TiamDesigns/Dachshund70/PROGRESS.md

# PROGRESS

## Current phase

Phase 15 (desktop packaging and auto-update) is done, and with it every phase in SPEC.md. Phases 1 to 14 and the Pup test board are merged to main. Core, host-lib, Doghouse and the desktop app's Rust tests pass locally, and the keyboard, Pup and dongle firmware build with no new warnings. Hardware testing for phases 2 to 14 waits for fabricated boards (or the Nordic nRF52840 Dongles Tiam is ordering: one runs the Pup, the other the receiver). What's left is in `SCHEDULED_TASKS.md`: bring-up and measurements on hardware, encrypting the 2.4 GHz link, and code signing for the desktop app.

## Done

### Sharp memory LCD screen (2026-11-11)

- Tiam chose the Sharp LS027B7DH01 (2.7", 400 × 240, about 173 ppi, a full frame in about 50 ms) for the wider screen column beside the 2u encoder. It replaces the 2.13" e-paper.
- Screen board rev 2.0 (`hardware/Dachshund70-Screen/`, `gen_screen.py`), same 21.0 × 34.0 mm outline and J2 position:
  - U1 TPS61222 (fixed 5 V boost, SC-70-6) from 3V3, with L1 4.7 µH and 10 µF in and out. Its EN is on J4 pin 8 (P0.24), pulled up by R1, so it stays on unless the firmware drives the pin low.
  - J1: Hirose FH12-10S for the panel's tail, which folds back under the glass's left edge (in portrait). J1 pin n = panel pin 11 − n, assumed from the fold; to check against Sharp's drawing.
  - Sharp's capacitors on VDD, VDDA and DISP; EXTMODE high (VCOM follows EXTCOMIN).
  - Hand-routed. ERC 0; DRC with parity and every severity: 0 violations, 0 unconnected.
- No mainboard change: J4's pins carry SI, SCLK, SCS, EXTCOMIN, DISP and the boost enable (the screen board README has the table).
- Firmware: new overlay `sharp-ls027b7dh01-portrait` (Zephyr's `sharp,ls0xx`, 2 MHz SPI, CS active high, EXTCOMIN at 1 Hz; 240 × 400 in portrait, 24 × 25 text cells), with a CI build. `dachshund,display-rotate` and `kb_screen_rotate()` now also handle row-tiled 1-bit panels like the Sharp's, with host tests for both layouts.
- Core and host-lib tests pass locally. The Sharp firmware build is checked by CI only. Not tested on hardware, nothing ordered. The case model still has the e-paper (`SCHEDULED_TASKS.md`).

### Screen board and FFC display port (2026-11-11) (rev 1.0, e-paper; superseded by the Sharp panel above)

- Screen options compared (OLED, faster e-paper, Sharp/JDI memory LCD); Tiam kept the 2.13" SSD1680 e-paper and chose to build our own driver board. Every SSD1680/SSD1681 panel bottoms out at about 0.3 s per partial refresh. The GDEY0213B74H (296 × 144, same outline and pins) also fits, but GoodDisplay lists it as end of life.
- New `hardware/Dachshund70-Screen/`, made by `gen_screen.py`:
  - 21.0 × 34.0 × 0.8 mm, 2 layers, every part on the bottom side, drawn in mainboard coordinates.
  - The SSD1680 boost circuit (L1 10 µH, AO3400A, 0.47 Ω sense, 3 × B5819W, 25 V caps on the ±20 V rails) and BS1 low, for 4-wire SPI.
  - J1: Hirose FH12-24S for the panel's tail. J2: FH12-8S for the cable.
  - Hand-routed, with ground pours on both sides. ERC 0; DRC with parity and every severity: 0.
- Mainboard J4: the 2.54 mm header is now an FH12-8S FFC socket on the top side at (327.9, 94.9), under the plate's screen notch. The pin order is unchanged, so `board.json`, the devicetree and the overlays didn't change.
  - Schematic: `Conn_01x08_MountingPin`, MP on GND, MPN set.
  - Board: the eight display nets were rerouted (`hardware/Dachshund70-Screen/move_j4.py` records the edit), three GND stitching vias were removed and the pours refilled. DRC: 0 unconnected items, parity clean; ERC unchanged.
- An 8-way 0.5 mm FFC with contacts on the same side at both ends loops from J4 up through the notch into J2, straight above it. J4 pin n meets J2 pin 9 − n.
- Plate: the J4 slot is gone. `gen_plate.py` was rerun; the regenerated plate also has the sock outlines on Cmts.User again.
- `export_fab.py` and `export_step.py` now include the screen board. Its STEP shares the mainboard's origin.
- Docs updated: the screen board's README, "Display" in the case README, the wiring section of `firmware/displays/README.md`.
- Not tested on hardware, nothing ordered. Open checks are in the screen board README: the panel FPC's contact side and pin 1, the tail length, the FFC length, LCSC numbers, the boost current on 3V3, and the case model update.

### Case round 5: 24 mm-neck plate, longer retainers, encoder cable, daughterboard lower, slider button, floating-plate check (2026-11-10)

- Plate: the coordinator's 24 mm necks and 2.8 arms (1d0be44) are in the model. The encoder notch now runs forward from x 305.25 to the right-hand edge, down to KiCad y 104.5 (was to x 322.25 and y 67.25): the cover's front mount, the knob's underside (it was 0.8 over the plate) and the e-paper driver's parts (0.3 over it) have no plate under them when it floats. `gen_plate.py` rerun (DRC 0), DXF re-exported, README's prong and sock numbers updated.
- Gasket retainers 64.1 × 5.2 × 4.1 (were 44.1 × 4.55), ears unchanged (±18.0, |y| 68.4, R1.0 where they meet the wider bar). One opening per nub from the ring up to the sock tops (64.3 × 5.3, z to 8.1): neck, arms and socks (5.9 past the edge), 1.25 or more round the arms, 4.0 or more of aluminium to the bezel's outside. The longer bars reached the back M3 screws at x −50.5 (0.25) and +50.5 (through it), so those two screws moved to x −61.35 and +39.5 (holes square to the plate, copied from the one at −151.5); the ring's DXF follows.
- Encoder cable (KiCad): the module's J1 faced its plug into the mainboard's notch edge. J1 now faces +u (rot 270 on B.Cu, renumbered so a parallel-wire cable is reversed: pin n to J5 pin 6 − n; the module's schematic labels follow) and the mainboard's J5 moved 3.04 forward to (329.8, 49.54), on the same line: the cable runs straight under the module, mouths 17.6 apart, about 25 mm overall, 7.4 under the plate. Its board-name silk moved clear of J5. DRC 0 unconnected and parity clean on both boards (warnings as before), module ERC 0. No MCU pin changes. Trim the encoder's pins underneath: the cable touches the push switch's uncut pins in the model. A cable stand-in (5 wires) is in the model.
- Encoder cover: the front mount moved 0.625 to x 131.2 with an R2.7 ear (was R4.0), its underside raised to z 2.9 (the mainboard floats too); the old ear's stub under the plate web is gone. Ear, screw and boss are 1.5, 2.9 and 1.7 from the plate in plan anywhere in ±1.0, and 1.39 over the mainboard. Hood outside unchanged. The foot and its two module-screw bosses stay 0.15 beside the plate's web and reliefs (they can't move without moving the module's holes and the mainboard's lobe).
- Daughterboard 1.0 lower (nothing below stopped it): underside at z 6.0 above the desk, USB-C centre at z 9.23 (were 7.0 and 10.23). The opening, lead-in, ledge, leg relief and taps moved with it (1.2 of floor under the taps, 2.0 of aluminium under the ring).
- Power switch: the small cap is now a pill button 10.7 × 6.0 × 0.85 flush with the back face, in a channel with the USB-C lead-in's outline (12.6 × 6.4, R3.2) on the USB-C's centre height; a stem on its back (0.83 below the centre line) goes through a 4.4 × 2.2 slot onto the PCM12's lever. 0.2 clear top and bottom, 0.15 off the floor, 1.5 travel; the button hides the slot at both ends. Plain pockets, no undercuts. Still a 2-position battery switch (Bluetooth or tri-mode selection is in software).
- LED guide: its block's underside is at z 7.8 and its spigots end at z 2.8, so the floating plate and PCB clear it (it hit the plate at +1.0).
- Clash check (`check_a.py` now also floats the plate, mainboard and caps ±1.0, and has `plate_clearance`): against the case, the only hit is the known one (encoder shaft in the knob's D-bore), with the keycaps at rest, pressed 4.0, at rest + 1.0 and pressed 4.0 − 1.0. Open, board against board (BOM.md): at +1.0 the mainboard hits the encoder module's PCB, which overhangs it 3.5 mm only 0.29 above it. The module can't be trimmed (the PEC12R's front tab pad reaches y 57.4) or raised (knob and hood are 0.15 apart), so it needs a deeper mainboard notch (y ≥ 60.9; a bus of tracks moves). At −1.0 a SOT-23-5 (0.78 at rest) and the battery plug touch the cell. The J4 header model touches the e-paper driver at +1.0, but no header is fitted.
- Masses: top block 424 g (446), bottom 695 g (697), retainers 23.2 g the six (14.6), cover 5.5 g (5.7), LED guide and button 1.1 g (1.4); case 1242 g without the weight, 1985 g with brass; plate 59 g (61).
- Re-exported every case STEP (the switch cap's file is now `Dachshund70-Case-Slider-Button.step`), both keycap sets, the assembly, the ring and weight DXFs, `hardware/step/` and the `.f3d`; Fusion version 37. Not tested on hardware: nothing is made yet.

### Case round 4: M2 cover screws, socket-head module screws, M3 weight screws, paw print, LEDs centred (2026-11-10)

- Status LEDs: Tiam chose option B. D3–D7 (and C14–C18) are now at KiCad x 311.75, 317.25, 322.75, 328.25 and 333.75 (y 130.5, still a 5.5 pitch), so the row is centred under the screen at 322.75 (1611d2c; the plate's LED windows moved with them). The roof's five Ø3 light holes moved from a 6.375 pitch onto the LEDs (world x 133.5 to 155.5, local y −30.95, the LEDs' own y: the holes were already on it, the −31.74 was where the tilted top face cuts them). The light guide's channels are now straight Ø2.1 bores from each LED to its hole (0.8 walls at the spigots, was Ø2.3 with an S bend and 0.7). `hardware/step/` re-exported (mainboard, plate, assembly; every part has its 3D model), and the Fusion model's plate and mainboard PCB bodies swapped for them.
- Encoder cover: its two case screws are M2 × 8 countersunk (DIN 965), were M3 × 8: same places and hidden ears, the old holes filled, 90° countersinks Ø4.0 to Ø2.2, taps Ø1.6 drilled to z 12.2 (5.4 of thread, 1.7 of metal round the front one in its Ø5.0 boss). Hood outside unchanged.
- Encoder module: both screws are M2 × 5 socket head (DIN 912, Ø3.8 × 2.0), were pan heads. The front one has 0.15 clear in the mainboard's Ø4.2 lobe (was 0.05), the back one 0.73 in the notch; the taller heads end 0.2 below the board, 4.3 above the cell, 2.9 from J5.
- Weight: four M3 countersunk (DIN 965) at the corners of the flange's ends, were 4 × M2 × 4: M3 × 6 at the back corners (±102.5, 33.0), 4.5 of thread; M3 × 5 at (±102.5, 13.0), 3.5 of thread, because the front corners are under 4 mm thick (agreed with the coordinator in place of 1.5 × d there). Countersinks Ø5.7 leave a 0.35 land in the 1.5 flange; taps Ø2.5, flat bottoms 1.0 above the desk.
- Weight engraving: the dachshund is replaced by a paw print (four toe beans over a main pad, soft rounded shapes, 46.1 × 43.2, 0.3 deep with flat floors) in the same place, above the unchanged Fredoka "Dachshund70". New DXF layers `PAW` and `TEXT`.
- Masses: weight 743 g in brass (was 744), encoder cover 5.7 g (5.6), LED guide 1.3 g (1.2), screws 13.3 g (13.1); the case is 1258 g without the weight, 2001 g with it in brass.
- Clash check (`check_a.py`, keycaps at rest and pressed 4.0): two hits in total, both known (the encoder shaft in the knob's D-bore, the switch cap's press fit). Re-exported the top, bottom, weight, cover and light guide STEPs, the assembly, the weight's engraving DXF (the ring's is unchanged) and the `.f3d`; Fusion version 36. A stray sketch of reference curves (Sketch3942, not part of any feature) at the end of the timeline is hidden, not deleted. Not tested on hardware: nothing is made yet.

### Case: current mainboard in the model, v33 encoder hood back (2026-11-10)

- The Fusion model's mainboard was the pre-#67 one (J1 over the battery, J5 at KiCad (311.4, 50.0), no corner notch). Its PCB body is now the current export (a base feature in the old occurrence, which the spacebar sets share components with), and J1, J5 and one moved 0402 are at their current places. J1 is 17.6 from the cell; the module's M2 heads clear the board (0.05 in the Ø4.2 lobe, 0.63 in the notch); J5's cable runs 17.5 along the notch to the module's JST-SH with nothing in the way. The encoder, USB-C board, plate, battery and screen already matched `hardware/step/`.
- LED guide: already on D3–D7 (even 5.5 pitch, KiCad x 313 to 335): every channel's entry is on its LED's centre (0.00 offset), so it is unchanged.
- Encoder cover: Tiam preferred the v33 shape, so above the plate it is the v33 hood again, outside unchanged (Ø19.2 half-cylinder, x 130.245 to 143.505, R1.5 closed end, the frame-ear notches). Inside, an arc coaxial with the hood keeps 0.15 to the PEC12R's top corners (9.17 from the axis, so 0.27 of wall there; v33 itself touched them), and the cavity and notches run straight through from below. Below the plate it keeps v35's mounting: 2 × M2 into the module, one M3 each side up into the top block, all out of sight. The top block's opening follows the hood again. 2.07 cm³ (5.6 g); top block 446 g.
- Clash check (`check_a.py`): two hits in total, both known (the encoder shaft in the knob's D-bore, the switch cap's press fit). Fusion version 35; re-exported the top, cover and assembly STEPs and the `.f3d`; the other parts and the DXFs are unchanged.
- Not tested on hardware: nothing is made yet.

### Power path: ngspice simulation, R3 to 10k (2026-11-09)

- New `hardware/sim/power-path/`: an ngspice model of the daughterboard and mainboard power path (F1, USBLC6, SW1, the cable, D8, Q1, R3, the MCP73831, the module's and LEDs' loads) and `run.py`, which runs battery-only, USB-only, charging, plug-in and unplug cases. Results and limits are in its README; the nRF52840 and firmware are modelled as a fixed load.
- R3 (Q1 gate pull-down) is 10k (UNI-ROYAL 0603WAF1002T5E, C25804, basic part), was 100k. With 100k, D8's reverse leakage (tens of uA) lifts Q1's gate on battery enough to leave Q1 half on or off, so the keyboard runs through the body diode (0.6 V lost), and after unplugging USB VSYS sat on the body diode for 0.2-1.9 s, or stayed there with a high-threshold Q1 and a low cell. With 10k the switchover takes 11-47 ms and Q1 stays fully on. Same footprint and position; DRC and ERC unchanged.
- Found, not changed: charging plus every LED on full draws about 552 mA from USB (above the 500 mA in the descriptor, under F1's 750 mA hold). Not tested on hardware.

### PCBs: full DRC and ERC pass, JLCPCB check (2026-11-09)

- Ran kicad-cli 10.0.8 DRC (every severity, schematic parity, zones refilled) and ERC on all five boards, then again with a JLCPCB 2-layer rule set added on a copy (0.127 mm track and gap, 0.3 mm via drill, 0.45 mm via pad, 0.13 mm via ring, 0.3 mm copper to edge, hole spacing). No errors, 0 unconnected items, zone fills current, no copper, drill or edge rule broken on any board.
- Fixed: the mainboard's J5 (encoder JST SH) used a symbol without the mounting-pad pin, while its PCB tabs are on GND. It now uses `Conn_01x05_MountingPin` with MP on GND (`#PWR04`), the same as J1, which clears the two `net_conflict` parity warnings.
- Synced the symbol fields (MPN, LCSC, Description, Datasheet) onto the footprints of the mainboard, daughterboard, dongle and encoder module, as KiCad's Update PCB from Schematic would. The fields are hidden; gerbers, drills, BOM and CPL from `export_fab.py` are unchanged (checked by diffing the exports before and after).
- The deliberate spacebar overlaps (SW604/SW606/SW615, ST4/ST5/ST6) are now waived by a rule in `Dachshund70.kicad_dru` (the old project-file exclusions no longer matched after the board moved). The two co-located ST4/ST6 holes are exclusions in the `.kicad_pro`. New `.kicad_dru` files on the daughterboard and dongle waive the USB-C and slide switch silk that crosses the board edge (the fab clips it).
- Left as they are: 195 "footprint differs from library" warnings (the bottom-side parts are flipped, and the hot-swap holes differ by 1 nm; pads otherwise match), ERC's power-symbol and label name notes and library symbol mismatches, and the stock hot-swap footprint's 0.44 mm web between the 1.75 mm peg hole and the 3.05 mm socket hole (every Kailh MX hot-swap board has it; JLC drills it). Silk text is 0.8 to 0.9 mm tall with 0.12 mm strokes on all boards, below JLC's 1.0 mm / 0.15 mm guideline, so small labels may print faint.

### Case: weight text in Fredoka SemiBold, Fusion v33 (2026-11-04)

- The weight's "Dachshund70" is now Fredoka SemiBold (SIL OFL, the font of the project slideshow and the "Doghouse Boards" PCB logo), same size and centre (x -76.2 to -23.8 on the weight, was Arial Rounded MT Bold). Fusion v33. The text engraving is 0.3 deep; the strokes are about 0.9 mm, so a 0.6 mm cutter follows them.
- Re-exported from v33: `Dachshund70-Case-Weight.step`, `Dachshund70-Weight-Engraving.dxf` (15 text loops, as before), `Dachshund70-Case-Assembly.step`, `fusion/Dachshund70-Case-rev2.f3d` and the weight close-up render. `build_case2.py` now sets `Fredoka SemiBold`; to run it, install the static SemiBold (made from the variable TTF in google/fonts `ofl/fredoka`) before starting Fusion, since Fusion only reads its font list at launch.
- Lesson: rolling the Fusion timeline back and forward recomputes it and resets every imported occurrence to the origin. `post_build.py`'s `stage2()` puts them back (it adds no timeline items). Caveat: the `post_build.py` in the repo assumes the keycap STEP files are in the final desk frame (as exported now), but the model's keycaps were imported from the old 7 degree files and need the `keycap_matrix()` lift, so v33 was restored with the original script; a rebuild from the repo's scripts and the new keycap files should use the identity placement. Changing the font also left the text extrusion with a reference failure; re-pointing its profile at the sketch text fixed it.
- Not tested on a machine: nothing is engraved yet.

### Case: rev 2 designed in Fusion and exported into the repo; CadQuery case removed (2026-11-03)

- The case is now the Fusion model "Dachshund70 case rev2" (v31): 4° (was 7°), top and bottom aluminium blocks with an accent ring between them, a stepped floor, a 52 x 34.5 battery laid flat under the screen and knob, a brass weight (face 185.0 x 30.6 with R4 corners, flange 216.0 x 46.5 with R5, four M3 x 5 screws at x +/-103.5, y 2.5 and 22.5, 331 g), a knob and encoder cover, a power-switch slider cap and an LED light guide. `hardware/case/README.md` has the dimensions and `BOM.md` every part.
- New in `hardware/case/`: `fusion/Dachshund70-Case-rev2.f3d` (58 MB), `fusion/scripts/` (the Python that builds and exports the model; paths stripped, edit `REPO` first), `step/` (eight part STEP files at their assembly positions, the 64 MB assembly with boards, plate, battery, screen, keycaps and case, and both keycap sets), `dxf/` (the ring for the laser, and the weight engraving: dog and text) and five renders.
- Removed: `gen_case.py`, `render.py`, `assembly.py` and `keycaps.py` (Tiam chose to drop the CadQuery design; the keycap sets now come out of Fusion instead of `keycaps.py`), the 23 old renders, and the rev 1 outputs that no longer match a part: `Dachshund70-Case-Panel.step`, `Dachshund70-Gaskets.step` (eight socks), `Dachshund70-Weight.step` (dog bone), `Dachshund70-Plate-Foam.dxf`, `Dachshund70-LED-Seal.dxf`, `Dachshund70-LED-Plugs.step`, `Dachshund70-LED-Guide.step` and `Dachshund70-Switch-Cap.step` (replaced by `Dachshund70-Case-*` versions), and the old `Dachshund70-Keycaps*.step` (7 degree frame; replaced by ones from Fusion). Older entries below mention `gen_case.py`; they describe rev 1 and are kept as history.
- Not tested on real hardware or with real parts: nothing is machined, printed or fitted. The rebuild path (`build_case2.py` then `post_build.py`) was not re-run end to end after the scripts moved into the repo, so the `.f3d` is the dependable copy. The assembly's screen, battery and knob are stand-ins.
- Open: the J2 lead route and the PCM12SMTR availability are in `SCHEDULED_TASKS.md`.

### Plate: merged with main, 2.0 mm web beside the Delete cutout (2026-11-03)

- `claude/plate-branched-tabs` now merges `origin/main` (PR 67's corner notch and the rename of firmware, app and docs), keeping main's notch bottom (`ENCODER_BOX` 55.7), `POST_RELIEFS` (306.6, 41.7) and (306.6, 57.8), and this branch's gasket nubs.
- Tiam approved a wider web: `NOTCH_LEFT` goes from 304.0 to 305.25, so the plate web beside the Delete cutout (right edge at x 303.25) is 2.0 mm instead of 0.75 (the mainboard's own notch stays at 304.0). Checked against the encoder module: its board runs under the web at z 1.8 to 3.3 and the plate is at z 5.0 to 6.6; its connector, pins and frame ears all stand in the notch (x from 314.6, y 42.7 to 56.3); the module's M2 posts get `POST_RELIEF_D` 3.8 (the case's bosses are dia 3.4; was 5.2), which leaves 1.45 mm of web at the two reliefs.
- Plate regenerated with KiCad 10's Python on main's boards; kicad-cli DRC 0 violations, 0 unconnected; Plate and Assembly STEP and the polycarbonate DXF regenerated. Not fabricated.
- Merged `origin/main` again after PR 69 (the PCB projects renamed to `hardware/Dachshund70/`): `MAINBOARD` in `gen_plate.py` already points at `../Dachshund70/Dachshund70.kicad_pcb`. Regenerating against it gave the same plate (only fresh UUIDs) and DRC still shows 0 violations, so the plate, DXF and STEP files are unchanged; the plate files kept their Dachshund60F names until the rename thread renames them.

### Plate: gasket prongs parallel to the edge (2026-11-03)

- Tiam: the gaskets pointed out toward the case wall; they should lie parallel to the plate edge so they fit the bezel. Each arm's prong now continues the arm along the edge (2.8 mm wide, 6.5 mm long, centred on the arm) instead of pointing outward, and the sock lies along the edge from the arm's end (8 mm, open end at the arm's end). `SLOT` is 2.0 mm (was 1.2) so a 5 mm sock centred on the arm stays 0.25 mm off the plate edge; the nub now reaches 4.15 mm past the edge (sock 5.25 mm) instead of 9.2 (10.7).
- `gen_plate.py`: `PRONG_START` replaces `PRONG_OFFSET`; the socks list is (x start, x end, y centre). Plate regenerated with KiCad 10's Python, DRC (kicad-cli) 0 violations, 0 unconnected; Plate and Assembly STEP and the polycarbonate DXF regenerated. Not fabricated, not tested on hardware. Nub centres are unchanged.

### Plate: branched gasket nubs (2026-11-02)

- Tiam's correction: the forked tabs were read wrongly. Each of the six positions is now one nub that branches: a 4 mm neck leaves the plate edge, then splits into two 1.5 mm wide, 12 mm long arms running back along the edge in opposite directions (a T), with a 1.2 mm slot between each arm and the plate edge, so each arm is a cantilever held only through the neck. The free end of each arm carries one prong (2.8 x 6.5 mm, pointing outward, flush with the arm's end): still twelve gaskets, on six nubs. Estimated stiffness at the prong about 15 N/mm in 1.6 mm FR4 (3EI/L^3, E ~ 20 GPa).
- Nothing is cut into the plate's switch area; the nub lives entirely outside the outline. Sock outlines on Cmts.User now start at the arm's outer face (2.7 mm past the plate edge) and reach 8 mm past it. Nub centres unchanged (bottom -106.17, 0, +106.17; top -107.7, -15.0, +77.7); prongs sit +-12.6 mm from each. Parameters in gen_plate.py: NECK_WIDTH, SLOT, ARM_WIDTH, ARM_LENGTH, FRONT_NUBS, BACK_NUBS.
- The first version of this change lost the arms: the outline's 1.0 mm outside-corner rounding is an opening, which erases anything under 2.0 mm wide, so the 1.5 mm arms vanished and only the necks and prongs were left. OUTLINE_OUTSIDE_RADIUS is now 0.7. Checked on the outline points (arms at x 164.25..192.25 beside the centre-front nub) and in a section of the case model.
- kicad-cli DRC 0 violations; Plate and Assembly STEP and the polycarbonate DXF regenerated (the Assembly also carries the USB daughterboard and mainboard from the power-switch branch). Not fabricated.
- Case (Fusion): the 12 sock pockets move to the arm ends and each nub gets a 0.5 mm clearance pocket in the top shell.

### Mainboard: corner notch, J5 to the right of it, D3 moved (2026-11-03)

- For the case thread's Fusion v27 (module mount and battery bay), with their choices: the top-right corner is cut away by a notch open to the top edge, x 304.0 to 326.4 and y 39.0 to 57.0, with a 4.2 mm lobe at (306.6, 57.8) for the module's lower M2 screw head (the post is at y 57.82). The case's first notch (down to y 60.8) cut a bundle of MCU lines that has no room to go round, so the case thread chose this shallower one; the lobe is the one thing still in that bundle's way.
- Gone from the mainboard: J5's old spot, the two clearance holes (MH1, MH2) and the cable slot. J5 (5-pin JST SH, back) is now to the right of the notch: pad row at x 331.8, y 44.5 (pin 5) to 48.5 (pin 1), body toward -x, cable into the notch; courtyard about x 326.9 to 333.1, y 41.9 to 51.1. The case thread checked it is 2.4 mm above the battery. C10, C11 and D114 stay.
- Rerouted with the grid router (see "J1 moved" below): COL7, COL10 and ROW0 on the front now pass under the lobe (y about 61.3 to 62.5); COL14 (the push switch's matrix line) reaches J5 pin 1 on a long lane through the top-right corner, because the bundle around the MCU's decoupling caps leaves no other way; ENC_A, ENC_B and ENC_SW run from J5 to C10, C11 and D114; the notch also needed the dangling spurs cut back. The router and its helper scripts are not committed.
- LEDs: D3 moves from x 310.5 to 313.0 (its capacitor C14 with it); D4 to D7 stay at 318.5, 324.0, 329.5 and 335.0, so the pitch is an even 5.5 mm (Tiam's spacing; the case's light guide fans the light out). C14's reference text is unchanged; one stitching via that D3's move put on the DIN_BUF pad was removed.
- `gen_plate.py`: the plate's notch is now x ≥ 304.0, y ≤ 57.0 (`NOTCH_LEFT`, `ENCODER_BOX`), with `POST_RELIEFS` at (306.6, 41.7) and (306.6, 57.8); the web beside the Delete cutout is 0.8 mm. DRC with every severity: 217 items (was 219), 0 unconnected, no new ones; ERC unchanged. STEP files refreshed.
- Back-silkscreen texts that sat on the notch and J5 moved below J5. Not ordered, made or fitted.

### Mainboard: J1 moved to the front sidebar (2026-11-03)

- For the case thread's rotated battery bay (Fusion v27): J1, the 6-pin JST SH port for the daughterboard cable, leaves (331.0, 87.0), which sits under the cell, and goes to the front sidebar: pad row at x 335.5, y 116.0 (pin 6) to 121.0 (pin 1), body toward -x, courtyard x 330.2 to 336.8, y 113.6 to 123.4. All six nets are rerouted: VBAT and VBAT_SW to their old stubs by Q1 and TP3, VBUS to the Q1/D8 copper, and USB D- and D+ on 30 mm lanes down the right edge, GND to the pour. Done with a small grid router written for this (not committed). DRC with every severity: 219 items (same as before), 0 unconnected; ERC unchanged. STEP files refreshed.
- The corner notch (x 304.0 to 326.4, y 39.0 to 60.8), J5's move and the LED respacing are not done; see the thread. The notch cuts the bundle of DISP_*, SWDIO, SWDCLK and ROW0 lines that wraps over the MCU's decoupling caps, and the router found no way round it.
- Not ordered, made or fitted.

### Encoder module and cable slot moved 0.595 mm west (2026-11-03)

- For the case thread's 4° case (Tiam approved): the module's left edge u0 goes from KiCad x 304.5 to 303.905, so the two 4.2 mm screw-head holes move from x 307.2 to 306.605 (y 41.7 and 58.3 unchanged) and the 6.0 × 2.5 mm cable slot moves to x 303.005 to 309.005 (y 48.75 to 51.25). COL14 on the back now runs down x 303.8 instead of 304.4, to stay clear of the moved lower hole. DRC with every severity: 219 items (was 218): the one new message is SW113's front silkscreen outline (x 303.32) being clipped by the slot's new edge. 0 unconnected.
- Daughterboard height: the USB daughterboard now sits 4.5 mm lower in the case. Nothing on the boards changes: J1 and J2 and the 6-pin SH cable are flexible, so it only needs a cable long enough for the new path (suggest 100 mm).
- J5 and the battery cell: the cell (KiCad x 281.0 to 337.5, y 41.0 to 76.0 under the back) covers the whole right strip where J5 could sit, and J5 is 2.96 mm tall, so it sits 0.65 mm into the cell's top. No move on the board clears it; see the thread for the options. Not changed yet.
- Not ordered, made or fitted.
### Mainboard logo in Fredoka (2026-11-04)

- Tiam asked for the PCB and weight logos in the font of the YouTube slideshow, whose Doghouse Boards wordmark and headings are Fredoka (SIL OFL). The mainboard's back logo line "Dachshund70  Rev 1.1" is now Fredoka SemiBold polygons (was URW Gothic Book), at the same cap height (4.68 mm) and on the same baseline as "Doghouse Boards" (already Fredoka Bold). The logo was re-centred and stays inside its old footprint (x 113.7–247.3, y 56.0–64.0).
- The small KiCad-font labels on the USB-C board, dongle, encoder and plate stay in KiCad's font: at 0.8–1.2 mm, Fredoka's strokes would be thinner than JLC's 0.15 mm silkscreen minimum.
- The weight engraving moves to Fredoka in the Fusion case model (case thread).
- Not run here: KiCad DRC (no kicad-cli in the cloud container). Only silkscreen polygons inside the old logo area changed.

### Renamed to Dachshund70: repo links (2026-11-04)

- Tiam renamed the GitHub repo to TiamDesigns/Dachshund70. Doghouse's update check (`APP_REPO`), the desktop app's releases link and the UF2 drive's index link now use the new name. GitHub redirects the old URLs, so Doghouse 0.1.3's auto-update keeps working.

### Renamed to Dachshund70, part 3: plate, STEP files and case outputs (2026-11-03)

- `hardware/Dachshund70-Plate/` (project, PCB, outline DXF, `gen_plate.py` title block and silkscreen "Dachshund70 plate rev A"), every STEP file in `hardware/step/` and `hardware/case/step/` (file names and the product names inside them), the foam and LED seal DXFs, and the names in `export_step.py` (its temporary old-name mapping is gone), `export_fab.py`, `gen_case.py`, `keycaps.py`, `assembly.py` and the case README and BOM.
- `gen_case.py`'s `ENGRAVE_TEXT` is now "Dachshund70", but the committed case STEP files were not regenerated here (no CadQuery run in this container), so the engraving geometry in `Dachshund70-Weight.step` still spells the old name. (Superseded: the case files were regenerated from Fusion, with a new weight.) The case is moving to Fusion, whose export replaces these files; otherwise rerun `gen_case.py`. Likewise the plate PCB's silkscreen text was renamed in the file, and rerunning `gen_plate.py` gives the same result.
- Fix: part 1 had pointed Doghouse's update check (`APP_REPO`), the desktop app's releases link and the UF2 drive's index link at `TiamDesigns/Dachshund70`, which doesn't exist until the repo is renamed. They point at `TiamDesigns/Dachshund60F` again; GitHub will redirect them after the rename.
- Nothing in the repo says Dachshund60F any more except those three links, the README's note, the dated 2026-10-26 project review and git history. The repo name itself is Tiam's step (`SCHEDULED_TASKS.md`).

### Renamed to Dachshund70, part 2: the PCB projects (2026-11-03)

- The mainboard, USB-C daughterboard, dongle and encoder module projects are now `hardware/Dachshund70/`, `Dachshund70-USB/`, `Dachshund70-Dongle/` and `Dachshund70-Encoder/`, with their `.kicad_pro`, `.kicad_sch`, `.kicad_pcb` and `.kicad_dru` files, the schematic sheet instances, title blocks and notes renamed to match. The project footprint library is now `lib/Dachshund70.pretty`, nicknamed `Dachshund70` in `fp-lib-table` and in the D2–D7 footprint references.
- Silkscreen: the USB-C daughterboard and dongle labels say "Dachshund70". The mainboard's back logo (filled polygons) now reads "Doghouse Boards  Dachshund70  Rev 1.1": the "6" became a URW Gothic Book "7" at the same size and baseline, the "F" is gone, "Rev 1.1" moved up to close the gap, and the whole logo was shifted 1.54 mm to stay centred where it was.
- `export_fab.py` writes `Dachshund70*` order files for the four renamed boards. `export_step.py` and `gen_plate.py` read the renamed mainboard; the STEP files keep their old names until part 3.
- Not run here: KiCad DRC and ERC (no kicad-cli in the cloud container). Only names, the logo polygons and text changed, so the results should be the same; worth a DRC pass when the projects are next opened.
- Part 3 waits for the case thread's plate branch: the plate project, the STEP files, and the case and keycap outputs.

### Renamed to Dachshund70, part 1: firmware, app and docs (2026-11-03)

- Tiam renamed the project from Dachshund60F to Dachshund70. This change covers everything outside `hardware/`: the Zephyr board is now `dachshund70/nrf52840` in `boards/Dachshund70/`, the USB product strings are "Dachshund70" and "Dachshund70 Receiver", the Bluetooth name and DIS model are "Dachshund70", and the UF2 board ID is `nRF52840-Dachshund70-v1` (no board had been flashed, so nothing old needs to keep working). The host library and Doghouse packages are `@dachshund70/…`, and Doghouse is bumped to 0.1.4 because 0.1.3 doesn't know a board called Dachshund70.
- The "Dachshund" manufacturer name, the DACHSHUND UF2 drive label and the dog in Doghouse stay as they are. The 2026-10-26 project review keeps the old name, and the README notes it.
- Still to do: the KiCad projects, silkscreens, STEP files, fab exports, and the plate and case scripts (`SCHEDULED_TASKS.md`), then the GitHub repo name (Tiam).

### Power switch moved to the USB daughterboard (2026-11-03)

- Tiam's call: the battery slide switch (C&K PCM12SMTR, SPDT, used as an on/off in the VBAT to VBAT_SW line) leaves the mainboard and goes on the USB daughterboard, so it is reached from the back of the case.
- Cable: the mainboard J1 and the daughterboard J2 are now JST SH 6-pin (SM06B-SRSS-TB(LF)(SN), LCSC C160405) instead of 4-pin. Pins 1 to 4 stay where they were (VBUS, D-, D+, GND); pin 5 is VBAT and pin 6 is VBAT_SW. A pin-for-pin 6-way cable is needed.
- Daughterboard (`hardware/Dachshund70-USB/`, rev 1.1): 54 × 9 mm (was 42 × 9; the extra 12 mm is on the right, so the USB-C stays at x 121 and H1 at x 104.5). H2 moved from x 137.5 to 140.0 to make room for the wider J2. SW1 sits on the top side at x 148.4 (pad row y 104.0, footprint origin y 102.4), actuator out of the back (top) edge by 0.75 mm and sliding along it; the 3D model is 7.7 mm wide, 1.5 mm tall. VBAT_SW runs from J2 pin 6 over the top of H2 on the front; VBAT drops from pin 5 through a via and runs along the bottom edge on the back to a via by the switch. Which way the knob must slide to switch on is not checked: pad 2 is the common, the knob at the left (-x) end is the throw on pad 3 (unused), and on the right end it joins pad 1 (VBAT). Check it with a meter on the first board. DRC: the only messages are SW1's silkscreen crossing the back edge, like the USB-C's already did; 0 unconnected. ERC and parity clean.
- Mainboard (rev 1.1): SW1 is removed; J1 is the 6-pin port at (331.0, 87.0) mm on the back with pins 5 and 6 routed down the right edge to where the switch's pads were (VBAT at x 335.4, VBAT_SW at x 336.4). The GND via at J1's pin 4 moved 1 mm east. DRC with every severity: 218 items (was 222), 0 unconnected; ERC unchanged.
- STEP exports for the mainboard, assembly and daughterboard refreshed. Docs updated: bring-up plan, boards README, design decisions. The case README and generator still describe SW1 on the mainboard; the case thread owns those.
- Not ordered, made or fitted.

### Encoder module: 20 mm shaft, PEC12R-2220F-S0024 (2026-11-02)

- Tiam asked for a shorter shaft, so SW1 on the encoder module is now the Bourns PEC12R-2220F-S0024 (20 mm shaft, same body, footprint and pins as the 30 mm -2230F-S0024 it replaces). Schematic value, MPN and LCSC (C49673168, which showed no stock on 2026-10-28, so JLC may have to source it globally or you solder it by hand), the PCB's value field and the docs are updated.
- 3D model: `gen_models.py` now builds `Bourns_PEC12R-2x20F-S_standin.step` (flat length F = 7.0 mm from the datasheet table; the shaft tip is at footprint x = -16.5, 10 mm shorter than before). The 30 mm model is gone. On the module the shaft tip is at u = 31.5 (hub end and board outline unchanged at u = 22.5, axis 10 mm above the PCB top). The module STEP is refreshed; the mainboard has no encoder, so its STEP files are unchanged.
- Module DRC and ERC: nothing new (0 errors, 0 unconnected; the same library-mismatch and MPN-field notes). The BOM and CPL list SW1 with C49673168.
- Not ordered, made or fitted. The case thread's roller and cover follow the shorter shaft.

### Plate: forked gasket tabs and encoder-post reliefs (2026-11-02)

- Tiam's call: six forked tabs instead of eight single ones, so twelve gaskets, all seated in the case's top shell. Three forks on the top (back) edge and three on the bottom (front) edge, two prongs each, 7 mm apart centre to centre; a prong is the old tab (2.8 wide, 6.5 long, 1.6 mm FR4). The 2 mm slot Tiam asked for becomes 4.2 mm between 2.8 mm prongs at 7 mm pitch (the 5 mm socks need that pitch).
- Fork centres from the plate middle (x = 0 at the USB-C): bottom -106.17, 0, +106.17; top -107.7, -15.0, +77.7. The top can't be symmetric: the encoder notch takes the top edge's right-hand end and the USB-C is at x = 0. Mainboard x of the prongs: top 67.05, 74.05, 159.75, 166.75, 252.45, 259.45; bottom 68.58, 75.58, 174.75, 181.75, 280.92, 287.92. Nothing on the mainboard's front side is near either edge.
- Two Ø5.2 reliefs in the plate for the encoder module's M2 posts, at mainboard (307.2, 41.7) and (307.2, 58.3). The one by the top edge is a slot open to that edge (a circle would leave a 0.1 mm sliver). Web to the Delete cutout 1.4 mm.
- `gen_plate.py`: parameters `FRONT_FORKS`, `BACK_FORKS`, `PRONG_PITCH`, `POST_RELIEFS`; the corner-radius check now only counts the outline's four corner arcs (the mainboard's new cable slot also has R1.0 arcs, which made the script stop). Plate regenerated with KiCad 10's Python, as the README says (the KiCad MCP wasn't reachable from this session, and the .kicad_pcb was not edited by hand). DRC (kicad-cli): 0 violations, 0 unconnected.
- STEP files refreshed (all components with their 3D models, `--subst-models`; no part was missing a model): mainboard, plate (forked tabs and reliefs), assembly, USB daughterboard, dongle and encoder module. New `Dachshund70-Battery.step` (803450 LiPo, 50 x 34 x 8 mm, with protection board, two leads and the JST-PH plug) and `Dachshund70-Screen.step` (GDEY0213B74 2.13 inch e-paper panel, flex, and the Adafruit eInk Breakout Friend), both modelled to the datasheet sizes (no vendor models were downloaded) in Fusion and exported from there, not by `export_step.py`. Origin of the screen model: the middle of the glass, glass top at z = 0.
- `Dachshund70-Plate-outline.dxf`: the plate's Edge.Cuts for a polycarbonate plate cut from the same outline.
- Not done: `hardware/case/gen_case.py` still builds eight tabs and sockets. (That script has since been removed; the Fusion case has twelve sockets.)

### Mainboard Rev 1.1: encoder off the mainboard, new encoder module (2026-11-02)

- Tiam's calls: nothing is ordered yet, so the mainboard is updated in place as Rev 1.1 (silk "mainboard v1.1" and the logo's "Rev 1.1"); keep the Bourns PEC12R-2230F-S0024 and ignore the click along the shaft; JST SH connectors; no extra expansion-port breakouts, only the rotary change.
- Mainboard: SW3 is gone. J5 (JST SH 5-pin, side entry, SM05B-SRSS-TB) replaces it on the back at x 313.4, y 48.0 to 52.0 mm (pin 1 at y 52.0), cable leaving toward -x: pin 1 COL14, 2 ENC_A, 3 GND, 4 ENC_B, 5 ENC_SW. The old routes were reconnected to J5's pads; C10, C11 and D114 stay on the mainboard, so P0.11/P0.12 and the matrix push switch are unchanged and the firmware, `board.json` and Doghouse don't change. Zones refilled. DRC with every severity: 221 items (was 222), 0 unconnected, no new ones; schematic parity shows only the missing-MPN-field notes that every part already had. ERC unchanged.
- New project `hardware/Dachshund70-Encoder/`: 22.5 × 22.0 mm, the same PEC12R footprint and model (SW1, shaft along +u, hub end at the board edge, axis 10 mm above the top), J1 (JST SH 5-pin) on the bottom side leaving at the -u edge, two M2 holes at (2.7, 2.7) and (2.7, 19.3), GND pours. DRC and ERC clean apart from the same library-mismatch and MPN-field notes. Layout and pinout in its README. Built with a script in the session, not committed; edit it in KiCad from here.
- `gen_plate.py` read the encoder's courtyard from the mainboard; it now uses a fixed `ENCODER_BOX` with the old values, so the plate is unchanged. `export_fab.py` and `export_step.py` include the module. STEP exports refreshed for the mainboard, assembly and the new module (the USB, dongle and plate files are untouched).
- `.mcp.json` pointed the Konnect server at `OneDrive\Documents\KiCad`, which doesn't exist now that the files moved to `Documents`; it points at `Documents\KiCad`. Restart the session for the KiCad tools to connect.
- Docs updated: boards README, bring-up plan, design decisions, plate README, root README. The case README and generator still describe the encoder on the mainboard; the case thread owns those.
- Cable slot (the case thread's request): a 6.0 × 2.5 mm slot with 1 mm corner radius, centred at KiCad x 306.6, y 50.0 (x 303.6 to 309.6, y 48.75 to 51.25), just left of J5's body, so the cable passes from the back to the module above. It was moved 1.6 mm right of the requested x 305 to clear SW113's mounting hole and silkscreen; J5's back silkscreen outline is removed because the slot would clip it (DRC now reports J5's footprint as differing from the library, nothing else new). Zones refilled; DRC 222 items, same count as before, 0 unconnected.
- Two 4.2 mm clearance holes for the module's M2 screw heads (the module sits only 0.2 mm above the mainboard, left edge at x 304.5), at (307.2, 41.7) and (307.2, 58.3), as the case thread asked. The upper one fits as is. The lower one sat on /ROW0, /COL7 (front) and /COL14 (back), and a 1 mm move in x couldn't clear them, so those were rerouted: ROW0 and COL7 on the front go over the top of the hole (ROW0 at y 54.96, COL7 at y 55.5, 45° bends), COL14 on the back runs down x 304.4 on the hole's west side, and the GND via at (304.8, 57.15) is gone. DRC with every severity: 222 items, the same count as before, 0 unconnected. `gen_plate.py` only counts the outline's corner arcs now, since the slot has arcs of its own; the plate output is unchanged.
- Not ordered, made or fitted.

### Case: Fusion review changes (2026-10-29)

- Thumb scoop: it now keeps falling right to the front edge (about 29° to the bezel where it meets the roll) instead of levelling out there. The fall is the quintic Bezier 0, 0, 0, 1/3, 2/3, 1 times the 3.5 mm drop, and the top surface carries straight on past the edge, so the surface stays one C2 patch.
- Screen and LEDs: the e-paper glass is centred on the sidebar as seen from above (`SIDEBAR_MID`, x 146.86), 2.06 mm further right. It reaches 1.75 mm into the end wall, in a slot up from the seam so a cutter reaches it. The driver board moves 1.2 mm right (1 mm clear of the antenna). The LED holes follow the mainboard's new LED positions (#61), and a 0.6 mm V score across the roof sits in the 8 mm gap after D3.
- Light guide: the machined LED block is gone. In its place is a 3D-printed guide (`Dachshund70-LED-Guide.step`) with a 3.2 mm channel over each LED, and five clear plugs (`Dachshund70-LED-Plugs.step`: 2.9 mm through the 3 mm roof holes, flush, on 4 × 1 mm heads in counterbores in the guide). The plugs locate the guide. The LED seal follows the guide's outline. The screen frame got a notch over J4's header, which it had been touching.
- Underside: 8 screws (was 12) at x = ±50.5 and ±151.5 front and back, 4 SKUF feet (was 8) at x = ±101, and the dowels moved over the feet. Screws and feet keep one 50.5 mm rhythm with the weight in the middle.
- Weight: an 80 × 64 mm brass block flush in the bottom, stepped 3–10 mm thick to leave 2 mm of floor under the floor's steps, about 285 g. Four M3 × 5 button heads from inside hold it. Its face is engraved 0.3 mm deep with a single-line dachshund and "Dachshund70" (Inter Display Medium), reading upright when the board is turned over front to back. The step corners where it meets its pocket are rounded to match the pocket's.
- Power switch: every pocket (flange, stem window, grip recess) is now the part's length plus the 1.5 mm travel plus 0.25 mm at each end, centred on the switch's middle. So at on and at off the switch's detent holds the cap with the grip just short of the recess wall (it allowed 1.5 mm of travel each way before). No off-the-shelf extension fits a PCM12, so the cap stays a made part.
- New renders: 22-bottom-plan and 23-weight. BOM and README updated.
- Not made or fitted.

### Mainboard: status LEDs moved right, wider gap after D3 (2026-10-29)

- The five status LEDs on the back moved right, with more room between the layer LED and the battery gauge (Tiam's call; the case gets a notch in the gap): D3 310.0 → 310.5, D4 316.5 → 318.5, D5 322.0 → 324.0, D6 327.5 → 329.5, D7 333.0 → 335.0 (y 130.5). The gap after D3 is 8.0 mm (was 6.5); the battery LEDs keep their 5.5 mm pitch. Each LED's light cutout and its 100 nF cap (C14–C18) moved with it.
- Rerouted: the battery group's data links, GND stubs and VDD bus moved with it; new D3 → D4 link, VDD feed under C15, D3's supply, and its buffered data input, which now comes up left of C14 and runs down right of D3's cutout. D7's DOUT run is longer by 2 mm. A GND stitching via at (323.85, 133.35) that D5's pads now straddle is gone, and D7's silkscreen reference moved under it, off the board edge. Zones refilled.
- D7's cutout is now 0.8 mm from the board edge (its pads 1.1 mm).
- DRC (kicad-cli, with schematic parity): 0 errors, 0 unconnected items, 0 parity issues; with every severity, the same 222 items as before. Plate regenerated (its LED windows follow the LEDs); STEP exports refreshed for the mainboard, plate and assembly. `keyboard.json`'s indicator positions follow the new x (15.25, 15.67, 15.96, 16.24, 16.53 u).
- The case follows in "Case: Fusion review changes" above (case-local x = KiCad x − 178.25: 132.25, 140.25, 145.75, 151.25, 156.75).
- host-lib tests: 139 pass, 1 fails ("WebHID: a dongle waits for its keyboard…"), which fails the same way without this change.

### Case: deeper F-row bezel (2026-10-29)

- The bar between the F row and the number row and the posts after Esc, F4, F8 and F12 were only the roof's 1.5 mm deep. They now run down as ribs, on the same plan footprint (1 mm from the keycaps), to 1 mm above the plate (`F_ROW_RIB_CLEAR`). Checked against the board's models: 1.1 mm to the plate, 2.2 mm to the switch housings, nothing else nearby (stabilizers, LEDs and the foam are elsewhere or under the plate).
- Not made or fitted.

### Case: screws front and back, narrower ends, gasket seats, dowel pins, case BOM (2026-10-29)

- Screws: twelve M3 × 10, six along the front and six along the back at x = ±26.5, ±79.6 and ±132.7 mm (an even 53.1 mm pitch, 13.3 mm from the nearest sock), none in the ends.
- End bezels 9 → 6.5 mm, so the case is 331.5 mm long. The wheel is 21 mm wide (was 23.5) and still ends 0.25 mm inside the end face; its slot is 0.3 mm round it (was 0.5).
- The polycarbonate panel has no screws: its floor laps 4 mm over a ledge in the aluminium, and the tongue now runs over it (it stops only at the power switch and the roller's notch).
- The seam moved up 1 mm, so each sock sits 1 mm deep in a seat in the bottom case and stays put while the top goes on.
- Two 3 mm × 8 mm dowel pins at the front-left and back-right corners locate the top case: pressed into the bottom, sliding in the top, one hole slotted.
- F-row posts fixed: they ran about 5 mm past the bar, under the number row's caps (1, 5, 9 and Backspace touched at 0 mm and couldn't travel). They now stop at the bar.
- New `hardware/case/BOM.md`: the case's made and bought parts, screws, pins, feet, socks, foams, battery, screen, cable, switches, stabilizers, keycaps, and the PCBs as line items.
- Not made or fitted.

### Case: continuous-curvature top edge, deeper scoop, CNC rules, tongue and groove, tighter radii, F-row bezel, feet (2026-10-28)

- Top edge: the 4 mm round fillet is now a 1.5 mm roll with the corners' superellipse profile (`TOP_ROLL`), so the wall, the roll and the top meet with no change in curvature. `outer_shell` builds it as a loft through sections of that curve round the outline, onto a top surface that is one exact B-spline patch.
- Thumb scoop: a 2.5 mm flat land in front of the key opening, then a quintic fall to 3.5 mm lower at the front edge (was 2.5 mm, starting at the opening). Front height 14.2 mm.
- CNC rules for the aluminium halves (3-axis, 6061): `cnc_round` finds every sharp inside corner along a cutter's axis and rounds it (a third of the depth, at least 1 mm); the screen's pockets have 2 mm dog-bones; the LED block matches the frame's width; the switch pockets in the polycarbonate panel are rounded along X (and the cap to match); the panel's split has 1.5 mm corners. Walls of at least 1 mm: hump 10.3 mm radius, screen frame 1.3 mm, and the 0.1 mm sliver between the USB-C board's pocket and its opening is gone. Heat-set inserts are now tapped M3 (2.5 mm drill, 5 mm of thread; 4.8 mm for the USB-C board). The opening's chamfer is cut by a 45° flare instead of a chamfer operation.
- Tongue and groove at the seam: 1.2 × 1.5 mm tongue on the top case in a 1.5 × 1.7 mm groove in the bottom (0.15 mm a side, 0.2 mm under), 1.75 mm in from the outside, except across the right end's middle and round the left end's screw. The seam's reveal chamfer is 0.6 mm (was 0.8), so the groove's outer lip stays 1 mm.
- Tighter radii (2026-10-29): plan corners 11 → 8 mm superellipse (about a 5 mm radius), key opening's corners 1.5 → 1 mm and its chamfer 0.5 → 0.3 mm, hump ends 2 → 1 mm, seam reveal 0.6 → 0.4 mm, foot chamfer 1 → 0.6 mm, wheel chamfers 0.8 → 0.5 mm. Inside corners stay at the CNC minimums. The tongue and groove follow the outline's corners shrunk round their centres (a true 3 mm offset of the tighter corners loops). The roll's sections are now evenly spaced along its curve: with evenly spaced angles the loft bulged up to 0.65 mm out of the wall at the ends.
- The bezel fills the F row's 0.25 u gaps (2026-10-29): a bar right across between the F row and the number row, and posts after Esc, F4, F8 and F12, 1 mm from the keycaps like the tongue beside the arrows.
- Later on 2026-10-29: plan corners tighter again (6 mm superellipse, about a 4 mm radius); the USB-C daughterboard raised 4.5 mm, so the port's centre is 13.7 mm off the desk (2.3 mm under the back row's hot-swap sockets, as high as it goes); the 3 mm rubber strips replaced by eight SKUF silicone feet (41.8 × 5.8 × 2 mm) in 1 mm pockets, standing 1 mm proud.
- Not made or fitted.

### Case: bezel beside the arrows, thumb scoop along the front (2026-10-28)

- The 0.5 u gap in the bottom row between the right Ctrl and the left arrow (under the right Shift) showed the plate. The bezel now comes back into it as a tongue, 1 mm from the keycaps on all three sides.
- Thumb scoop: the front bezel's top falls away from the key opening to the outer edge, 2.5 mm lower there, across the whole front (the arrows share the space bar's row). The opening's front edge keeps keycap-bottom height. It's a smooth, mostly concave curve that leaves the flat bezel tangentially and flattens into the front roll, so there's no crease. Front height 15.2 mm, down from 17.7.
- New render `21-thumb-scoop`; `08-section-front` shows the profile. Not made or fitted.

### Case: curved wheel notch, polycarbonate side panel, continuous-curvature corners (2026-10-28)

- The case follows the 30 mm shaft (the wheel's blind bore is now 19 mm deep).
- The notch round the wheel follows its curve, 0.5 mm away, below its axis.
- The polycarbonate is now a panel in the middle of the right side only (side wall and the floor inside it, world y −32 to 36 mm, x > 150 mm), next to and under the antenna and round the power switch, held by two screws in the end wall (163.9, −26 and 15). The rest of the bottom is aluminium again.
- Plan-view corners: continuous curvature like Apple's (Tiam asked for it), a superellipse with exponent 5 running 11 mm along each edge, about the look of a 7 mm radius (was a 9 mm arc). The edge rolls are still circular fillets. Not made or fitted.

### SW3: the 30 mm shaft, PEC12R-2230F-S0024 (2026-10-28)

- Tiam chose the 30 mm shaft, so the wheel that reaches out through the end wall sits on about 19 mm of shaft instead of 9. SW3 is now PEC12R-2230F-S0024 (shaft parallel to the board, 24 detents, push switch, 24 pulses): schematic value and MPN, the PCB's value field, and the docs. Same footprint and pins.
- 3D model: `gen_models.py` takes the shaft length as a parameter (the flat length F follows the datasheet's table) and now builds `Bourns_PEC12R-2x30F-S_standin.step`, which SW3 uses; the 20 mm model is gone. The shaft runs from the hub at board x 321.8 to its tip at x 340.8 (case-local x 162.55), 3.3 mm past the board edge, with the 12 mm D-flat from x 328.8. STEP exports refreshed for the mainboard and assembly.
- Stock (2026-10-28): LCSC has no listing for it, so the LCSC field is empty and JLC would have to source it globally (or leave it off and solder it by hand). Digi-Key lists it (product 4699264) with a 16-week factory lead time and no confirmed stock; I couldn't reach Mouser. Order the encoders early.

### Case: the wheel's click, through the end wall (2026-10-28)

- SW3's push switch is pressed along the shaft (0.5 mm), not down, and the wheel's end was hidden inside the end wall. Tiam chose to expose it: the roller now runs out through a notch in the right end wall (top case and polycarbonate end) to 0.25 mm inside the end face, 23.5 mm wide, so a finger can push its end in. New render `19-roller-end`. Not made or fitted.
- Its look follows the Lemokey L1's corner wheel (Tiam's reference): a straight knurl (44 ribs) round the rim, chamfered ends, and an amber, slightly domed push cap set into its right end (new part `Wheel cap`).

### Case: one bezel height, encoder hump, aluminium with a polycarbonate end (2026-10-28)

- Tiam asked for a less blocky case that suits CNC-machined aluminium. The bezel is now one height all round, level with a keycap's bottom edge (6.6 mm above the plate, up from 3.5), with the key opening 1 mm outside the keycaps. Over the sidebar it's a flat 1.5 mm roof at the same height, so the hood and its steps are gone, and the screen frame sits flush without lowering the screen.
- Encoder: with the real axis height (10 mm above the PCB top), the roller grows to 19 mm across and 15.1 mm wide. The encoder's body stands 5.1 mm above the bezel, so it sits under a round hump on the roller's axis (radius 10.1 mm, 8.5 mm above the bezel, level with the keycap tops) and the wheel continues its curve.
- Bottom case: aluminium, with its right end (x > 128 mm) a separate polycarbonate part under the antenna, held by three screws. The power switch gets a cap: a slider in the end wall takes SW1's actuator, and a 14 × 5.5 mm ridged grip sits flush in a recess in the end face. The battery stays where it is, away from the antenna.
- The front is 17.7 mm high now (14.6 before). New renders `17-power-switch` and `18-section-switch`; the hood renders are renamed `sidebar`. Not made or fitted.

### SW3 part number: PEC12R-2220F-S0024 (2026-10-28)

- The BOM had PEC12R-4220F-S0024, which is Bourns' "Horizontal Mount – Axial PC Pin" part: its shaft points straight up from the board, like a knob. The roller needs "Vertical Mount – Radial PC Pin" (first digit 2), whose shaft is parallel to the board, and that's what the footprint (KiCad's PEC12R-2x17F-Sxxxx) is drawn for. The 2026-10-23 check below had the two backwards.
- Tiam chose 24 detents, so SW3 is now PEC12R-2220F-S0024: shaft parallel to the board, 24 detents, 20 mm insulated D-shaft, push switch, 24 pulses per turn (one quadrature cycle per detent, which matches `CONFIG_KB_ENCODER_STEPS_PER_DETENT=4`). Changed in the schematic (Value, MPN, LCSC C49673168), the PCB's value field, `README.md`, `boards/Dachshund70/README.md` and `docs/design-decisions.md`. The footprint and pins don't change.
- LCSC lists C49673168 with no stock as of 2026-10-28, so JLC can't fit it from their stock; Digi-Key and Mouser had it. Either buy it and solder it by hand (it's through-hole), or check LCSC again before ordering assembly.

### SW3 3D model from Bourns' drawing (2026-10-28)

- The roller encoder's stand-in (three hand-placed STEPs: body, bushing, shaft) is replaced by one model generated in `hardware/3dmodels/gen_models.py` from the PEC12R-2xxxF-S drawing in Bourns' datasheet: shaft axis 10.0 mm above the PCB top (the old stand-in assumed 6.7), body 12.5 × 13.4 mm centred on it and 6.0 mm deep, standing 3.3 mm off the board on its frame's feet, hub Ø7 × 5, Ø6 shaft with the D-flat, 20 mm from the rear face to the tip. Details and what's approximate are in `hardware/3dmodels/README.md`.
- On the board (SW3 at 314.3, 52.025, 180°): body x 310.8–316.8, y 43.275–55.775, 3.3–16.7 mm above the PCB top; hub x 316.8–321.8; shaft to its tip at x 330.8 (0.5 mm shorter than the old stand-in's); axis y 49.525, 10.0 mm above the PCB top. The footprint now uses the new model with no offset; STEP exports refreshed for the mainboard and assembly.
- Not checked against a real part yet.

### Case: wider roller for the flipped encoder (2026-10-28)

- The case follows SW3's new direction: the encoder's raised cover is now at the left end of the sidebar, next to the keys, with the bushing arch in its right wall. Right of it the hood steps down to bezel height, and the roller sits in a 16.5 × 13 mm slot.
- Roller: 12 mm across (the PCB still limits it) and 15.55 mm wide, up from 12.25, ending in line with the screen's right edge. Its top is about 4.2 mm above the case around it and 1.1 mm above the screen's hood.
- New render `16-section-encoder` (a cut along the shaft). Not printed or fitted.

### Mainboard: roller encoder flipped (2026-10-28)

- SW3 (PEC12R, horizontal) moved from (330.3, 47.025) at 0° to (314.3, 52.025) at 180°. The body now sits just right of the last key column (left face at x ≈ 308.15 mm; SW113's keycap ends near 305.25) and the shaft points right, toward the board edge: shaft face at x ≈ 317.85, tip at x ≈ 331.3, on the same centre line (y 49.525). The wheel can be about 17 mm wide now.
- Rerouted: ENC_A goes down to its bus on B.Cu and over to C10's side on F.Cu under the encoder body, with one new via at (331.55, 52.025). ENC_B runs east and down to C11 and its bus. COL14 goes left of the lower mounting tab to its old diagonal. ENC_SW runs along the top edge and down the right side to D114. ROW0 (F.Cu) dips under the new lower mounting tab. Two GND stitching vias that the new pins landed on are gone (314.325, 47.625 and 314.325, 57.15). The back-side board name, version and JLC order-number text moved 9 mm right, off the new pins. All zones refilled. Track widths unchanged (0.25 mm).
- DRC (kicad-cli, `--schematic-parity --severity-error`): 0 violations, 0 unconnected items, 0 parity issues, the same as before. With every severity, the 222 items are the same as before the change (the known spacebar-stabilizer overlaps, library mismatches and silkscreen warnings).
- Plate regenerated: the notch is unchanged (x ≥ 306.0, y ≤ 59.0), since the courtyard's y range didn't change. STEP exports refreshed for the mainboard, plate, assembly and dongle (the dongle's was stale after its module change).
- The case in `hardware/case/` still has the roller for the old direction; that's a new task in `SCHEDULED_TASKS.md`.
- Not on hardware; no board has been made.

### Case and firmware: 2.13" e-paper strip in the hood (2026-10-28)

- Screen: a bare 2.13" e-paper panel (GDEY0213B74, 250 × 122) now stands on end along the sidebar, with a 23.7 × 48.6 mm picture where the 1.12" OLED was 20 × 20. Its driver board (Adafruit eInk Breakout Friend) is taped to its back, kept off the antenna, and wired to J4's eight pins. `gen_case.py`'s screen profiles now say whether the frame locates the glass (e-paper) or the module's board (OLEDs); the SH1107 and SH1106 profiles are still there (`DISPLAY`).
- Firmware: a new overlay `eink-2in13-v4-portrait` (120 × 248, 12 × 15 text cells) with a CI build. It chooses a small display driver, `dachshund,display-rotate` (`firmware/src/display_rotate.c`), that reports the panel turned by 90° and rotates each frame back before writing it, because the SSD16xx driver's own `rotation` property keeps reporting the landscape size and the character framebuffer then draws off the panel. The rotation is `kb_screen_rotate()` in the core, with host tests.
- Not printed or fitted, and not run on a panel. The Friend's parts clear the plate by about 0.3 mm in the model; check with the real board.

### Case: lower hood, taller screen, sealed LED channels, centred USB-C (2026-10-28)

- Hood: its top is now at the height of a keycap's bottom edge (6.6 mm above the plate, 3.1 mm above the bezel), with a 1.5 mm roof. The encoder body is taller than that, so it has its own cover right of the wheel, 3.8 mm higher. Flipping the encoder wouldn't lower it, and the plate needs no cutout.
- Screen: Pimoroni's 1.12" 128×128 SH1107 breakout (20 × 20 mm, 8 text rows), which fits inside the sidebar. A new firmware overlay `oled-sh1107-128x128`, with a CI build. The Zephyr in NCS v3.4.1 has no SH1107 driver, so the overlay runs the panel in the SSD1306 driver's SH1106 mode (same commands, 16 pages); check it on a real panel. The module sits in a locating frame, taped by its glass border. J4 stays without a header (JLC doesn't fit it): the wires are soldered into its holes, so the module can sit over it. The 1.3" SH1106 option is still in `gen_case.py` (`DISPLAY`).
- LEDs: each has its own 4 mm channel through a solid block, sealed to the plate by a strip of 1.5 mm black foam (`Dachshund70-LED-Seal.dxf`), with a 4 mm opal acrylic diffuser disc under each 3 mm hole.
- Roller: 12.25 mm wide (was 8), on the same 20 mm shaft, in a wider slot.
- USB-C daughterboard: centred in the back wall. The back screws moved to either side of it (nine screws now). The JST-SH cable to J1 is about 200 mm.
- The engraving on the back (the bone and DACHSHUND70) is gone.
- Keycap to bezel, for Tiam: about 2.3 mm on the left, front and back with 18 mm Cherry-spec caps; 1.0 mm to the hood's side.
- Not printed or fitted. The SH1107 overlay builds in CI but hasn't run on a panel.

### Case: hood for the OLED, LEDs and roller, stepped floor, strip feet (2026-10-28)

- Display chosen: a generic 1.3" SH1106 128×64 I2C OLED module (firmware overlay `oled-sh1106-128x64`, already there). The top case now rises over the sidebar into a hood with a 2 mm roof, which covers the encoder. The module hangs under the roof on four bosses (M2 × 4 screws) behind a bevelled 31 × 17 mm window, in front of the radio's antenna. It is wired to J4 pins 1–4 with four soldered wires. The hood reaches out over the right bezel, because the 35.4 mm module is wider than the sidebar.
- LEDs D3–D7: a 3 mm hole in the roof over each, with a tube down to the plate so each LED lights only its own hole.
- Roller: the hood steps down to bezel height around it, and only the wheel shows, through a slot.
- Bottom case: the weight is gone (Tiam will add one later). The inside floor steps up once per switch row, to 3.5 mm under the PCB at each row's front edge, except under the sidebar, the battery tray and the USB-C corner.
- Gaskets: the socks now have the round closed end from the sock drawing (8 × 5 × 5 mm, 6.5 × 2.8 × 1.2 mm pocket). Feet: two channels for 10 × 3 mm self-adhesive rubber strip replace the four round bumpons.
- The assembly has stand-ins for the OLED module and the strips. Renders, including the hood from above and sections through it, are in `hardware/case/renders/`.
- Not printed or fitted yet, and the OLED sizes are from Pololu's module, not a measured one.

### Case: gasket-mount case, weight, gaskets and plate foam (2026-10-27)

- `hardware/case/gen_case.py` (CadQuery) generates the case from parameters and from the plate's own outline, and `hardware/case/README.md` has the numbers. Outputs in `hardware/case/step/`: top and bottom case, the brass dog-bone weight, the eight gasket socks, the plate–PCB foam as a DXF outline (Tiam's call: a sketch to extrude, not a STEP), and an assembly with the mainboard, plate, USB-C daughterboard, a battery and a roller stand-in. Renders are in `hardware/case/renders/`. The PCB and plate files were not touched.
- Shape: 336.5 × 144 mm, 7° built in, 14.6 mm at the front and 32.3 mm at the back. A walnut-coloured top frame over a sand-coloured tub, with a groove at the seam, rounded top edges and the board name engraved on the back. About 510 g of brass shows through the bottom as a bone.
- Mount: the seam sits at the socks' lower face, so the bottom case is the seat and the top case presses each sock 0.4 mm into a 4.6 mm pocket. The board touches nothing else. Eight M3 × 10 screws from below go into heat-set inserts in the top case.
- Openings: USB-C in the back wall (the daughterboard sits on two M3 inserts in a wall pocket, with the receptacle 1 mm in), a slot and finger scoop for the power switch, and a pin hole for reset. There's a battery tray for an 803450 cell, and the top case is open over the sidebar for the roller and a future display.
- Found while modelling: with the shaft about 6.7 mm above the PCB and no PCB slot under it, the roller can be at most about 12 mm across, not the 20 mm in the PCB notes. The stand-in is 12 mm.
- Not printed or fitted yet.

### Project review: docs and follow-ups (2026-10-26)

- Tiam's project review is in `docs/project-review-2026-10-26.md`, with a note at the top on what was done about each finding. It was run on a phase-3 checkout, so its "planned features" section is out of date.
- Bring-up plan (M7): USB is never plugged in while an ordinary bench supply is on J2, because the charger would push current into a supply that can't sink it. USB and battery together are tested with a protected cell (or a supply rated to sink current). The bootloader step now switches to USB power first.
- New tasks in `SCHEDULED_TASKS.md`: a look at the USB connector edges in the fab preview (the ST4/ST6 hole overlap was fixed separately, by aligning the holes), USB edge cases on hardware, session tests for Doghouse, KiCad checks in CI, and the display's current against REGOUT0.

### Project review fixes: Doghouse (2026-10-26)

From the project review of 2026-10-26 (H3, M1, M2), all still true on main:

- Every read and change of a board now goes through one queue per session (`SerialQueue` in `serial.ts`): key and encoder edits, undo and redo, save, revert, factory reset, settings, advanced keys, macros, restores and loads. Before, two quick edits to the same key both recorded the original key as "before", so one undo went back too far. Now each edit reads its old value inside the queue. `busy` stays on until every queued change is done.
- Revert and factory reset read the board back before they say they're done, so an edit made straight after one isn't skipped as "already set". The board's `reverted` event still reloads (for a revert from elsewhere) unless a read has happened since. Reads never throw; a failure shows as the session's problem.
- Undo and redo move the history only once the board has taken the change, so a failed write leaves Undo where it was.
- Tests: `serial.test.ts` (order, a failure not blocking the next job, each job seeing the last one's write) and a history peek test. Not tried against a real board.

### Project review fixes: firmware (2026-10-26)

From the project review of 2026-10-26 (`docs/project-review-2026-10-26.md`; it reviewed a phase-3 checkout, so each finding was re-checked against main first).

- USB (H2): a report that fails to submit was only logged, so a lost final release could leave a key held on the host. Now a failed keyboard or extra-interface submit schedules a resync 8 ms later (a delayed work item, so a failing endpoint isn't retried in a tight loop), and the full current state goes out again, as Bluetooth already did. Queue overflow and interface resets already resynced (finding M3 was fixed in phase 4).
- `TO(n)` (M4) now also turns off held layers (MO, LT, OSL while held) and a pending one-shot layer. The keys holding them are forgotten, so their releases don't end a later hold of the same layer.
- One-shot modifiers (M5) survive a bare modifier: tap OSM(Shift), tap or hold Ctrl, press A, and A gets Shift (QMK's behaviour). Before, the bare Ctrl used up the one-shot Shift.
- Tests: `test_engine` covers TO with a held MO and a second MO key, TO over a one-shot layer, and OSM across a tapped and a held Ctrl. The firmware change needs a board, or a fault-injected endpoint, to exercise.

### Doghouse 0.1.3: update checks, app settings and a UI pass (2026-10-26)

- Why 0.1.1 never offered 0.1.2: every Doghouse release so far (0.1.0 to 0.1.2) was built without the updater's public key, because the repo has no `TAURI_UPDATER_PUBKEY` variable yet. Those builds have no updater in them and no release has a `latest.json`, so they can't find or install updates. Installing 0.1.3 by hand is the way off them.
- Update checks (`app-version.ts`, `desktop.ts`): when the updater can't help (no key in the build, or its check fails), Doghouse asks GitHub's releases API for the newest `doghouse-v*` release and offers "Download from GitHub", which opens the release page (Rust command `open_releases_page`, fixed URL). The CSP allows `https://api.github.com`. The app checks at start-up and every six hours; errors are worded for people (offline, rate-limited, GitHub's status).
- App settings (sidebar → App settings, `AppSettings.svelte`): theme, the Doghouse, host-lib and protocol versions, and **Check for updates** with what it found or why it couldn't check, and when. The sidebar shows the version under the buttons; the About tab's footer had 0.1.0 hard-coded and now shows the real one (from `package.json` via Vite's `define`).
- The battery bone is a proper bone: two round knobs at each end and a thick shaft, with a clear outline in both themes.
- Accessibility and layout: light-theme text colours darkened to reach WCAG AA (muted, faint, accent, sage, key sub-legends) and the dark theme's faint text lightened; no text under 11 px; ghost buttons (Identify, Reset, Forget, Undo…) get an outline so they read as buttons; tabs move with the arrow keys, Home and End; the board list marks the selected board with `aria-current`; the header no longer breaks the serial number across lines; on the Advanced tab the ⓘ buttons sit beside their labels and the number boxes line up.
- Tests: `app-version.test.ts` (version order, picking the newest release, error wording). Check, test and build pass; looked at in Chromium in demo mode, light and dark. The desktop update paths weren't run (no Tauri build here); clippy runs in CI.

### Doghouse presets, feature info and a new dog (2026-10-26)

- Presets (Settings tab, `presets.ts`, `PresetPicker.svelte`): Everyday (the factory settings), Gaming (eager debounce, NKRO, a 30-minute nap, and tap-hold, tap dance, combos and Auto Shift off), Careful typing (wait-to-settle debounce, 230 ms tapping term) and Battery saver (10% lights, 5-minute nap). Save current settings as a preset adds your own; Doghouse keeps them in `localStorage`, so they work for every board. A preset sets every setting that changes how the board feels (not the name or colours), so switching always lands in the same place. The Presets section says which preset the board is on, or that it has its own mix. Switching is live like any other change; Save to board keeps it.
- Firmware: the options entry of the advanced-key tables gets an `off` byte (protocol.yaml; capability `feature_switches`, bit 13). With tap-hold off, LT and MT keys type their tap key the moment they go down; with tap dance off, TD keys send their one-tap action at once; with combos off, no key is held back waiting for a combo partner. The tables themselves are kept, and the field is saved with the other options. Not a breaking change: no protocol version bump, older firmware keeps its 14-byte entry, and host-lib reads it and writes only 14 bytes to it (refusing to switch features off there).
- Settings has a new "Speed or tricks" section with the three switches, and the Advanced tab says when a table is switched off.
- Info buttons: an ⓘ beside each setting, advanced option and table, the macros and where keys go, with what it does and its pros and cons (`feature-info.ts`, `InfoTip.svelte`).
- The dachshund has a proper eye (white, pupil and a glint; a closed eye while it naps), its far legs are always a shade darker than its coat, and it keeps the same coat in light and dark mode (the empty kennel shows the same dog, faded).
- Tests: core tests for each switch, the options entry and saving it; host-lib tests against the host-built firmware and a fake board with the old 14-byte entry; Doghouse tests for presets. Looked at in Chromium in demo mode, light and dark. Not tried on hardware.

### Doghouse polish after the first Windows build (2026-10-26)

- Demo mode can be left: when it was opened with `?demo` (rather than forced by a browser without WebHID), the demo panel in the sidebar has **Leave demo mode**, which reloads without `?demo`.
- Key legends are one size. Long legends were shrunk by length alone (so Space, Shift and Enter were smaller than Bksp); now a legend only shrinks when it wouldn't fit its key (`legendSize` in `geometry.ts`). Shifted symbols are the same size as the base legend, with a gap between the two.
- Battery colour (`battery.ts`): white when full, shading to yellow as it drains, and red below 15%. The battery LEDs on the board picture (the four dots right of the layer LED, above the arrows) and the bone gauges in the sidebar and header use it; charging still shows the bolt.
- Tests: `battery.test.ts` and a `legendSize` test; check, test and build pass, and the changes were looked at in Chromium in demo mode (light and dark).

### Phase 15: Doghouse desktop app, packaging and auto-update (2026-10-24)

- Decided with Tiam: Tauri 2 with auto-update. The app is `app/src-tauri/` (Rust): the same web UI in a native window for Windows, macOS and Linux, version taken from `app/package.json`, bundle identifier `com.tiamdesigns.doghouse`, icons made from the doghouse logo.
- HID (`src/hid.rs`): macOS and Linux WebViews have no WebHID, so the app uses hidapi on every OS. It lists devices, opens one per handle, writes reports and streams input reports to the UI over a Tauri channel (non-blocking reads, so a write waits at most 1 ms). On macOS devices are opened shared (hidapi's `macos-shared-device`), or the board would stop typing while Doghouse has it open. host-lib's new `TauriHidBoardManager` (`tauri-hid.ts`) puts the node-hid manager on that bridge, so finding boards, Bluetooth report IDs, the dongle and hotplug (a 1 s scan) all work the same as with node-hid. host-lib takes no Tauri dependency: the app passes in `invoke` and channels.
- Firmware updates in the app (`src/uf2.rs`): after the board reboots into UF2, Doghouse finds its drive by itself (mounted FAT drives with an `INFO_UF2.TXT` whose Board-ID matches, waiting up to 20 s for it to mount) and writes the file. There's no drive picker and nothing to click. The app only writes a well-formed UF2 image onto a drive that it lists as one.
- Auto-update: Tauri's updater plugin checks `releases/latest/download/latest.json` at start-up. A newer version shows "Doghouse x.y is out" in the sidebar with Install and restart (download progress, then a relaunch). The updater is only built in when the repo has the public key (variable `TAURI_UPDATER_PUBKEY`); update files are signed with the private key (secret `TAURI_SIGNING_PRIVATE_KEY`), which Tiam makes once (`app/src-tauri/README.md`).
- Releases: `.github/workflows/doghouse-release.yml` (manual, or a `doghouse-v*` tag) builds Windows (NSIS and MSI), macOS (universal .dmg and .app) and Linux (.deb, .rpm and AppImage) with tauri-action, and puts them and `latest.json` on a draft release. The .deb and .rpm install a udev rule (`linux/70-dachshund.rules`) so the logged-in user can open the boards' hidraw devices, over USB and Bluetooth.
- In the app, Doghouse hides "Connect a board…" (boards come in on their own) and the "this browser can't reach USB devices" note; demo mode still works with `?demo`.
- CI: a new job, "Doghouse desktop app (Rust)", runs `cargo fmt --check`, clippy with warnings as errors and `cargo test` on Linux.
- Tests: Rust unit tests for finding a UF2 drive and refusing anything that isn't a UF2 image or isn't on a listed drive. A host-lib test runs `TauriHidBoardManager` against a stand-in for the app's commands: it opens boards, writes with report ID 0 and drops a board when its reader closes. host-lib 152, Doghouse 14 and Rust 2 pass.
- Tried locally on Linux under Xvfb: the app starts and loads the UI under its content security policy, and finds no boards (there's no HID in the container). A release build signed with a throwaway key made the .deb (2.8 MB, with the udev rule), the AppImage and their `.sig` files. Pointed at a local `latest.json` for 0.2.0, the app offered the update. Installing it wasn't tried.
- Not tested yet: the app against a real board on each OS, Windows and macOS builds (CI builds them on release), installing an update, and the drive write on a real UF2 bootloader. Code signing (Authenticode, Apple notarisation) isn't set up; the installers are unsigned. These are in `SCHEDULED_TASKS.md`.
- How to test: `cd app && npm install && npm run tauri dev` (setup per OS in `app/src-tauri/README.md`). Plug in a board or the Pup and it shows up with no Connect step. For a release, set up the keys, then run the "Doghouse release" workflow.

### The Pup: keyboard firmware on an nRF52840 Dongle (2026-10-24)

- Tiam asked for it so Bluetooth and the 2.4 GHz dongle can be tried on the nRF52840 Dongles being ordered, before the PCBs exist. `boards/Pup/` holds its `board.json`, `keyboard.json` (one key, one indicator) and `firmware/`: the devicetree overlay (SW1 on P1.06, LD2's red, green and blue on P0.08, P1.09 and P0.12, all from Nordic's PCA10059 documentation; flash layout with the code at 0x1000 after Nordic's MBR, `bt_settings` at 0xd6000 and `storage` at 0xd8000, below Nordic's bootloader at 0xe0000) and its default keymap (`a`).
- It builds on Zephyr's own `nrf52840dongle/nrf52840` board, so it needs no Zephyr board files: `firmware/boards/nrf52840dongle_nrf52840.overlay` (which Zephyr picks by board name) includes `app.overlay` and the Pup's overlay, and `firmware/boards/nrf52840dongle_nrf52840.conf` sets the names (USB product and Bluetooth name "Dachshund Pup", `KB_MODEL` "Pup"), Nordic's bootloader and a 10 s recovery hold. Build: `west build -p -b nrf52840dongle/nrf52840 -d build/pup firmware`.
- Firmware changes, none for the Dachshund70: a board without `matrix-col-gpios` is wired directly (each row pin one key, read as column 0, with its devicetree flags for the pressed level), the indicators can drive one RGB LED on GPIOs (`indicator-rgb-gpios`, Caps Lock) instead of an SK6812 chain, the GPREGRET value for the bootloader is a Kconfig option (`KB_BOOTLOADER_GPREGRET`: 0x57 for the Adafruit UF2 bootloader, 0xB1 for Nordic's), and a board folder named by `KB_MODEL` with `firmware/default_keymap.c` brings its own default keymap.
- host-lib and Doghouse: the Pup's default keymap is in `default-keymaps.ts` (so the mock can simulate one), and Doghouse knows its definition ("Pup · Puppy · 1 switch"). The board tests accept direct wiring and LEDs on their own pins, and new tests check the Pup's overlay pins, names and USB IDs, LED table and default keymap against `board.json`, `keyboard.json` and host-lib.
- CI builds the Pup (debug and release) as `Firmware (pup)`.
- Size, debug: 267.8 KB flash, 77.1 KB RAM; release 229.3 KB. The Dachshund70's build is unchanged.
- Not tested on hardware yet: everything (`SCHEDULED_TASKS.md`, "Pup on real hardware"), including whether Nordic's bootloader takes GPREGRET 0xB1.
- How to test: host-lib and Doghouse tests as in CLAUDE.md. With a PCA10059: build, flash and try it as in `boards/Pup/README.md`.

### Phase 14: 2.4 GHz dongle (2026-10-24)

- Link (`kb/link.h`, host-tested): Enhanced ShockBurst at 2 Mbps on 2475 MHz (above Wi-Fi channel 11, below Bluetooth's 2480 MHz advertising channel), packets up to 72 bytes. The keyboard transmits (PTX) and the dongle listens (PRX). Keyboard to dongle: POLL, REPORT (kind plus the USB report), CONFIG (a response frame), PAIR. Dongle to keyboard, in ESB acknowledgements: STATUS (lock LEDs; USB ready, boot protocol, resync), CONFIG (a request frame), PAIR_OFFER. Every packet is length- and type-checked before use.
- Pairing: the dongle's link address comes from its device ID (FNV hash, never the pairing address or a preamble lookalike), so it never changes. The dongle's button turns on pairing for 30 s: it also listens on a fixed pairing address and offers its address there. `RF_PAIR` (new keycode, Doghouse "2.4G Pair") or Doghouse makes the keyboard ask on the pairing address for 30 s; it takes the first offer, keeps it in Zephyr settings (`kb/rf/dongle`, versioned, next to the Bluetooth bonds) and moves to it. The link isn't encrypted yet.
- Keyboard (`src/kb_esb.c`, `CONFIG_KB_DONGLE`, on by default): ESB on the MPSL timeslot API, so it shares the radio with Bluetooth (Nordic marks this experimental). Reports go out the moment they're queued. The keyboard polls every 10 ms in use, 2 ms while config traffic flows, 100 ms while idle, and not at all once power management turns the radios off (the next key starts it again) or nothing is paired. Three failed packets in a row (each after 6 retransmits) mark the dongle gone; a single failure triggers a resync, so a lost release can't stick a key.
- Output selection: the dongle is a third output. Keys go to the preferred one (`OUT_USB`, `OUT_2G4`, `OUT_BLE`, or Doghouse) while it's ready, otherwise to the first ready of USB, the dongle and Bluetooth. The dongle counts as ready when it answers and its computer has configured it. Lock LEDs, boot protocol and resync follow it like the other outputs.
- Dongle firmware (`dongle/`): reuses the keyboard's USB device (`firmware/src/kb_usb.c` and `app.overlay`) with its own IDs (1209:0002, "Dachshund70 Receiver", `dongle/Kconfig`), relays reports to USB and config frames both ways, releases every key if the keyboard is quiet for 400 ms, and answers Doghouse with the new `unreachable` status while the keyboard is away. RGB LED: white at power-up, blue blinking while pairing, green on pairing and when the keyboard comes in range, red when it goes. Built for the nRF52840 Dongle (PCA10059), whose button and LED pins match the Dachshund dongle's; flash and pair steps are in `dongle/README.md`.
- Protocol (still version 1; added): `get_dongle` 0x54 (paired, link state, pairing), `pair_dongle` 0x55 (stop, start, forget), the `dongle` capability (bit 12), `set_output 3`, and the `unreachable` status (10), which only a dongle sends.
- host-lib: the dongle's PID is found by both managers (connection `"dongle"`); while its keyboard is away the dongle isn't listed, and it's tried again every 2 s (`dongleRetryMs`), so the board leaves and comes back by itself. `Board` gains `getDongle()` and `pairDongle()`, and `setOutput` takes `"dongle"`. The mock simulates the dongle; `RF_PAIR` is in the keycode catalogue. A board test checks that the dongle's Kconfig USB IDs match board.json and both ends use the same ESB payload size.
- Doghouse: the Connection tab offers 2.4 GHz as an output and has a dongle card (state, Pair a dongle, Stop, Forget).
- Tests: core `test_link` (every packet, malformed input, addresses), `test_output` (dongle preference and fallback order), `test_protocol` (`get_dongle`, `pair_dongle`, `set_output 3`, refusals) and the fuzz command list; host-lib dongle tests against the mock and the host-built firmware, and the WebHID dongle wait-and-return test. Core 20/20, host-lib 131, Doghouse 14 pass.
- Size, debug without a screen: 274.0 KB flash, 78.2 KB RAM; release 234.8 KB. Dongle debug 74.1 KB flash, 24.7 KB RAM; release 58.6 KB.
- Not tested on hardware yet: pairing, range, latency (key to USB), dropouts next to Wi-Fi, the keyboard's current while polling, and Bluetooth and ESB sharing the radio. These are in `SCHEDULED_TASKS.md`.
- How to test: core and host-lib tests as in CLAUDE.md; `cd app && npm run dev`, open http://localhost:5173/?demo, Connection tab. With hardware: flash an nRF52840 Dongle (`dongle/README.md`), pair, prefer 2.4 GHz, type, then unplug the dongle and check that keys move to USB or Bluetooth with nothing stuck.

### Phase 13: power management, battery gauge and lower input delay (2026-10-24)

- Decided with Tiam: stay on the nRF52840 with 1 kHz scanning and polling (full-speed USB tops out at 1 kHz; the nRF54H20 move is off), and work on input delay instead.
- Wake-on-press scanning (`CONFIG_KB_WAKE_ON_PRESS`, on): while no key is down, every column is driven high between scans and the rows wait on a level interrupt, so the first key of a burst is scanned the moment it closes instead of at the next 1 ms tick, and the scan timer restarts from there. That saves half a scan period on average for most presses. Debounce stays eager on press (no added delay).
- Power states (`kb/power.h`, host-tested): quiet means no key down and nothing in the engine waiting on time (`kb_engine_idle`: tap-hold, combos, Caps Word, Leader, macros, mouse keys) and debounce settled (`kb_debounce_idle`). After 500 ms quiet (`CONFIG_KB_IDLE_MS`) the scan timer stops and the scan thread sleeps until a matrix or encoder interrupt, with no delay on the next key. On battery only: after 60 s the indicators and an OLED go dark (`CONFIG_KB_LIGHTS_OFF_S`), after 5 min Bluetooth stops advertising if no host is connected (`CONFIG_KB_ADVERTISING_OFF_S`; the next key starts it again), and after the sleep timeout from Settings (15 min by default, 0 = never) the board goes into deep sleep. USB power never sleeps.
- Deep sleep (`src/power.c`): tells the Bluetooth host it's going, turns off the LEDs' load switch and an OLED, leaves the columns driven high with the rows' SENSE armed, and enters System OFF. A key press wakes the board through a reset; the LED walk is skipped then (reset cause `RESET_LOW_POWER_WAKE`). The waking key is typed only if it is still held once a host is back. A new keycode, `QK_SLEEP` (Doghouse: Sleep), sends the board to sleep once every key is up, on battery only. A cell under 3.3 V sends it to sleep at once.
- Battery gauge (`kb/battery.h`, host-tested): VDDH/5 on the SAADC (a new `&adc` channel in the board devicetree, no pin), read once a minute on battery and turned into a percentage with a LiPo curve, smoothed and only ever going down while on battery. On USB the power path feeds VDDH from VBUS, so the cell isn't read; CHG_STAT (P0.15) shows charging, and the gauge reads 100 once charging stops. The level goes to the Bluetooth Battery Service, the indicators' 4-step gauge and the status screen.
- Advertising: fast for 30 s, then slow (1 s), and paused as above.
- Protocol (still version 1; commands added): `get_power` (percent, cell mV, charging, USB power; with the `battery` capability, set when the gauge is up) and `get_timing` (scan period, matrix read time, key-change-to-report time, average and max, scans started by a key interrupt, total scans; optional reset; the `timing` capability). Polling commands (`get_power`, `get_connection`, `get_timing`) don't keep the board awake; any other request counts as use.
- host-lib: `getBattery()` now reads `get_power` (with `millivolts` and `usbPower`), and `Board` gains optional `getTiming(reset)` (`InputTiming`). The mock simulates both. `QK_SLEEP` is in the keycode catalogue.
- Doghouse: the battery is refreshed every 30 s for real boards. About shows the cell voltage and power source, and a new **Input timing** card reads and resets the board's timing counters.
- Tests: core `test_power` (every threshold, USB, critical battery, wrap), `test_battery` (curve, unknown, smoothing, only down, charge and unplug, critical), `test_engine` (`kb_engine_idle`), `test_debounce` (`kb_debounce_idle` for every algorithm), `test_protocol` (both commands, refusals) and the fuzz test. host-lib: battery and timing against the mock and the host-built firmware.
- Size, debug without a screen: 261.0 KB flash, 74.5 KB RAM; release with an SSD1306 128x32: 244.6 KB.
- Not tested on hardware yet: current in each state, wake from System OFF, whether the reset cause survives the UF2 bootloader (if not, the LED walk shows after each wake), the gauge against a real cell. These are in `SCHEDULED_TASKS.md` and Stage 4 of the bring-up plan.
- How to test: core and host-lib tests as in CLAUDE.md; `cd app && npm run dev`, open http://localhost:5173/?demo, About tab (Input timing). On a board on battery: leave it 60 s (lights out), 5 min (advertising stops), 15 min (deep sleep), then press a key; read About → Input timing after typing.

### Phase 12: Bluetooth LE (2026-10-24)

- Firmware (`src/kb_ble.c`): HID over GATT with Nordic's HIDS library, plus the Battery and Device Information services. The report map (`kb_hid_ble_desc()` in the core) carries every USB report: the boot keyboard report and lock LEDs take report ID 5, NKRO, consumer, system and mouse keep IDs 1-4, and the config protocol is a vendor collection with report ID 6 (`hid.ble_report_id` in `protocol.yaml`). Boot protocol works too. Reports go through a queue and their own thread; a lost report triggers a full resync, like USB.
- Host profiles: three (`CONFIG_BT_ID_MAX=3`, matching `BT_SEL(0)`-`BT_SEL(2)` in Doghouse). Each profile has its own identity (address) and one bond, so each computer sees its own Dachshund70. A profile with a bond only takes its own computer: anyone else who connects is dropped, and pairing from another computer is refused until `BT_CLR` (or Doghouse) forgets the host. Pairing is Just Works (no display). The selected profile, bonds and identities live in Zephyr settings (NVS, CRC-checked) on a new 8 KB `bt_settings` partition at 0xEA000, inside the area the UF2 bootloader never erases.
- Output selection (`src/output.c`, logic in `kb/output.h`): keys go to the preferred output (USB by default; `OUT_USB`, `OUT_BLE` or Doghouse change it, and it is kept across power cycles) while its host is ready, and to the other one otherwise. USB counts as ready once configured (also while suspended, so a key still wakes the computer); Bluetooth once the link is encrypted. On a switch, the old host gets all-released reports so nothing sticks down, and the new one gets the full state. Lock LEDs, the indicators and the status screen follow the active output. USB now starts and stops with VBUS, so unplugging moves keys to Bluetooth at once.
- Protocol (still version 1; commands added): `get_connection` (active and preferred output, USB and Bluetooth state, selected profile, profile count, paired mask), `set_output`, `select_profile`, `clear_profile`, and the `bluetooth` capability. The config protocol works over Bluetooth with the same frames; responses go back the way their request came. A 64-byte report needs an ATT MTU of 67, so the board asks for 247.
- host-lib: `Board` gains optional `getConnection`, `setOutput`, `selectProfile` and `clearProfile` (`ConnectionStatus`). WebHID reads the config collection's report ID and reports `connection: "ble"` when it isn't 0; node-hid does the same from hidapi's bus type. A board reachable over both USB and Bluetooth is listed once, over USB, and its Bluetooth link takes over when the cable comes out. The mock simulates hosts and profiles.
- Doghouse: a **Connection** tab: where keys go now, a USB/Bluetooth preference, and the three Bluetooth hosts with Switch to and Forget (with a warning when that would cut off Doghouse's own Bluetooth link). It refreshes every 2 s while open, so pairing shows up. Demo mode can "pair over Bluetooth".
- Not yet: passkey pairing, and the board's name from Settings as its Bluetooth name.
- Tests: core `test_output` (selection rules), `test_hid` (the Bluetooth report map's report IDs and sizes, released reports), `test_protocol` (every new command and refusal) and the fuzz test (new commands; output and profile stay in range). host-lib: the connection API against the mock and the host-built firmware, WebHID and node-hid over Bluetooth, the USB-over-Bluetooth listing, and `prj.conf`'s PnP IDs and profile count against `board.json` and host-lib. Doghouse's Connection tab was run in Chromium in demo mode.
- Size, debug without a screen: 250.7 KB flash, 74.0 KB RAM (the Bluetooth stack); release 213.5 KB.
- How to test: core and host-lib tests as in CLAUDE.md; `cd app && npm run dev`, open http://localhost:5173/?demo, Connection tab. On a board: pair it from a computer's Bluetooth settings, unplug the cable while typing, switch hosts with BT1-BT3, forget one with BT Clr, and open Doghouse over Bluetooth (Connect a board… lists it).

### Phase 11: in-app firmware updates (2026-10-24)

- Firmware: every image carries a 32-byte info block (`struct kb_fw_info` in `kb/version.h`: the magic `KBFWINFO`, layout, protocol version, firmware version and model), so Doghouse can tell what a `.uf2` file holds before flashing it. The handshake now takes its version and model from the same block, which also keeps it in the image.
- host-lib: `uf2.ts` checks a UF2 file block by block (magic numbers, numbering, nothing missing), refuses another chip family or any block outside the application flash (0x26000-0xEA000, so never the SoftDevice, the bootloader or the settings), and reads the info block; `compareVersions` and `uf2BoardId` (the Board-ID from the drive's INFO_UF2.TXT). `backup.ts`: `backupBoard` reads the keymap, encoders, settings, advanced keys, macros and colours into one JSON object, and `restoreBoard` writes back only what differs, then saves. The mock board can now reboot (unsaved edits are lost) and, in its simulated bootloader, take "firmware" through `MockBoardManager.flash()`.
- `keyboard.json` names the board's bootloader (`uf2BoardId`, `volume`), checked against the bootloader's `board.h`.
- Doghouse: About → **Update firmware…** picks a `.uf2`, checks it is firmware for this model, shows the version change and warns about downgrades and a different protocol version. Then a dialog runs the steps: back up the settings (also kept in the browser, and downloadable), restart into the bootloader, choose the DACHSHUND drive (File System Access API in Chrome and Edge; the drive's Board-ID is checked) and write the file, wait for the board to come back, check it runs the new version, and put back anything the update lost. Browsers without the drive picker get a download link and "I've copied it". About also gets **Restore a backup…**, and demo boards a **Try a pretend update** button that runs the whole flow.
- Tests: core `test_version` pins the info block's layout; host-lib `uf2.test.ts` (round trip, the info block across a block boundary, every refusal, versions, Board-ID) plus a check against the real `zephyr.uf2` done by hand (found 0.1.0, Dachshund70, protocol 1); back up, factory reset and restore against both the mock and the host-built firmware; the mock's reboot and flash. The demo update flow was run end to end in Chromium.
- Size, debug without a screen: 94.1 KB flash, 40.3 KB RAM.
- Not yet tested: writing to a real UF2 drive from the browser (needs a board or an nRF52840 dongle with the Adafruit bootloader).
- How to test: `cd app && npm run dev`, open http://localhost:5173/?demo, About → Try a pretend update. On a board: build a firmware with a higher `VERSION`, then About → Update firmware….

### Phase 10: indicator colours and global settings (2026-10-24)

- Protocol (still version 1; only commands were added): `get_settings` and `set_settings` carry the debounce algorithm and time, tapping term, NKRO, sleep timeout, indicator brightness and the board's name (16 bytes of UTF-8) as one struct, checked whole with `kb_settings_valid()`. `get_indicators` and `set_indicators` carry the Caps, Num and Scroll Lock colours, the battery gauge's normal and low colours and the low level; `get_layer_colour` and `set_layer_colour` the layer LED's colour per layer. Colours are 0x00RRGGBB, and anything with a top byte set is refused. The firmware now reports the `settings` and `indicators` capabilities.
- Firmware: `keyboard.c` owns the indicator colours with the settings. A change applies at once through a new `settings_changed` protocol op: debounce restarts only if it changed, the tapping term and NKRO switch over, and the LEDs redraw (`indicators_set_config()` replaces `indicators_set_brightness()`). Applying settings no longer resets the macro edit buffer. The sleep timeout is stored but used from phase 13.
- Saving: a new `KB_SECTION_INDICATORS` section (the low level, then RGB for each colour and layer; no schema bump). An older blob without it keeps the default colours, and a section with fewer or more layers loads what fits.
- host-lib: `BoardSettings` gains `debounceAlgorithm`, and `SETTINGS_LIMITS` now match the firmware (debounce 0-100 ms, tapping term 50-2000 ms, sleep up to 240 min, the name in bytes). `Board` gains optional `getIndicators` and `setIndicators` with an `IndicatorColours` type ("#rrggbb" strings). `HidBoard` implements settings and colours; `settings.ts` and `indicators.ts` hold the firmware's checks and defaults, shared by the mock.
- Doghouse: the Settings tab now works on real boards. New: a debounce style picker, a "Light colours" group (layer light per layer, the lock lights and battery gauge the board actually has, and the low-battery level), and the name check counts bytes. Sliders keep their useful ranges but stretch to show a value set elsewhere.
- Docs: Tiam chose not to register pid.codes PIDs while the board stays on their desk. The README warns anyone rebuilding the project to use their own VID/PID before giving boards away, and the design decisions page records the choice.
- Tests: core `test_protocol` (every new command, each out-of-range field, not-supported, revert and factory reset), `test_settings` (the indicator section's round trip, older and newer layouts, malformed sections, the sector budget), and the protocol fuzz test now sends every command and checks the settings stay valid (also clean under ASan and UBSan). host-lib: settings and colour tests run against both the mock and the host-built firmware, plus a save and reboot round trip.
- Size, debug without a screen: 94.0 KB flash, 40.3 KB RAM.
- How to test: core and host-lib tests as in CLAUDE.md; `cd app && npm run dev`, open http://localhost:5173/?demo, change the colours and settings on the Settings tab, Save, change them again, and Revert. On a board: change the layer colour and switch layers, toggle Caps Lock, and change debounce while typing.

### README and design decisions (2026-10-24)

- The repo is public. `README.md` covers why the project exists, its goals (hardware, firmware, wireless, driver and app, process), the board, phase status, how to try it, and the licences with a disclaimer (no warranty, LiPo safety, test USB PIDs, certification).
- `docs/design-decisions.md` lists the decisions Tiam made personally (scope, hardware, process) and the topics the project has covered.

### Phase 9c: Doghouse editors for advanced keys and macros (2026-10-23)

- Doghouse gets two tabs, shown only for boards whose firmware has the `advancedKeys` and `macros` capabilities. **Advanced** edits the options (Leader timeout, Caps Word on both Shifts, Auto Shift, mouse keys) and the five tables: combos, tap dances, key overrides, Leader sequences and per-key tap-hold rules. Each entry is edited in a small form, checked as the firmware checks it before Apply, and summarised in one line. **Macros** edits M0 to M31 as steps (type text, tap, hold, release, pause), shows how much of the 1 KB macro buffer they use, and sends them together.
- The keymap editor's palette has a "Macros & dances" group (`M(n)`, `TD(n)`), plus `AS_TOGG`, the dynamic-macro keys and mouse buttons 4 and 5 and horizontal scroll. Keycode fields take any catalogue key or a modded key such as `LSFT(KC_1)`.
- host-lib: `advanced.ts` has the slot counts, limits and default options, and checks entries, options and macros the way the firmware's `kb_features_valid` does. The mock board now has the advanced-key and macro methods, saved, reverted and factory-reset with the keymap. The advanced-key and macro tests in `hid-board.test.ts` run against both the mock and the host-built firmware, so the two can't drift apart.
- Not yet: undo and redo for these tabs (in SCHEDULED_TASKS.md).
- How to test: `cd host-lib && npm test` (with `KB_HOST_DEVICE` set, as CI does, for the firmware half); `cd app && npm run check && npm test && npm run build`; `npm run dev` and open http://localhost:5173/?demo, then add a combo, a tap dance and a macro, Save, change something, and Revert.

### Phase 9b: advanced keys in the firmware, protocol and host library (2026-10-23)

- Protocol (still version 1; only commands were added): `get_feature` and `set_feature` read and write one entry of an advanced-key table (options, combos, tap dances, key overrides, Leader sequences, tap-hold rules, encoder mapping); `get_macro_chunk`, `set_macro_chunk` and `apply_macros` edit the macro buffer. Table ids, entry sizes and byte layouts are in `protocol.yaml` (`feature_tables`), and the generator now emits them and supports `u8[]` fields. A `set_feature` is checked against every table together with `kb_features_valid()` and undone on an error; `apply_macros` checks every step, and a refused edit is dropped. Revert and factory reset refresh the macro edit buffer.
- Saving: two new settings sections (no schema bump), `KB_SECTION_FEATURES` (blocks of table, entry size, count, entries) and `KB_SECTION_MACROS` (the buffer without trailing zeros). Loading checks the whole set and keeps the defaults if it fails; entries from newer or older firmware (longer or shorter) load field by field. The worst case (4 layers of 6×15 and a full macro buffer) fits one 4 KB store sector.
- Engine: `kb_engine_set_features()` is safe to call while keys are down. Keys waiting to become a combo go on as plain presses, fired combos are released, and a playing macro stops and lets go of its keys.
- Firmware: `keyboard.c` owns the tables (defaults: volume on the roller, tracks on Fn, as in Doghouse), loads and saves them with the keymap, and hands them to the engine. Mouse keys send a new mouse report (report ID 4 on the extra interface: five buttons, X, Y, wheel and horizontal pan). The encoder is read on the scan thread through a new quadrature decoder in the core (`kb/encoder.h`: counts transitions with direction, ignores impossible jumps, bounce cancels out; `CONFIG_KB_ENCODER_STEPS_PER_DETENT`, default 4) and fed to `kb_engine_encoder()`. The handshake now reports the `advanced_keys`, `macros` and `encoders` capabilities, one encoder and the 1 KB macro buffer.
- host-lib: `Board` gains optional `getAdvancedKeys`, `setAdvancedEntry`, `setAdvancedOptions`, `getMacros` and `setMacros`, with types for each table and `MacroStep` (tap, down, up, delay, text). `HidBoard` implements them and the encoder mapping (`getKeymap().encoders`, `setEncoder`). `advanced-codec.ts` turns entries and macros into bytes and back. The keycode codec knows `M(n)`, `TD(n)`, `AS_TOGG` and the `DM_` keys.
- Tests: core `test_encoder` (detents, bounce, impossible jumps, resolution), new `test_protocol` cases (every feature command and error, the edit-and-apply flow, revert), `test_settings` (round trip, invalid sets, forward and backward compatibility, the sector budget), engine tests for tables changing under held keys, the mouse report descriptor and packer. The protocol fuzz test now also checks that the tables stay valid. host-lib: codec tests, and round trips against `kb_host_device` (encoders, every table, options, macros, save and reboot, factory reset), which now runs on a 4 KB-sector flash like the firmware's.
- Size, debug without a screen: 92.1 KB flash, 40.3 KB RAM (the tables, the macro edit buffer and a 4 KB save buffer).

### Phase 9a: advanced keys in the core engine (2026-10-23)

- New `kb/features.h`: fixed-size tables the engine runs from, which the firmware will own, save and edit over the protocol in 9b. 16 combos (2–4 keys, a timeout and a layer mask each), 16 tap dances (`TD(n)`: one tap, hold, two taps, three taps), 16 key overrides (exact modifiers + key → replacement, e.g. Shift+Backspace = Delete), 16 Leader sequences (up to 4 keys), 16 per-key tap-hold rules, encoder actions per layer (transparent falls through), Caps Word, Auto Shift and mouse-key settings, and a 1 KB macro buffer. `kb_features_valid()` checks every index and keycode, so tables from the host or flash can't do anything a keymap couldn't.
- Macros (`M(0)`–`M(31)`): steps that tap, press or release a keycode, wait, or type ASCII text (US layout). Keys a macro presses and doesn't release come up when it ends.
- New keycodes: `M(n)`, `TD(n)`, `AS_TOGG`, `MS_BTN4`/`MS_BTN5`, `MS_WHLL`/`MS_WHLR`, and dynamic macros `DM_REC1`, `DM_REC2`, `DM_RSTP`, `DM_PLY1`, `DM_PLY2`.
- Engine: key events pass a combo stage, then the tap-hold stage, then the keymap. Fired combos and encoder detents enter as events of a virtual key row, so they take part in tap-hold decisions like any key. Tap-hold options, globally or per key: permissive hold, hold on other key press, quick tap and retro tapping. Also Caps Word (letters shifted, `-` becomes `_`, digits and Backspace keep it going, ends on anything else or after 5 s idle; optionally both Shifts toggle it), Auto Shift (held past 175 ms = shifted), Repeat, Leader, two dynamic macro slots of 64 steps, and mouse keys with acceleration through a new mouse report callback. All of it is written for this repo, not taken from QMK.
- `kb_engine_encoder()` turns a detent into a tap of the encoder's keycode on the active layer.
- Tests: `test_features` covers each feature and its edge cases (combo timeouts, overlapping combos, early release, layer masks, dance interrupted, override modifier hiding, Caps Word timeout, rolling under Auto Shift, Leader prefixes, macro delays, encoder layers, table validation) plus a randomized test. It runs 200 rounds of random presses, detents and ticks with every feature set up, and checks that nothing stays held afterwards. A larger run (20,000 rounds under ASan and UBSan) is clean. That test found three bugs, which are fixed: a modifier counted twice when two features added it to one key, macro-held keys never released, and a clock that could lag behind the first event.
- The firmware builds unchanged against the new engine (no tables yet): 87.8 KB flash, 32.8 KB RAM, debug without a screen.

### Phase 8: Doghouse MVP on host-lib (2026-10-23)

- Doghouse now finds real boards through `WebHidBoardManager`: **Connect a board…** in the sidebar opens the browser's picker the first time, and after that boards open on their own when plugged in and leave when unplugged.
- Demo mode keeps the simulated boards: it's on with `?demo` in the URL, or in a browser without WebHID (which also says to use Chrome or Edge). The empty kennel links to it. host-lib's new `CombinedBoardManager` puts real and demo boards in one list.
- The app follows the firmware's capabilities: no settings section without the `settings` capability (the current firmware; phase 10 adds it), a note on the roller until encoders arrive (phase 9), and Identify, Save, Revert and factory reset only when supported. Loading no longer needs settings or a battery reading.
- A board on another protocol version shows in the pack with a message saying whether to update Doghouse or the firmware, and nothing is written to it. A board model Doghouse has no definition for gets a toast and stays out of the pack.
- About: the firmware's features, and **Restart into bootloader…** (protocol `reboot` into UF2) for firmware updates.
- host-lib: `Board.reboot` (optional), `CombinedBoardManager`, and boards without a serial number (WebHID) get a unique id from their manager.

### Phase 7: host library (2026-10-23)

- `keycode-codec.ts`: keycode ids (`KC_A`, `MO(1)`, `LT(1,KC_SPC)`, `LSFT_T(KC_A)`, `OSM(MOD_LSFT)` and so on) to the firmware's 16-bit numbers and back. The numbers come from `keycodes.gen.ts`, which `protocol/gen/gen.py` now generates from `kb/keycodes.h`. A number with no name comes back as `RAW(0x....)` and encodes to the same number, so any keymap round-trips.
- `transport.ts`: the Transport interface (write a report, listen for reports and for the device going away).
- `client.ts`, `ProtocolClient`: one request in flight at a time, each with its own sequence number; responses are matched by command and sequence, so a late answer is never taken for the next request. A timeout is retried twice with a new sequence number, except `reboot`. Error statuses become `BoardError`s; `BoardErrorCode` gains `storage-error`, `not-supported`, `timeout` and `protocol-error`.
- `hid-board.ts`, `HidBoard`: the typed `Board` over the protocol. Opening runs the handshake and `get_serial` (the board's id). Version negotiation: a board on another protocol version still opens and shows in the list, but every call fails with `version-mismatch` and nothing is sent after the handshake. The keymap is read in 28-key chunks. Unsaved changes are tracked per connection (the protocol can't ask). Commands the firmware lacks a capability for fail with `not-supported` without asking the board: today settings (phase 10) and encoders (phase 9). `BoardInfo.capabilities` lists the firmware's capabilities, and `reboot(bootloader)` restarts the board, into UF2 if asked.
- `webhid.ts`, `WebHidBoardManager`: `request()` (from a click) asks for 1209:0001 with usage page 0xFF00 and usage 0x44; `start()` opens boards the site already may use; connect and disconnect events follow hotplug. The WebHID types are declared structurally, so there's no new dependency.
- `node-hid.ts`, `NodeHidBoardManager`, from the separate `@dachshund70/host-lib/node` entry so browser builds never see node-hid: loads node-hid v3 at run time (it isn't a dependency of host-lib; the desktop shell will install it), polls the device list once a second for hotplug, matches the config interface by usage page or, on Linux hidraw, by interface number 2, and puts report ID 0 before each write.
- Round-trip tests: `kb_host_device` (in `firmware/core/tests/`) is the core protocol handler, store and settings code over a simulated flash with the firmware's default keymap, speaking hex frames on stdin and stdout. The same Board tests (default keymap, edit, save, revert, factory reset, bad input) run against the mock and against it, and a saved keymap survives its reboot. Other tests cover the client (sequence matching, serialising, retries, late answers, status mapping, disconnects), version mismatch, and both managers against stand-in WebHID and node-hid APIs. CI's host-lib job builds `kb_host_device` and runs them.

### Phase 6: persistence (2026-10-23)

- Core, `kb/store.h`: a log of whole snapshots in a flash area split into sectors. Each save appends one record (magic, sequence number, schema, length, CRC-32, data). When a sector is full the next one is erased, round robin, so wear is spread evenly and the newest record is never in the sector being erased. The magic word is written last and every write is read back, and mount checks that the space after the last record is still blank, so a save cut short by power loss is ignored and the previous snapshot stays. The flash is passed in as read, write and erase functions.
- Core, `kb/settings.h`: the blob saved in a record, schema 1. Tagged sections (keymap; settings: debounce algorithm and time, tapping term, NKRO, sleep timeout, indicator brightness, board name), each with a length, so unknown sections are skipped and missing ones keep their defaults. Adding a section or appending a field needs no schema bump; anything else bumps the schema and adds a migration in `kb_settings_decode()`. Every value is range-checked on load, and a keymap with other dimensions is ignored.
- Tests: `test_store` runs on a simulated 8 KB flash with 1 KB sectors that counts writes and catches writes to unerased cells. It covers wear levelling over many saves, power cut at every write of a save, a corrupted record, wipe, and sequence wrap. `test_settings` covers encode and decode round trips, bad values, unknown and short sections, and other keymap sizes.
- Firmware: `storage.c` puts the store on `storage_partition` (32 KB at 0xEC000, 4 KB sectors). At boot `keyboard.c` loads the saved keymap and settings, or the defaults if nothing valid is saved. The protocol's `save`, `revert` and `factory_reset` now work, and the handshake reports the `persistence` capability. Fn+N updates the NKRO setting, so a save keeps it; debounce and NKRO are applied from the loaded settings. New Kconfig defaults: `KB_SLEEP_TIMEOUT_MIN` (15) and `KB_INDICATOR_BRIGHTNESS` (13%).
- Size, debug without a screen: 85.4 KB flash, 30.5 KB RAM.

### Phase 5: config protocol v1 (2026-10-23)

- `protocol/protocol.yaml` defines version 1: the frame (4-byte header, up to 60 payload bytes in a 64-byte report), the vendor HID interface (usage page 0xFF00, usage 0x44), ten status codes, ten capability bits, and the commands: `handshake`, `reboot` (normal or into UF2), `identify` (blink the LEDs 1–30 s), `get_serial`, `get_key`, `set_key`, `get_keymap_chunk` and `set_keymap_chunk` (28 keycodes per frame; a chunk write is all or nothing), and `save`, `revert`, `factory_reset` (persistence arrives in phase 6). `protocol/README.md` documents the frame.
- `protocol/gen/gen.py` (Python 3 + PyYAML) writes `kb/protocol_gen.h`, `protocol_gen.c` and `host-lib/src/protocol.gen.ts`. CI runs it with `--check` so generated files can't drift.
- Core: `kb/protocol.h` handles one request and builds the response. Every length, index and keycode is checked before anything changes; any request but the handshake with the wrong version byte gets `version_mismatch`; error responses carry no payload. Tests: `test_protocol` (every command, every error path) and `test_protocol_fuzz` (random and mutated frames, with invariants: a response always comes back, nothing changes on an error, the keymap stays valid). A libFuzzer target (`firmware/core/fuzz/`) runs for two minutes in a new CI job with ASan and UBSan.
- `get_serial` exists because WebHID can't read the USB serial string; the firmware returns the same hex text as the USB descriptor, so the app can tell two boards apart.
- Firmware: a third HID interface (`hid_config`, 64 bytes in and out) in `kb_usb.c`; `config.c` queues requests from the USB thread and answers them on its own thread, locking the keymap against the scan thread. `reboot` waits 100 ms so the response leaves first. `identify` blinks the indicators.
- host-lib: `protocol.ts` builds request frames and parses responses (`encodeRequest`, `decodeResponse`), on top of the generated encoders and decoders. The transports and typed client come in phase 7.
- CI: the bootloader job now times out after 20 minutes (one run hung installing packages).
- Size, debug without a screen: 80.8 KB flash, 29.9 KB RAM.

### Phase 1: Scaffold (2026-10-21)

- Stack locked: C on Zephyr / NCS v3.4.1 for firmware and dongle; TypeScript host-lib.
- `west.yml` pins NCS v3.4.1 for CI and for optional self-contained workspaces.
- `firmware/`: Zephyr app that boots and logs its version (`VERSION`, `prj.conf`, and `release.conf`, which compiles logging out).
- `firmware/core/`: hardware-independent C library with a standalone CMake/CTest host build and a header-only test harness. It holds only a placeholder API-version function for now.
- `dongle/`: Zephyr app skeleton.
- `host-lib/`: TypeScript ESM package with `tsc` and `node:test`, and one smoke test. Dev dependencies: `typescript` 7, `@types/node` 24.
- `protocol/`, `boards/` and `app/` hold READMEs only.
- `.github/workflows/ci.yml`: core tests, host-lib tests, and debug and release firmware builds (DK and dongle board targets).

### Board definition: Dachshund70 (2026-10-21, before phase 2)

- `boards/Dachshund70/keyboard.json`: generated from `KLE Info/keyboard-layout(2).json`. It has 79 keys plus an alternate 6.25u spacebar (layout option), an encoder at x=15 right of Delete, and 2 indicators (Caps, layer).
- `boards/Dachshund70/board.json`: proposed pin map for the MDBT50Q-P1MV2, a 6×15 COL2ROW matrix, encoder P0.11/P0.12, SK6812 data on P0.06 with LED power enable on P0.08, charger status on P0.15, and battery measured through VDDH.
- USB IDs: pid.codes test PIDs, 1209:0001 for the keyboard and 1209:0002 for the dongle.
- `host-lib/test/boards.test.ts` validates every board folder: matrix range and uniqueness per layout option, no key overlaps, and pins that are valid, unique and not reserved.

### PCB tooling: KiCad MCP (2026-10-21)

- `.mcp.json` registers the Konnect v0.13.0 MCP server (mixelpixx/Konnect, AGPL-3.0, beta) for KiCad 10. It runs from the KiCad 3rd-party plugin folder.
- Konnect is installed through KiCad's Plugin and Content Manager, and KiCad's IPC API server is enabled. It connects from Claude Code with 228 tools, and KiCad 10.0.3 was detected.
- `hardware/Dachshund70/`: the KiCad 10 project (`.kicad_pro`, `.kicad_sch`, `.kicad_pcb`).
- `.gitignore` excludes KiCad lock files, `.history/` backups, `*.kicad_prl` view state and `fp-info-cache`.
- The kbplacer and kleplacement KiCad plugins are already installed and can place switches from the KLE layout.

### PCB: Dachshund70 schematic and placement (2026-10-21)

Decisions: MX hot-swap (Kailh sockets), 2 layers, MCP73831 charger at 500 mA (2 kΩ PROG; lowered to 300 mA on 2026-10-26, see below) for a 1000–2000 mAh cell, and USB-C on a separate daughterboard.

- Schematic: one A2 sheet with 195 parts. ERC is clean (0 errors, 0 warnings). A script checked all 29 module pin nets against `board.json` (0 mismatches).
- The board has no USB-C connector. J1 is a JST-SH 4-pin for the daughterboard, carrying VBUS, D−, D+ and GND in the Unified Daughterboard order (checked on 2026-10-22; see the daughterboard section).
- Power path: VBUS feeds the MCP73831, which charges VBAT (JST-PH battery). The slide switch connects VBAT to VSYS, which feeds VDDH (high-voltage mode). VDD (REGOUT0) is +3V3. (A USB power path was added on 2026-10-23; see "PCB: USB power path".)
- Charge status: a BAT54WS Schottky sits between the MCP73831 STAT pin and P0.15. STAT drives 5 V when charging completes, and the diode passes only the low (charging) level.
- LEDs: the load switch is a TPS22917 (KiCad has no TPS22918 symbol); its QOD pin is unconnected and EN has a 100 kΩ pull-down.
- DCCH is unconnected, so firmware must run REG0 in LDO mode.
- Matrix: 80 switch positions with one 1N4148W each. The 6.25u bar (SW606) and the 2.75u split space (SW615) share diode D606. The encoder push is at (0,14) through D114.
- Footprints: the hot-swap and stabilizer footprints are vendored into `hardware/Dachshund70/lib/keyswitch.pretty` (perigoso v2.4, CC-BY-SA-4.0) and converted to the KiCad 10 format; see `lib/README.md`.
- Spacebar: hot-swap sockets for the 6.25u bar and the split space physically overlap. SW604, SW606 and SW615 use solder-only 3-pin plate-mount footprints (stock `SW_Cherry_MX_*_Plate`); the rest of the board is hot-swap.
- Placement: switches, stabilizers and the encoder are on the front at KLE positions (19.05 mm pitch). All SMD parts are on the back. An 18 mm strip above the F-row holds the module (antenna at the top edge), power, connectors, reset and SWD. The outline is 306.8 × 138.1 mm.

### PCB: horizontal encoder, compact layout and routing (2026-10-21)

- Encoder: the EC11 is replaced by a Bourns PEC12R-4220F-S0024 (horizontal, 24 detents, push, 20 mm shaft), using the stock `RotaryEncoder_Bourns_Horizontal_PEC12R-2x17F-Sxxxx` footprint. A roller about 12 mm wide and 20 mm across sits on the shaft in the encoder's KLE column (x = 15u) and rolls front to back like a mouse wheel. The body sits just past 16u.
- Layout: the 18 mm top strip is gone. The module, charger, connectors, power switch, reset, SWD and LED load switch sit on the back in the empty column under the encoder. The module antenna faces the right edge (0.75 mm away), and the slide switch actuator is at the right edge.
- Outline: 318.5 × 121.1 mm (x 19–337.5, y 39–160.1), about 12.7 mm wider than 16u. Corner radius is 5 mm (changed from 1 mm on 2026-10-22). About 6 mm is the most the top-right corner allows before the encoder's mounting tab gets too close to the edge.
- Routing: Freerouting 2.5.0 (JAR on a portable Temurin 25 JRE) autorouted every signal and power net with 0 violations: 0.25 mm signal tracks, and a 0.3 mm power class for VBUS, VBAT, VSYS, LED_VDD, GND and +3V3. KiCad's Specctra export drops the module's antenna rule area, so a matching keep-out was added to the DSN before routing. The SES was imported with KiCad's own `pcbnew.ImportSpecctraSES`, and 118 unused fanout vias were removed.
- Ground: GND pours on F.Cu and B.Cu (0.3 mm clearance, thermal reliefs), about 690 GND stitching vias, and short via ties for boxed-in decoupling-cap pads.
- Design rules: the minimum track width is now 0.15 mm, because Freerouting necks tracks down to 0.187 mm at fine-pitch pads.

### Phase 2 firmware: board bring-up (2026-10-22, merged to main)

- Pin check: all 29 module pins in `board.json` match the routed PCB pad for pad, and USB, SWD and VDDH sit on the right pads. Diodes are COL2ROW in the PCB (cathode on the ROW net).
- Zephyr board `dachshund70/nrf52840` (HWMv2) in `boards/Dachshund70/`:
  - devicetree written from `board.json`
  - Adafruit UF2 flash layout: app at 0x26000, storage at 0xEC000, bootloader at 0xF4000
  - `zephyr.uf2` output, with uf2 as the default `west flash` runner, plus nrfutil, jlink and pyocd for SWD
  - P0.18 as nRESET, and REG0/REG1 left in LDO mode, since DCCH is unconnected
  - `board.c` sets UICR REGOUT0 to 3.3 V on first boot in high-voltage mode, then resets
- Raw pin groups (matrix, encoder, charge status) sit in `zephyr,user` until the phase 3, 9 and 13 drivers replace them.
- USB (device_next): boot-protocol HID keyboard on 1209:0001, "Dachshund" / "Dachshund70". The serial number comes from the chip's factory ID, so it's unique per board; `bcdDevice` comes from `firmware/VERSION`; bMaxPower is 500 mA. VID, PID and strings are Kconfig options in `firmware/Kconfig`. It sends no key reports yet, and the lock-LED output report is stored but not shown.
- LED bring-up: enables the TPS22917 (P0.08), then lights one SK6812 at a time in chain order (layer, battery 1–4, Caps), cycling red, green and blue every 500 ms at low brightness. This shows both the chain order and the colour order.
- Reboot to UF2: hold Esc (row 0, col 0) for 3 s. That writes GPREGRET = 0x57 and resets. The phase 3 keymap action replaces this.
- Logging over SEGGER RTT on the SWD header, since the board has no UART. Release builds have no logging and no RTT.
- Core: `kb_version_bcd_device` and `kb_hold` (long-press detector, timestamp wrap-safe), with host tests.
- host-lib `firmware-board.test.ts`: the devicetree matrix, encoder, charger and LED pins, the LED chain length and the Kconfig USB IDs must all match `board.json`. A deliberately wrong DTS pin makes it fail.
- CI builds `dachshund70/nrf52840` with `-DBOARD_ROOT` and uploads `zephyr.uf2`. Debug: 67.6 KB flash, 16.9 KB RAM. Release: 51.9 KB flash, 13.4 KB RAM. Both UF2 files start at 0x26000 with family ID 0xADA52840.

### Status screen on J4, OLED or e-paper (2026-10-22, merged to main)

The status display is now in scope: SPEC.md moved it out of "Not in v1", and added it under Tier 3 plus a layout editor in the GUI list. The panel is not chosen yet, so the firmware supports both kinds, picked at build time.

- Board devicetree:
  - `display_header` is a GPIO nexus indexed by J4 pin number: 3 DIN, 4 CLK, 5 CS, 6 DC, 7 RST, 8 BUSY. Its binding is in `boards/Dachshund70/dts/bindings/`.
  - `display_i2c` (TWIM0: SDA P0.21, SCL P0.19, with pull-ups) and `display_spi` (SPIM2: SCK P0.19, MOSI P0.21, CS on J4-5) are both disabled until a panel overlay enables one.
- Panels, in `firmware/displays/`: SSD1306 128×32, SSD1306 128×64, SH1106 128×64 (all I2C at 0x3C), and the Waveshare 2.13" e-Paper V4 (SSD1680, 250×122, SPI). Panel settings are copied from Zephyr's own shield definitions. Select one with `-DEXTRA_DTC_OVERLAY_FILE=displays/<panel>.overlay`. `CONFIG_KB_SCREEN` then turns on from the `zephyr,display` chosen node. With no overlay, the build is exactly as before.
- Core `kb/screen.h`:
  - Layouts are up to 8 widgets on a character grid: text, layer, locks, battery, connection.
  - Each widget has a row, a column and an alignment (left, right or centre), plus 16 layer names.
  - Rows that don't fit are skipped, so one layout works on every panel.
  - `kb_screen_layout_validate` checks every field, ready for layouts sent from the host later.
  - Host tests cover rendering, alignment, truncation and rejected layouts.
- Firmware `status_screen`:
  - Draws with Zephyr's character framebuffer (10×16 font: 12×2 cells on 128×32, 12×4 on 128×64, 25×7 on the 2.13" e-paper).
  - OLED changes redraw within 20 ms. E-paper redraws at most every 3 s, and changes in between are combined.
  - Lock state (from the USB LED report) and the USB connection are live. Layer shows "Base" until phase 3, battery "BAT --" until phase 13.
  - `status_screen_set_layout()` swaps the layout at run time, for the configurator once the protocol exists.
- Build-time options (Kconfig): custom text (default "Dachshund70"), which widgets to show, font index, invert, and the e-paper refresh interval.
- host-lib tests:
  - The J4 map and the display I2C/SPI pinctrl must match `board.json`.
  - Panel overlays must not use raw `&gpio` pins or pinctrl.
  - The LED MOSI check now looks only at the SPIM3 pinctrl.
  - Moving the DC pin in the DTS makes the test fail.
- CI builds one firmware per panel (debug and release) and checks `CONFIG_KB_SCREEN=y`. Run 39862064737 is green. The screen adds about 22 KB of flash and 9 KB of RAM (debug: 91.5 KB flash, 26.1 KB RAM with the 128×32 OLED).

### Doghouse configurator, first cut (2026-10-22, merged to main)

Started ahead of phases 5 and 7, so the design can be reviewed before boards arrive. It runs in the browser against simulated boards.

- Choices: Svelte 5 + TypeScript + Vite in `app/`; Tauri later; the app is named Doghouse. New dev dependencies in `app/`: vite, svelte, @sveltejs/vite-plugin-svelte, svelte-check and typescript (6, because svelte-check doesn't support 7 yet). host-lib gained no dependencies.
- host-lib:
  - Typed `Board`/`BoardManager` API (`types.ts`): board info with connection kind (usb, dongle, ble), battery, keymap and encoders, settings with limits, save/revert/factory reset, identify, events, and `BoardError` codes matching SPEC.
  - Keycode catalog (`keycodes.ts`): QMK-style ids in 9 categories, plus layer and Bluetooth profile keys that depend on the layer count.
  - `default-keymaps.ts`: base and Fn layers for the Dachshund70. Fn has media keys on the F-row, BT1–3 and output selection on 1–6, navigation on the arrows, and QK_BOOT on Esc.
  - `MockBoard`/`MockBoardManager`: they validate like the firmware, keep live and saved copies, simulate battery charge and drain, and support plug/unplug.
  - 45 host-lib tests in total.
- App:
  - Pack sidebar: dachshund avatars, connection chips, bone battery meters, unsaved dots.
  - Board header: name, model, serial, connection, battery, and Identify/Revert/Save.
  - Keys tab: board drawn from `keyboard.json`; layer tabs with colours and counts; spacebar option; transparent keys show what they fall through to; roller forward/back/press; LED row with a live battery gauge; searchable palette; drag and drop; undo/redo; keyboard shortcuts.
  - Settings and About tabs; light and dark themes; toasts; a "Simulated" panel to plug in, unplug and set battery.
  - 14 Node tests for geometry, transparent-key resolution and undo history.
- Checked in the browser at 1440×900 in light and dark, and at 800×600: editing a key, the Fn layer, Save, rename, and plugging in more boards. svelte-check reports 0 errors and 0 warnings; the production build is 102 KB of JS (36 KB gzipped).

### Repo housekeeping (2026-10-23)

- CI runs once per pull request. Before, every push to a PR branch started two identical runs (push and pull_request). Pushes now trigger CI only on `main`; a branch gets CI through its PR or with "Run workflow" in the Actions tab. A newer push to a PR cancels its run that is still going.
- The USB-C daughterboard (`hardware/Dachshund70-USB/`), designed on 2026-10-22 on a local branch, was rebased onto main and got its own PR.
- Deleted the fully merged branches `doghouse-app`, `phase2-firmware`, `status-screen`, `dongle-pcb` and `ci-one-run-per-pr`, locally and on GitHub.

### UF2 bootloader board definition (2026-10-23)

- `boards/Dachshund70/bootloader/`: board files for the Adafruit nRF52 bootloader (`board.h`, `pinconfig.c`, `board.mk`, `board.cmake`) and `build.sh`, which clones the bootloader at a pinned master commit (c67f0bcf, 2026-05-21), adds the board and builds it. The 0.9.2 release uses an older board API (`BUTTONS_NUMBER`), so it can't build these files.
- Output: `dachshund70_bootloader_s140_6.1.1.hex` (MBR, S140 6.1.1, bootloader and UICR) for the first SWD flash, and `bootloader_mbr.uf2` for later updates from the UF2 drive. The steps are in the folder's README.
- Entering UF2 mode: double-tap reset, or hold Esc at power-up or reset. `board_init2()` drives col 0 (P0.02) high, and the bootloader reads row 0 (P1.10) with a pull-down. Holding Esc for 3 s in the firmware still works (GPREGRET 0x57).
- Status shows on all six SK6812s (P0.06), with P0.08 turning on LED power. REGOUT0 is set to 3.3 V on first boot. USB is 1209:0003, a pid.codes test PID, with a "DACHSHUND" drive. `board.json` now lists it under `usb.bootloader`.
- Flash layout fix: on the nRF52840 the bootloader reserves 40 KB below itself (0xEA000–0xF3FFF), and it ignores UF2 app writes there. `code_partition` shrinks from 0xC6000 to 0xC4000, so it ends at 0xEA000. `storage` (0xEC000) was already in the reserved area, which DFU never erases.
- host-lib `bootloader-board.test.ts`: the LED pin, count and power pin, the Esc row and column, the USB IDs and names must all match `board.json`, and the devicetree partitions must fit the bootloader's layout. Moving the code partition back to 0xC6000 makes the test fail.
- CI job "UF2 bootloader (Dachshund70)" builds the bootloader with Ubuntu's `gcc-arm-none-eabi` and pip's `intelhex`, and uploads the hex and UF2 as `bootloader-<sha>`.

### Phase 3: matrix, debounce, keycodes and keymap (2026-10-23)

- Core (hardware- and transport-independent, host-tested):
  - `kb/keycodes.h`: the 16-bit keycode model. Ranges for HID keys and modifiers, consumer and system keys, keys with modifiers (`LSFT(KC_1)`), layer actions (`MO`, `TG`, `TO`, `DF`, `OSL`), one-shot mods (`OSM`), layer-tap (`LT`), firmware actions (`QK_BOOT`, connection, mouse...) and mod-tap (`MT`, `LCTL_T`...). 0xA000 and up is reserved for phase 9. Names match Doghouse's QMK-style ids. `kb_keycode_kind()` rejects anything undefined, including layer keys past the layer count; the protocol will use it to refuse bad keycodes.
  - `kb/keymap.h`: a keymap in caller-owned RAM, with get/set by (layer, row, col) that bounds-checks every index and keycode, and lookup through active layers with transparent (`KC_TRNS`) and opaque no-op (`KC_NO`) keys. Up to 16 layers.
  - `kb/debounce.h`: five algorithms, picked at run time: deferred or eager, per key or whole matrix, plus eager press with deferred release (the default). Time 0–100 ms (default 5). Wrap-safe timestamps.
  - `kb/engine.h`: turns key events into HID state (modifier byte, six boot keys in press order, an NKRO bitmap, consumer and system usages). Handles layers, held modifiers counted per key, one-shot mods and layers (held, they act like normal mods and `MO`), and layer-tap/mod-tap with a tapping term (default 200 ms). Keys pressed while a tap-hold key is undecided wait in a 16-event queue, so they land on the right layer. Firmware actions go to a callback. Permissive hold and the other tap-hold options are phase 9.
  - Tests: `test_keycodes`, `test_keymap`, `test_debounce` and `test_engine` (28 engine cases with simulated events and timestamps). They also pass with AddressSanitizer and UBSan.
- Firmware:
  - `matrix.c`: COL2ROW scan with pins from the devicetree; it drives one column, waits 5 µs (`CONFIG_KB_MATRIX_SETTLE_US`), reads the rows, then waits until the rows drop (at most 10 µs) before the next column.
  - `keyboard.c`: a scan thread on a 1 kHz timer (`CONFIG_KB_MATRIX_SCAN_PERIOD_US`): scan, debounce, engine, tick. Debounce algorithm and time, and the tapping term, are Kconfig options for now; the host sets them in phase 10. The layer shows on the status screen. Key events are never logged.
  - `default_keymap.c`: the 4-layer default (Base, Fn, two transparent layers), the same as `host-lib/src/default-keymaps.ts`. The firmware runs a RAM copy, ready for live edits.
  - `QK_BOOT` (Fn+Esc) reboots into UF2 at once; `QK_RBT` reboots. Holding Esc for 3 s still reboots into UF2, now read from the debounced matrix and independent of the keymap, as a recovery path.
  - USB: key reports are queued (16 deep) and sent one per poll, so a tap within one millisecond still reaches the host as press then release. Before this, `hid_device_submit_report` ran synchronously and would have blocked the scan thread while the host wasn't polling.
- host-lib `firmware-keymap.test.ts`: every Doghouse keycode id is defined in `kb/keycodes.h`, and the firmware default keymap matches host-lib's key for key. Encoder mapping is compared once the firmware has it (phase 9).

### Phase 4: full HID over USB (2026-10-23)

- Core (hardware- and transport-independent, host-tested), `kb/hid.h`:
  - Report descriptors for two HID interfaces. Keyboard: the standard boot keyboard (8-byte 6KRO report, no report ID, 5-bit lock-LED output). Extra: report ID 1 is an NKRO keyboard (modifier byte plus a 224-bit bitmap for usages 0x00–0xDF, 30 bytes with the ID), ID 2 consumer control (one 16-bit usage up to 0x3FF), ID 3 system control (one 16-bit usage up to 0xB7).
  - Packers for each report, and `kb_hid_reporter`, which turns the engine's HID state into the reports to send: only those that changed, keys on exactly one path (NKRO or boot), and on a path switch a release on the old path before the press on the new one, so no key sticks. NKRO is used only while it's enabled and the host hasn't asked for boot protocol, so a BIOS or KVM always gets the boot report. `resync` sends everything again after a resume or a new configuration. BLE and the dongle will reuse it.
  - `kb/indicators.h`: colour per LED from the lock state, active layer, battery level and suspend, for a chain described by role (layer, Caps/Num/Scroll, battery step). Defaults: layer 0 dark, Fn amber, layers 2 and 3 teal and violet, Caps warm white, brightness 32/255. Battery steps light from (k − 1)/n, red at 15% and below; the level arrives in phase 13. Phase 10 makes the colours settable.
  - New keycode `NK_TOGG` (0x7005), also in host-lib's catalogue. The default Fn layer has it on N, in both the firmware and Doghouse default keymaps.
  - Tests: `test_hid` (a small HID descriptor parser checks every report size against its packer; reporter paths, boot fallback with a key held, NKRO toggling, resync, and seven keys through the engine) and `test_indicators`. All core tests pass, also under ASan and UBSan.
- Firmware:
  - `kb_usb.c`: the second HID interface (`hid_extra` in `app.overlay`, 30-byte reports, 1 ms polling), a 16-deep queue per interface, GET_REPORT for every report, and remote wakeup in the configuration descriptor. If a queue overflows (the host stopped polling), it's purged and every report is sent again from the current state, so no release is lost.
  - Suspend: reports stop and the indicators go dark. The first key change while suspended asks the host to wake (if the host enabled remote wakeup); on resume, every report goes out again. Unplugging or a bus reset clears the suspended state.
  - `keyboard.c` drives the reporter from the scan thread: it follows the host's protocol choice, resyncs when USB asks, and handles `NK_TOGG`. `CONFIG_KB_NKRO` (default on) sets NKRO at power-up; phase 6 will store it and phase 10 lets the host set it.
  - `indicators.c` replaces the phase 2 LED walk: the walk now runs once at power-up (`CONFIG_KB_LED_SELFTEST`, 200 ms per colour, 3.6 s), then the Caps LED follows Caps Lock and the layer LED shows the active layer. LED power (the TPS22917) is switched off whenever no LED is lit. A host-lib test checks the firmware's LED chain table against `keyboard.json`.
  - Size, debug without a screen: 76.6 KB flash, 24.3 KB RAM (was 73.0 KB and 22.7 KB).
- Bring-up plan: new rows for rollover, boot fallback, media keys, and suspend and wake; the LED rows match the new behaviour.

## PCB status and known issues

- SW604, SW606 (rotated 180°) and SW615 are soldered 3-pin footprints, placed with their centre holes on the KLE key centres. Stock MX footprints have their origin at pin 1, not the centre.
- DRC before routing: there are no shorts or drill overlaps, except that the 6.25u stabilizer's right holes and the right Mod's stabilizer holes coincide (0.04 mm apart, a warning). The remaining courtyard errors on the spacebar row are expected because the two layouts deliberately overlap; add them as DRC exclusions in KiCad. The stock SK6812MINI-E reverse-mount footprint has 0.25–0.35 mm copper-to-cutout clearance against a 0.5 mm rule (fixed on 2026-10-23 with a project footprint; see "LED cutout clearance"). About 189 "footprint differs from library" warnings remain (run Update Footprints from Library in KiCad). Unrouted nets are expected.
- DRC fixes (2026-10-21, after review): removed a duplicate GND via at (319.3, 67.1) and a dangling /COL2 stub. The GND pours now use solid connections for SMD pads and thermal reliefs for through-hole pads, which cleared all starved thermals. The ST1–ST6 reference text is hidden. `Dachshund70.kicad_dru` adds two rules: 0.2 mm edge clearance at the D2/D3 LED cutouts (stock reverse-mount pads are 0.247 mm from the cutout corners, so check with the fab), and 0 mm for SW1's edge-mount tabs.

### PCB: module decoupling rework and re-route (2026-10-22)

The old column of decoupling caps at x = 318 sat across the module's left-edge signal exit, so C5, C6 and C7 ended up with GND pads boxed in by tracks on both layers. Rework:

- Power decoupling now sits in a row above the module's top-left corner, next to VBUS, VSYS and +3V3 (pins 28–32), with every GND pad facing up: C6 (+3V3 4.7 uF), C7 (+3V3 100 nF), C4 (VSYS 4.7 uF), C5 (VSYS 100 nF) and C2 (VBUS 4.7 uF), at x 312.6–321.0, y 64.
- The crystal sits left of the module's lower-left corner, level with XL1/XL2, with C8/C9 to its left: Y1 at (317.6, 75.8), C8/C9 at x 315.2. Its tracks run straight left, which keeps U1 pad 15 (GND) open to the pour. With the crystal below the module, as first tried, its tracks walled that pad in.
- Every SMD GND pad on the board (31 pads, module included) has its own via, placed before routing and kept fixed, so GND reaches both pours whatever the router does.
- The whole board was re-routed with Freerouting 2.5.0, with GND left to the pours and fanout vias; all signal and power nets routed. Then: 0.3 mm power class, antenna keep-out, unused router vias removed, GND pours (solid to SMD pads, thermal reliefs on through-hole pads), and about 670 stitching vias, none under back-side parts.
- DRC (kicad-cli, 2026-10-22): 0 errors and 0 unconnected items; the 7 spacebar items stay excluded through the project file. No copper in the antenna keep-out. Some SWDCLK and matrix tracks run on B.Cu under the module body between its pad rows (solder-masked, no exposed pads there).
- Warnings left: the ST4/ST6 coincident stabilizer holes, silkscreen overlaps on the spacebar row, 2 SW1 silkscreen segments at the edge, and 189 stale footprint copies (fix with Update Footprints from Library).
- Schematic parity: only the Description and Datasheet text fields differ. Run Update PCB from Schematic in KiCad to sync them.
- Not done: mounting holes (need a case design) and a plate and case cutout for the roller. The J1 pin order and the USB-C daughterboard were done later (see the daughterboard section).

### PCB: layer and battery indicator row (2026-10-22)

The layer LED no longer sits under Esc. A row of five reverse-mount SK6812MINI-E LEDs now sits on the back, shining through cutouts into the free area above the Right arrow (level with the Up key, y = 130.5 mm): the layer LED at x = 310, then a 4-step battery gauge (25/50/75/100%) at x = 316.5, 322, 327.5 and 333. Each LED has a 100 nF cap just above its VDD pad. The Caps Lock LED stays under Caps Lock.

- Schematic: D4–D7 (battery) and C15–C18 were added. The chain is now U1 P0.06 → D3 (layer) → D4 → D5 → D6 → D7 → D2 (Caps), and D2's DOUT is unconnected. ERC is clean, and the chain was checked in the exported netlist.
- `board.json`: indicator count 6. `keyboard.json`: indicator `id` is the chain index. Free-standing LEDs have an `at` position (centre, key units) instead of `underKey`, and battery LEDs carry a `level` from 1 to 4. The host-lib tests now check that ids follow the chain, that each indicator has exactly one position, and that no free-standing LED sits under a key.
- Re-routed the whole board with the same Freerouting pipeline. The DSN export now adds router keep-outs that KiCad leaves out: each LED cutout plus 0.15 mm, and a 0.35 mm band inside the board edge that follows the 5 mm corners. GND stitching now stays clear of the rounded corners and of all six LEDs.
- `Dachshund70.kicad_dru`: the 0.2 mm LED cutout rule now covers D2–D7. KiCad's `memberOfFootprint` didn't match a `D[2-7]` pattern, so the six references are listed one by one.
- DRC (kicad-cli): 0 errors and 0 unconnected items. The warnings are the same as before, plus 8 stale footprint copies for the new parts.
- The LED_D5 data line and LED_VDD both run about 310 mm across the board to the Caps LED; that's fine at 800 kHz.
- SPEC.md lists only layer and lock-state indicators under Lighting, so the battery gauge needs adding to the spec before the firmware and GUI work on it.

### PCB: display header (2026-10-22)

The case will carry a low-power display (e-ink or OLED) between the encoder and the indicator row. J4 is a 1×8 2.54 mm through-hole header on the front at y = 112.5 mm (pin 1 at x = 309.1), between the reset button and the LED load switch on the back. Each pin is labelled on the front silkscreen.

- Pinout, in Waveshare e-Paper module order: 1 +3V3, 2 GND, 3 DIN (P0.21), 4 CLK (P0.19), 5 CS (P0.20), 6 DC (P0.23), 7 RST (P0.22), 8 BUSY (P0.24). A 4-pin I2C OLED wires to +3V3, GND, CLK (SCL) and DIN (SDA). The nRF52840 maps SPI or TWI to any pin, and OLED modules carry their own pull-ups.
- Power comes straight from +3V3 (REGOUT0). That rail has about 25 mA for outside parts: enough for e-ink and a small OLED, tight for a large OLED at full white.
- `board.json` has a new `display` section, and the host-lib pin test now includes its pins.
- Re-routed with the same pipeline. DRC: 0 errors and 0 unconnected items; the warnings are unchanged. Nothing is in the antenna keep-out.
- Mechanical: a straight header stands about 8.5 mm tall and won't fit under a plate at 5 mm. The plate or case needs a cutout above J4, or use a right-angle header or solder wires directly.
- Keep the display, especially an OLED with a metal back, away from the module antenna at the right edge (x > 333, y 67–79 mm).
- Firmware support for the header followed on the same day (see Status screen above); SPEC.md now has the display in scope.

### PCB: USB-C daughterboard (2026-10-22)

The USB-C port lives on its own board, `hardware/Dachshund70-USB/` (KiCad 10, 2 layers, 1.6 mm). It connects to mainboard J1 with a JST-SH 4-pin cable.

- Shape: a 42 × 9 mm rectangle with 1 mm corners, so it sits along the case bezel. Two 3.2 mm plated holes sit 33 mm apart, on the board's centre line. They take M3 screws, or M2 with a washer. The 33 mm spacing matches the uDB S-series screw pattern, so a stock uDB-S board can use the same case bosses (it has a Pico-EZmate connector, so it needs an EZmate-to-JST-SH cable).
- Layout: the USB-C receptacle (HRO TYPE-C-31-M-12) is centred on the front edge. Its shell sticks out 1.3 mm past the edge, the same as uDB-S. J2 (JST SM04B-SRSS-TB) sits at the right end with its opening on the rear edge. The protection parts sit at the left end. All parts are on the front. The back carries the board name and J2's pinout.
- Circuit:
  - USB 2.0 sink only: 5.1 kΩ Rd on CC1 and CC2, no PD.
  - USBLC6-2SC6 (U1) clamps ESD on D+, D− and VBUS. The mainboard has no USB protection of its own, so this is the only ESD clamp.
  - A 750 mA-hold 1206 PTC (Bourns MF-NSMF075-2) sits between the connector's VBUS and J2.
  - The receptacle shell and both screw holes are a SHIELD net, tied to GND only through a 600 Ω ferrite bead (FB1), as on uDB boards. Metal screws ground a metal case through FB1.
- Pinout: J2 is 1 VBUS, 2 D−, 3 D+, 4 GND, the same as mainboard J1 and the Unified Daughterboard spec (checked against the uDB-S design files). Use a 1:1 cable, pin 1 to pin 1, not a reversed one.
- Routing: Freerouting, with a 0.4 mm keep-out band inside the board edge. Power nets (VBUS, GND, SHIELD) are 0.4 mm. Both layers have a GND pour, with stitching vias.
- Checks (kicad-cli): ERC 0 violations. DRC: 0 errors, 0 unconnected items, 0 schematic parity issues. Two warnings remain: the stock receptacle footprint draws silkscreen past the board edge, which the fab clips.
- BOM fields: every part has an MPN, and LCSC numbers where checked (C165948, C160404, C7519, C25905). F1 and FB1 have no LCSC number yet.
- KiCad's library has no 3D model for the HRO receptacle. A generated model is used (see "3D models for case design").

### PCB: 2.4 GHz dongle (2026-10-23, merged to main in PR #1)

The receiver for phase 14 now has a board: `hardware/Dachshund70-Dongle/` (KiCad 10, 2 layers, 1.6 mm), a 40 × 24 mm desk puck that connects to the computer with a USB-C cable. `hardware/Dachshund70-Dongle/README.md` has the full design notes, the polling-rate limit and the latency budget.

- Form factor: a puck with a cable rather than a plug-in stick, chosen so the receiver can sit next to the keyboard, away from USB 3 noise and the PC case.
- Parts:
  - Raytac MDBT50Q-P1MV2, the same module as the keyboard. Its antenna is flush with the right edge, with a full-width copper keep-out on both layers.
  - HRO USB-C, USBLC6-2SC6 and a 750 mA PTC, the same parts as the USB-C daughterboard (see its section above).
  - PAIR and RESET buttons, an RGB status LED, and an SWD header in the keyboard's pin order.
- Power: VBUS feeds both VBUS and VDDH (high-voltage mode). REGOUT0 must be set to 3.3 V by firmware, and DCCH is unconnected (LDO). There's no 32.768 kHz crystal, so firmware uses LFRC.
- Pins: `board.json` has a new `dongle` section, where the generator reads them from:
  - PAIR on P1.06
  - LED red P0.08, green P1.09, blue P0.12 (active low)
  - nRESET on P0.18
  These match Nordic's PCA10059, so dongle firmware can be developed on one. Adafruit's `pca10059` UF2 bootloader uses the same DFU button (P1.06), so it should work here as-is. This is untested.
- host-lib: a new test checks the dongle pins (valid, unique, not reserved). It fails if PAIR is moved to the reserved P0.18. There are now 46 tests.
- Routing:
  - D+/D− are hand-routed as a matched pair (about 23.5 mm each) over the B.Cu ground plane.
  - The USB-C fan-out has no vias on the data lines.
  - Supply tracks into the module are hand-routed and locked.
  - Freerouting did the rest, then GND pours and stitching vias were added.
- Checks (kicad-cli):
  - ERC 0.
  - DRC: 0 errors, 0 unconnected items, 0 parity issues. The two warnings are the stock receptacle footprint's silkscreen at the board edge, which the fab clips.
  - A script checked every module pad and each GPIO's net through to its button, LED, SWD and USB pins against `board.json`: 0 mismatches.
- Polling rate: **1000 Hz maximum.** The nRF52840 has full-speed USB only, which polls at most once per 1 ms frame. 4–8 kHz would need High-Speed USB, which means another receiver chip (for example the nRF54LM20A). That's out of v1 scope.
- Estimated latency over the dongle, to be measured in phase 14: about 1 ms typical and about 2.5 ms worst case without retransmits, compared with 7.5–15 ms for BLE. The README lists the firmware settings this depends on: GPIO-sense wake, eager press debounce, ESB at 2 Mbit/s with fast ramp-up, HFXO kept on, BLE off in dongle mode, ACK payloads for host→keyboard data, and bInterval 1 on the dongle.
- Not done: the case (light pipe, button caps, USB-C cutout; the M2 holes are placeholders), the manufacturer's STEP for the receptacle (a generated model is used for now), and a Zephyr board target for the dongle (phase 14).

### Plate: FR4 gasket-mount switch plate (2026-10-23)

`hardware/Dachshund70-Plate/` holds a generated 1.6 mm FR4 plate. `gen_plate.py` (run with KiCad's Python) reads the mainboard and writes `Dachshund70-Plate.kicad_pcb`; the README has the full geometry.

- Decision: the mainboard gets no mounting holes. The PCB hangs from the hot-swap switches, and the plate is gasket-mounted.
- 80 switch cutouts (14 mm, 0.5 mm corners) and 12 stabilizer cutouts (screw-in stabilizers only since 2026-10-23; see below). Both spacebar layouts are cut; where they overlap the holes merge, and only soldered switches sit in the merged slot.
- A notch at the top right for the roller encoder, a slot over the display header J4, and 4 mm windows over the indicator LEDs D3–D7.
- 8 gasket tabs (4 top, 4 bottom), 2.8 × 6.5 mm, for 8 × 5 × 5 mm silicone socks. Sock outlines are on Cmts.User for the case design.
- An exposed-copper accent ring around every switch and stabilizer cutout, ≥ 0.4 mm from every routed edge. A stabilizer and its switch share one outline, since the 1.44 mm web between them is too narrow for two rings. ENIG recommended.
- DRC (kicad-cli): 0 violations.

### PCB: LED cutout clearance (2026-10-23)

- D2–D7 now use a project footprint, `Dachshund70:LED_SK6812MINI-E_3.2x2.8mm_P1.5mm_ReverseMount_Cutout3.4` in `hardware/Dachshund70/lib/Dachshund70.pretty` (registered in the project `fp-lib-table`). It is the stock KiCad footprint with the corner-relief light cutout replaced by a plain 3.4 × 3.4 mm cutout with 0.5 mm corners.
- Pads are now 0.35 mm from the routed edge (was 0.247 mm), and the nearest track about 0.36 mm. The LED body (3.2 × 2.8 mm) clears the rounded corners by about 0.05 mm. Nothing was re-routed.
- `Dachshund70.kicad_dru`: the LED cutout rule is raised from 0.2 mm to 0.3 mm. The schematic's footprint fields for D2–D7 point at the new footprint.
- Checks (kicad-cli): ERC 0. DRC: 0 errors and 0 unconnected items after refilling the zones. The warnings are unchanged.

### 3D models for case design (2026-10-23)

`python hardware/export_step.py` writes STEP files of every board to `hardware/step/` (committed since 2026-10-23, so they reach every device): the mainboard, the plate, the mainboard and plate stacked, the daughterboard and the dongle. The mainboard, plate and assembly share an origin (the centre of the mainboard outline). The plate's bottom face is 5.0 mm above the PCB's bottom face, so the plate's top is 5.0 mm above the PCB's top (the MX spec).

- Mainboard: the footprints had lost their 3D model links (only J4 had one). Every footprint now carries its library's models again.
- Keyswitch models (perigoso v2.4, CC-BY-SA-4.0) are vendored into `hardware/Dachshund70/lib/keyswitch.3dshapes/`: the Kailh hot-swap socket, the Cherry MX switch (PCB and plate versions) and the 2u and 6.25u stabilizers. The vendored hot-swap footprints now show the switch body as well as the socket. The three soldered spacebar-row switches use the plate-mount switch model without a keycap.
- The two spacebar layouts are both modelled, so their switches overlap in the 3D view.
- USB-C receptacle (daughterboard and dongle J1): KiCad has no model for the HRO TYPE-C-31-M-12, so `hardware/3dmodels/` has one (see below).
- Dongle D1 uses KiCad's Würth PLCC4 3.2 × 2.8 mm RGB LED model (same package as the ASMB-MTB0).
- Encoder SW3 and battery connector J2 use dimensioned stand-ins in `hardware/3dmodels/` (KiCad's 3D library has neither model). The real STEPs need a Bourns/SamacSys account and JST's emailed licence download; swap them in when you have them.

### Stabilizer cutouts, USB-C and JST models (2026-10-23)

- Plate stabilizer cutouts were the Cherry plate-mount size (6.75 × 12.3 mm), slightly smaller than the stabilizer model's housing at plate height (0.02 mm at the top, 0.025 mm on each side). They are now 7.0 × 14.7 mm, 6.5 mm above to 8.2 mm below the key centre, for screw-in stabilizers of any brand (the target is Swagkeys Knight). Plate-mount stabilizers no longer clip in. The size is `STAB_CUTOUT_*` in `gen_plate.py`. DRC: 0 violations.
- The old USB-C stand-in sat 7.3 mm behind its footprint on both the daughterboard and the dongle (its rotation flipped it), so in the STEP files the receptacle was inside the board instead of at its edge. That was only the 3D model; the footprints and copper didn't move.
- `hardware/3dmodels/gen_models.py` (run with FreeCAD 1.1's Python) now generates coloured models of the HRO receptacle (shell, opening, tongue and contacts, shell legs, SMD tails, locating posts) and the JST PH S2B-PH-SM4-TB (housing with cavity and latch window, contacts and tails, metal fittings), each in its footprint's frame. The footprints use them with no offset or rotation. On both boards the receptacle's front overhangs the board edge by 1.3 mm, as designed.
- Checked: the STEP exports place both receptacles and J2 on their footprints, and `kicad-cli pcb render` shows them as expected. Not checked against real parts.

### PCB: USB power path (2026-10-23)

The mainboard ran only from the battery: with the switch off it was off even on USB, and with no battery it browned out. Tiam chose Microchip's load-sharing circuit for the MCP73831 (AN1149) before ordering.

- Schematic: SW1's common pin now feeds a new net, VBAT_SW, instead of VSYS. Q1 (AO3401A P-MOSFET, SOT-23) has its drain on VBAT_SW, source on VSYS and gate on VBUS, with R3 (100 kΩ, 0603) pulling the gate to GND. D8 (B5819W Schottky, SOD-123) feeds VSYS from VBUS. On USB, Q1 is off and VSYS is about 4.7 V from D8. Unplugged, the gate falls to 0 V and Q1 connects the battery. The charger stays on VBAT, before the switch, so it charges with the switch off.
- Effects: the board runs from USB with no battery or with the switch off, and the switch is now only a battery disconnect. VDDH (and so the SAADC battery reading) shows the USB-fed VSYS while USB is in, so phase 13 reads the cell only on battery and shows charging from CHG_STAT. The SK6812s now see about 4.7 V on USB instead of at most 4.2 V. Their input-high threshold is 0.7 × VDD, about 3.3 V at 4.7 V, so a 3.3 V data line would have no margin on USB (at a full cell the threshold is 2.9 V). So a buffer was added, below.
- PCB: the three parts sit on the back between J2, J3 and SW1 (x 326–332, y 104–110), hand-routed: 0.3 mm power tracks, a 0.25 mm gate track. VBUS comes down on F.Cu from the J1 via at (331.7, 89.2), with vias at D8/R3 and at the gate. The old VSYS track from SW1 pin 2 now carries VBAT_SW to Q1's drain. 12 GND stitching vias in the way were removed, and the pours refilled.
- Checks (kicad-cli 10.0.7): ERC has the same 4 warnings as before and no errors. DRC with schematic parity: 0 errors, 0 unconnected items, and the same warnings as before (silkscreen, hole-to-hole on the stabilizers, and the stale footprint copies).
- LED data buffer (Tiam chose it over a silicon diode for D8 or testing as is): U4 (SN74LV1T34DBV, SOT-23-5), powered from LED_VDD with C19 (100 nF, 0402), sits between P0.06 (LED_DIN) and D3's DIN (new net LED_DIN_BUF). Its inputs are TTL-level (high above about 1.35 V at 4.5 V) at any supply from 1.6 V to 5.5 V, and its inputs tolerate 3.3 V while LED_VDD is switched off (Ioff). It sits on the back above D3 at (309.0, 121.2). VCC reaches the F.Cu LED_VDD track through a via, the output uses the old via down to D3, and four GND stitching vias were removed. Firmware is unchanged: the buffer is non-inverting.
- `docs/bringup-test-plan.md` has new continuity checks, a USB-only power stage and an LED check on USB.
- Saving with KiCad 10.0.7 re-wrote the zone fills and the 3D model blocks, so the PCB diff is large; only the parts above changed.
- STEP files in `hardware/step/` re-exported on Tiam's PC with KiCad 10.0.6 after the power path, LED buffer and test pads (no missing-model warnings; the encoder and J2 still use the stand-ins).
- KiCad 10.0.6 re-saves `Dachshund70.kicad_pro` without the unused teardrop `td_enabled` flags and with `null` for empty net colours and net-class assignments, undoing what 10.0.7's pcbnew wrote. That re-save is committed; DRC and ERC are identical either way.

### PCB: test pads (2026-10-23)

- Nine test points on the mainboard's back for meter probing: TP1 VBUS, TP2 VBAT, TP3 VBAT_SW, TP4 VSYS, TP5 +3V3, TP6 LED_VDD, TP7 CHG_STAT, TP8 and TP9 GND. Each is KiCad's `TestPoint_Pad_D1.5mm`, a bare round SMD pad with no part to buy. The schematic symbols are excluded from the BOM.
- Each pad sits on its net's existing track, so no new routing was needed. The net name is on the back silkscreen, and the reference is on the fab layer. Positions are in `docs/bringup-test-plan.md`.
- To make room, 7 GND stitching vias were removed, SW1's reference moved below the switch, and the pours were refilled.
- Checks: ERC unchanged. DRC with schematic parity: 0 errors, 0 unconnected items, and the same warning counts as before the pads.

### PCB: charge current lowered to 300 mA (2026-10-26)

- The project review (2026-10-26) found the 500 mA charge current plus the keyboard's own load (about 100–130 mA worst case through D8: module and radio, LEDs at full white, a display) adds up to about 630 mA, more than a 500 mA USB port allows. Tiam chose to lower it.
- R1 (MCP73831 PROG) is now 3.3 kΩ (was 2 kΩ), so the charge current is 1000 V / 3.3 kΩ, about 300 mA, and the total stays under 500 mA. Value change only (same 0603 footprint), in the schematic and the PCB. A 1000–2000 mAh cell now takes about 4–7.5 h to charge, and the charger runs cooler (about 0.4 W at the start instead of 0.6 W).
- `docs/bringup-test-plan.md`'s charger numbers are updated to match.

### PCB: antenna keep-out under U1 (2026-10-26)

- Review finding M6: the mainboard's copy of `RF_Module:Raytac_MDBT50Q` had lost the library footprint's keep-out zones, so nothing stopped copper under the antenna (the dongle has its own rule area). Raytac's MDBT50Q spec (Ver.K, p.9–13) asks for a 12.4 × 3.8 mm "no ground pad" band on every layer at the antenna end, plus a 1.6 × 1.2 mm area on the module's own layer, with the module at the board edge.
- Two board-level rule areas, mapped from the library footprint through U1's placement (back side, 90°, at (329, 73)) and checked against pads 1 and 55. "U1 antenna keep-out" covers F.Cu and B.Cu from (333.0, 66.8) to (337.5, 79.2): the library band, carried 0.75 mm further to the right board edge. "U1 antenna keep-out (B.Cu)" covers (331.75, 73.7) to (332.95, 75.3). Both block tracks, vias, pads and copper pour. The footprints rule is off, because U1's own courtyard overlaps them; pads stay blocked, so another part there still fails DRC.
- Nothing had been routed there, but the GND pours covered about 50 mm² of the band on each layer. After the refill, no pour is left inside either area.
- Checks on Tiam's PC (KiCad 10, `kicad-cli pcb drc --schematic-parity --severity-all --refill-zones`): 0 errors, 0 unconnected items, 215 warnings, 7 excluded, the same as before.

### PCB: pre-order review fixes and fab export (2026-10-26)

- Pre-order review of the mainboard, USB-C daughterboard and dongle (KiCad 10.0.7 in the official Docker image). ERC: 0 errors on all three. DRC with schematic parity: 0 errors and 0 unconnected items on all three, plus the plate. Every footprint's pads match its library copy, once back-side parts are un-mirrored, so the "footprint differs from library" warnings are text and 3D-model fields only.
- ST6 (the right Mod's stabilizer) moved 0.038 mm left, so its right-hand holes land exactly on the 6.25u stabilizer's (ST4). They were 0.038 mm apart, a near-overlap that drills a sliver and can break a bit; an exact duplicate is merged by the fab's CAM. DRC now reports "holes co-located" there instead of "hole to hole".
- Mainboard back silkscreen: `+` and `-` beside J2's pins (VBAT on pin 1), and "Dachshund70 / mainboard v1.0 2026-10 / JLCJLCJLCJLC" in a free area under the encoder (the last marks where JLCPCB prints its order number). No new DRC warnings.
- `hardware/export_fab.py` writes Gerbers and Excellon drill files (plated and non-plated separate, with drill maps) for all four boards as one zip each.
- Assembly isn't settled yet: the mainboard's BOM has no MPN or LCSC numbers, and the daughterboard (9 mm wide) is under JLCPCB's 10 mm minimum for assembly, so it needs edge rails or a panel if JLC assembles it.

### PCB: JLCPCB assembly BOM and CPL (2026-10-26)

- Tiam's choice: JLCPCB assembles everything except the key switches, hot-swap sockets included.
- Every assembled part on the three boards now has `MPN` and `LCSC` fields. Each LCSC number was checked on its jlcpcb.com part page; stock wasn't visible from here, so JLC's BOM upload is where shortages show. Not assembled: the key switches (including the soldered SW604, SW606 and SW615), stabilizers, test pads, and the display header J4 (panel not chosen yet; male pins or a socket depends on it).
- Substitutions: F1 on the daughterboard and dongle is BHFUSE BSMD1206-075-6V (C883127; 1206, 750 mA hold, 6 V), the same rating as Bourns MF-NSMF075-2, which LCSC doesn't carry. The dongle's ASMB-MTB0-0A3A2 LED has no LCSC number; its BOM row carries the MPN for JLC's global sourcing.
- PCBA type: the MDBT50Q (X-ray required) and the SK6812MINI-E are "Standard only" at JLC, so the mainboard and dongle need Standard PCBA. The encoder, J3 and the dongle's J2 are through-hole.
- `hardware/export_fab.py` now also writes `<board>-bom.csv` and `<board>-cpl.csv` for the three PCBs. The sockets' footprints are on the front with their pads on B.Cu, so the CPL puts them on the bottom at the socket centre (midpoint of the two pads, 0.62 mm left of and 3.81 mm above the switch centre).
- Rotations are KiCad's own. Check them in JLC's placement preview before paying, especially the SOT-23 parts, diodes, LEDs and the module.
- 2026-10-27: JLC had no stock of the Kailh CPG151101S11 (C2803348), so the sockets are now HanElectricity CPG151101S11-2 (C49352235, in stock). Its datasheet matches the Kailh socket and our footprint: 6.35 × 2.54 mm hole spacing, Ø3.0 holes, 2.55 × 2.5 mm pads, 14.5 × 5.89 × 1.85 mm body. The MDBT50Q (C5118826) was also out of stock, and Tiam is pre-ordering it through JLC's parts manager.
- 2026-10-27: the keyboard and dongle modules are now the MDBT50Q-P1MV2 (C5119772, about C$10.74 against C$25.71 for the -1MV2). It is the same Raytac module with a PCB trace antenna instead of a chip antenna: the same 15.5 × 10.5 mm body, the same 61 pads and the antenna at the same end, so the footprint and keep-outs are unchanged. Raytac rates its range about 20 % shorter (up to 250 m against 300+ m at 1 Mbps in open air), which a keyboard won't notice. It still needs X-ray, and it is a JLC pre-order part.

### PCB: mainboard pour pockets, stitching vias and logo (2026-10-26)

- The gaps Tiam spotted in the B.Cu pour at SW305/D305, SW400 and SW513 (and about 25 smaller ones) were pour pockets fully boxed in by tracks. The zones remove unconnected islands, so those pockets were left bare. Each pocket big enough for a via now has a GND via, so it fills like the others. A few pockets near the MCU are too small for a via and stay bare.
- The ~600 scattered GND stitching vias were replaced by about 200 on a regular 9.525 mm (half-key) grid, placed only where both pours are clear. There are also a few extra vias in the pockets above and two that tie the pour pieces around the MCU to the main pour. This removed the 35 old copper-to-edge warnings. DRC otherwise matches main: no errors, nothing unconnected.
- Stabilizer holes were checked for both spacebar layouts. The 6.25u (ST4) is centred on SW606. The split layout is 1.25u SW604 (no stab), 2.75u SW615 on ST5 and 2.25u SW608 on ST6, and ST6 shares its right holes with ST4. The plate's cutouts come from the same footprints.
- Back silkscreen logo "Doghouse Boards" (Fredoka Bold, SIL OFL) and "Dachshund70  Rev 1.0" (URW Gothic). It is in the band between the first two rows, as filled polygons in the group "Doghouse Boards logo", so the look doesn't depend on fonts installed on the PC.
- JLC's quote page didn't read the board size or layers from the first mainboard zip. `export_fab.py` now follows JLC's KiCad guide: no X2 or netlist attributes, no drill maps or job file, decimal Excellon, and the plate's empty drill files left out. Not yet confirmed on JLC's site.

### Licence (2026-10-23)

- Code (firmware, host-lib, Doghouse, protocol, scripts): MIT, in `LICENSE`. host-lib and Doghouse carry `"license": "MIT"`.
- Hardware (`hardware/`: the three PCBs and the plate): CERN-OHL-P-2.0, in `hardware/LICENSE`.
- Third-party files keep their own licences: the vendored keyswitch footprints are CC-BY-SA-4.0 (see `hardware/Dachshund70/lib/README.md`), and the UF2 bootloader build fetches Adafruit's MIT-licensed source.

## Tested

- host-lib `npm test`: passes locally (Node 24.12, Windows), including board and devicetree validation.
- Core C tests (core, hold, screen, version): pass in CI. Not run locally; there's no C compiler or CMake here.
- Firmware builds: debug and release for `dachshund70/nrf52840` with no screen and with each of the four panels, and the dongle, pass in CI (NCS v3.4.1, Zephyr 4.4.2), run 39862064737. Not built locally; NCS isn't installed here.
- Bring-up plan for all three boards (inspection, power, flashing, functional tests and measurements with methods and equipment): `docs/bringup-test-plan.md` (2026-10-23).
- UF2 bootloader: builds cleanly (`-Werror`) on Linux with arm-none-eabi-gcc 13.2.1. The merged hex puts the SoftDevice at 0x1000–0x25DE8, the bootloader at 0xF4000–0xFC3AC, and the UICR words at 0x10001014/18. Not yet run on a chip.
- Core C tests for phase 3 (debounce, engine, keycodes, keymap): pass locally on Linux with GCC, also under ASan and UBSan.
- Phase 4: all core tests (including `test_hid` and `test_indicators`) pass on Linux with GCC, also under ASan and UBSan. The firmware builds locally (NCS v3.4.1, Zephyr SDK 1.0.1) in debug, and in release with the 128×32 OLED, with no new warnings. host-lib (57 tests) and Doghouse (check, 14 tests, build) pass.
- Phase 5: core tests (12, including `test_protocol` and `test_protocol_fuzz`) pass locally with GCC under ASan and UBSan; the libFuzzer target runs only in CI (the local clang has no compiler-rt). The firmware builds locally with no new warnings. host-lib (62 tests) passes.
- Phase 6: core tests (14, including `test_store` and `test_settings`) pass locally with GCC under ASan and UBSan. The firmware builds locally with no new warnings.
- Phase 7: host-lib 90 tests pass locally (Node 24), including the round trip against `kb_host_device`. Doghouse still checks, tests and builds.
- Phase 8: Doghouse checks, tests (14) and builds. Checked by hand in headless Chromium against the host-built firmware through a stand-in `navigator.hid`: the board appears with its keymap, a key change shows as unsaved, Save works and survives a page reload, Identify works, and the settings and About tabs show what the firmware supports. A stand-in board on protocol v2 shows the update message. Demo mode and the no-WebHID message checked the same way. host-lib 91 tests pass.
- Phase 9c: host-lib 104 tests pass with `KB_HOST_DEVICE` (the advanced-key and macro checks run against both the mock and the host-built firmware and agree). Doghouse checks, tests (14) and builds. Checked by hand in headless Chromium in demo mode: adding a combo, a tap dance and a macro works, unsaved changes show, and the browser console is clean.
- Phase 14: core (20), host-lib (131) and Doghouse (check, 14 tests, build) pass locally. The keyboard firmware (debug and release) and the dongle firmware (debug and release) build locally with no new warnings. The Connection tab's dongle card checked by eye in headless Chromium in demo mode.
- Real hardware: nothing yet. Phase 9 is to be checked on a board: a combo, a tap dance, a key override, a Leader sequence and a macro each typed for real, the encoder turning volume, and mouse keys moving the pointer.
- Phase 8 is to be checked on a board: Connect a board… in Chrome and Edge on Windows, the board coming back after unplugging and replugging, a key change typed for real after saving and power-cycling, and Restart into bootloader mounting the UF2 drive.
- Phase 7 is to be checked on a board: WebHID in Chrome or Edge finds the board after picking it once and follows unplugging; node-hid finds it on Windows (by usage page) and on Linux (by interface number, with a udev rule for hidraw access); the handshake, keymap read and a key change work over both.
- Phase 6 is to be checked on a board: a saved keymap survives unplugging, revert and factory reset work, and a save cut short by unplugging leaves the previous settings.
- Phase 5 is to be checked on a board: `lsusb -v` shows the vendor interface, and the handshake, `get_serial` and `identify` work once host-lib can talk to it (phase 7).
- Phase 4 is to be checked on a board:
  - `lsusb -v`: two HID interfaces, the first with the boot keyboard subclass, the second with report IDs 1–3; both endpoints at bInterval 1; remote wakeup set in bmAttributes
  - seven or more keys held at once all reach the host; Fn+N switches to 6KRO and back
  - in a BIOS setup screen or through a KVM, keys work (boot protocol), and NKRO comes back in the OS
  - media, volume and brightness keys on the Fn layer work
  - the Caps LED follows Caps Lock, the layer LED turns amber on Fn, and LED_VDD drops to 0 V when every LED is dark
  - sleep the host, press a key: the host wakes, and nothing sticks afterwards
- Phase 3 is to be checked on a board:
  - every key types what the README matrix table says, with no ghosting when three keys in a rectangle are held
  - Fn layer: media keys, Insert, Print Screen, Page Up/Down, Home/End; the status screen shows the layer
  - Fn+Esc mounts the UF2 drive at once; holding Esc for 3 s still does
  - scan rate is 1 kHz and a scan takes well under 1 ms (toggle a spare GPIO and use a logic analyser)
  - no chatter with the default debounce (eager press, 5 ms deferred release); try other algorithms through Kconfig if needed
- Phase 2 is still to be checked on a board:
  - flash `dachshund70_bootloader_s140_6.1.1.hex` over SWD with a chip erase; check the DACHSHUND drive appears and `INFO_UF2.TXT` says `nRF52840-Dachshund70-v1`; then copy `zephyr.uf2`
  - check that it enumerates as 1209:0001 with a unique serial number (USB Device Tree Viewer or `lsusb -v`)
  - check that it works as a boot keyboard in the BIOS
  - check that the LEDs walk once in chain order with correct colours at power-up
  - check that holding Esc for 3 s mounts the UF2 drive, and that holding Esc while plugging in does too
  - check the SK6812s show the bootloader colours (its WS2812 timing is slightly long for the SK6812 spec: a 0.81 µs high bit against 0.75 µs at most)
  - check that REGOUT0 reads 3.3 V
  - for the chosen panel: check that the screen shows layer, battery and text, that Caps/Num/Scroll follow the host, that "USB" appears once enumerated, and that the orientation is right in the case
- USB-C daughterboard: not built. On first boards, check:
  - VBUS reaches mainboard J1 pin 1 with a 1:1 cable
  - the board enumerates through it with both plug orientations
  - a USB-C to USB-C cable from a charger supplies 5 V (the Rd pull-downs work)
  - the shell and both screw holes read close to 0 Ω to GND (through FB1), and D+/D− read open to the shell
- 2.4 GHz dongle board: not built. On first boards, check:
  - VBUS reaches 5 V; VDD reads 1.8 V on a blank module and 3.3 V once firmware sets REGOUT0
  - SWD flashing works, and whether Adafruit's `pca10059` UF2 bootloader runs (hold PAIR while plugging in)
  - it enumerates as 1209:0002 in both plug orientations and from a USB-C to USB-C cable
  - the LED shows red, green and blue; PAIR and RESET work
  - in phase 14: range, and latency with a logic analyser, with the puck next to the keyboard and then plugged straight into a USB 3 port

## Open decisions

- Registered pid.codes PID before distributing boards; the licence is now set (MIT and CERN-OHL-P), so this needs only a public repo
- PCB design: the pin map is proposed and must be confirmed (or edited) once the schematic is routed
- Roller size: 12 mm across fits over the PCB as it is; a 20 mm roller would need a slot in the mainboard under it (the board is ordered, so that's Rev 2). The case is open over the roller either way.
- When to add the Tauri shell (needs Rust and the MSVC build tools); WebHID stays possible for a hosted version
- Display panel: OLED (which size) or e-paper; also its orientation in the case, since the overlays assume the panel's default rotation
- Dongle case: it sets the M2 hole positions, the light pipe over D1 and the button caps. Use plastic, with nothing metal over the antenna strip.
- Dongle bootloader: reuse Adafruit's `pca10059` build or make a dongle-specific one. The DFU button matches (P1.06), but that build's LEDs are P0.06 and P0.12, so only the blue LED would light on this dongle. A dongle board can reuse the files in `boards/Dachshund70/bootloader/` as a template. Try the existing build on the first board.

## Known bugs

- The 2.4 GHz link isn't encrypted: keystrokes over the dongle can be read by anyone nearby with an nRF52 and the address. Encryption is a scheduled task.
- (Superseded on 2026-10-28: this got Bourns' naming backwards; the part is PEC12R-2220F-S0024.) Encoder part number checked against Bourns' PEC12R datasheet (2026-10-23): the BOM's PEC12R-4220F-S0024 is right. The first digit of the ordering code is the mounting: 2 = vertical (radial pins, shaft up from the board), 3 = horizontal with a threaded bushing, 4 = horizontal without a bushing. So -4220F-S0024 is horizontal, no bushing, 24 detents, 20 mm shaft, push switch, 24 pulses, and Mouser lists it as right angle. Don't order PEC12R-2217F-S0024: it is the vertical part. KiCad's footprint name `Horizontal_PEC12R-2x17F` uses the wrong series digit; its geometry is the horizontal part's. Still open: SW3's 3D model is a stand-in (see `hardware/3dmodels/README.md`), and the footprint's hole pattern hasn't been checked dimension by dimension against the 4xxx drawing.
- Release builds print Kconfig warnings, because `prj.conf` sets logging options that `release.conf` turns off. PRINTK also stays on in release, since something selects it; nothing prints, because no console or RTT backend exists. This is harmless, but the warnings are noise.
- E-paper builds warn that Zephyr's MIPI-DBI driver is "experimental". It is what Zephyr's own e-paper shields use; this is a notice, not a fault.
- Doghouse's palette has no layer-tap, mod-tap, one-shot mod, default-layer or modded keys yet, though the firmware supports them. Add them with the phase 9 editors.
- The matrix is scanned at 1 kHz all the time, which costs battery. Phase 13 adds idle scanning with GPIO sense wake-up.
- In boot protocol (BIOS, KVM) or with NKRO off, a seventh held key is dropped from the 6-key report rather than sending the ErrorRollOver code.
- A host that reads the boot report without ever sending SET_PROTOCOL (a few BIOSes and KVMs) sees no keys while NKRO is on, because keys then go to the NKRO interface. Fn+N switches to 6KRO for such hosts.
- Doghouse doesn't yet show key labels in the user's OS keyboard layout (AZERTY and so on), edit the status screen layout, or update firmware. The SPEC lists these for later phases.
- An OLED left on all the time can burn in. It gets an idle timeout with power management in phase 13.
