TiamDesigns/Dachshund70/hardware/case/dxf/Dachshund70-Weight-Engraving.dxf

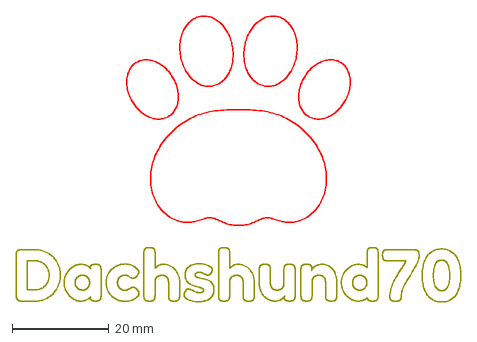
[picture p2: CAD file, 2026-11-10]
hardware/case/dxf/Dachshund70-Weight-Engraving.dxf
91.8 x 59.0 mm
