TiamDesigns/Dachshund70/hardware/Dachshund70-Plate/Dachshund70-Plate-outline.dxf

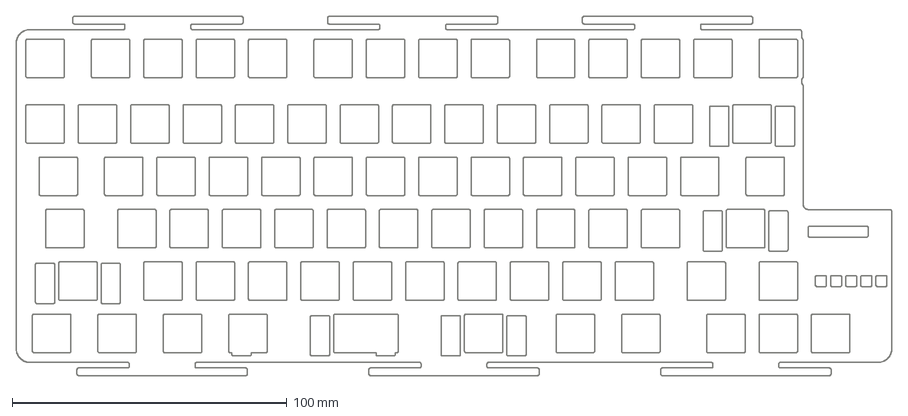
[picture p4: CAD file, 2026-11-10]
hardware/Dachshund70-Plate/Dachshund70-Plate-outline.dxf
318.5 x 130.7 mm
