TiamDesigns/Dachshund70/hardware/case/step/Dachshund70-Case-Weight.step

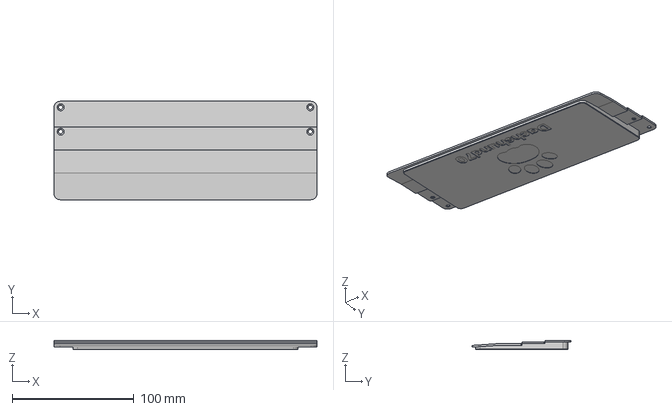
[picture p5: CAD file, 2026-11-10]
hardware/case/step/Dachshund70-Case-Weight.step
216.0 x 80.9 x 7.74 mm
