TiamDesigns/Dachshund70/hardware/step/Dachshund70-Plate.step

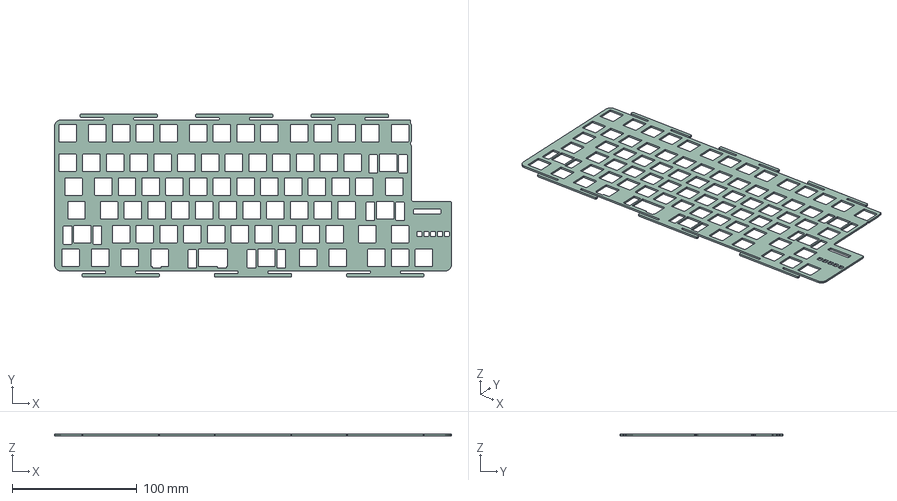
[picture p6: CAD file, 2026-11-10]
hardware/step/Dachshund70-Plate.step
318.5 x 130.7 x 1.51 mm
