TiamDesigns/Dachshund70/hardware/case/step/Dachshund70-Case-Encoder-Cover.step

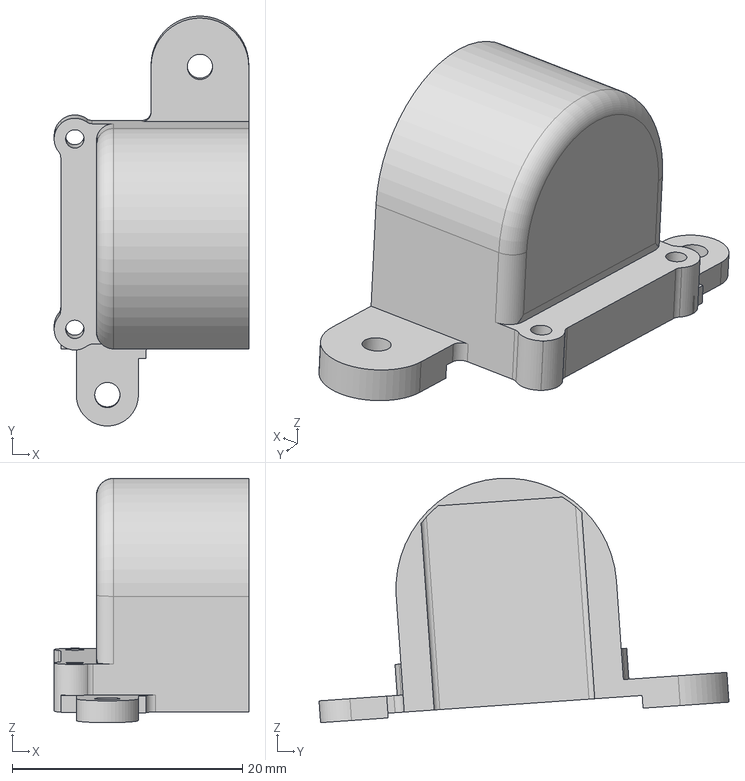
[picture p7: CAD file, 2026-11-10]
hardware/case/step/Dachshund70-Case-Encoder-Cover.step
16.9 x 35.6 x 21.2 mm
