TiamDesigns/Dachshund70/hardware/step/Dachshund70.step

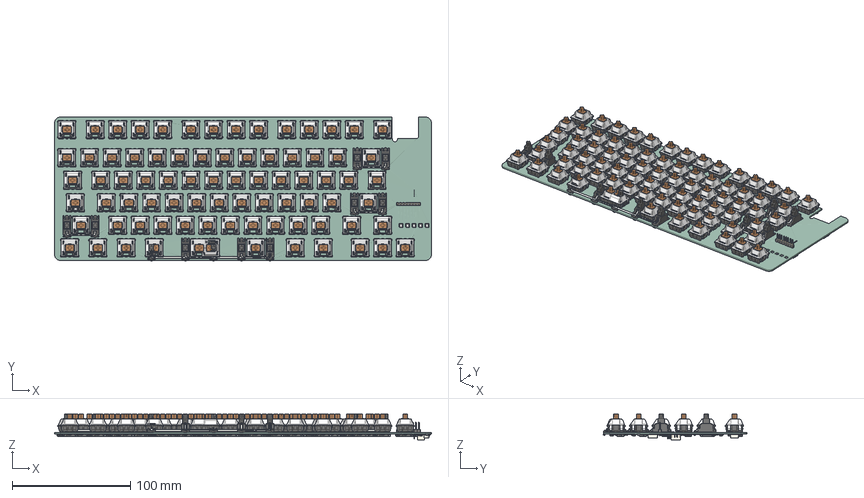
[picture p8: CAD file, 2026-11-10]
hardware/step/Dachshund70.step
318.5 x 121.5 x 21.9 mm
SW_Hotswap_Kailh_cp x 77
SW_Cherry_MX_PCB_cp x 77
PinHeader_1x08_P254mm_Vertical
Stabilizer_Cherry_MX_2u_cp x 5
SW_Cherry_MX_Plate_cp x 3
Stabilizer_Cherry_MX_6_25u_cp
D_SOD-123 x 81
SOT-23
PinHeader_1x05_P127mm_Vertical
C_0402_1005Metric x 14
C_0603_1608Metric x 5
JST_SH_SM05B-SRSS-TB_1x05-1MP_P1.00mm_Horizontal
SW_SPST_TL3342
Pin1 x 6
Pin2 x 6
Pin3 x 6
Pin4 x 6
D_SOD-323
R_0603_1608Metric x 2
Crystal_SMD_3215-2Pin_3.2x1.5mm
SOT-23-6
JST_SH_SM06B-SRSS-TB_1x06-1MP_P1.00mm_Horizontal
SOT-23-5 x 2
JST S2B-PH-SM4-TB
Raytac_MDBT50Q
R_0402_1005Metric
Dachshund70_PCB
