TiamDesigns/Dachshund70/hardware/case/step/Dachshund70-Case-LED-Guide.step

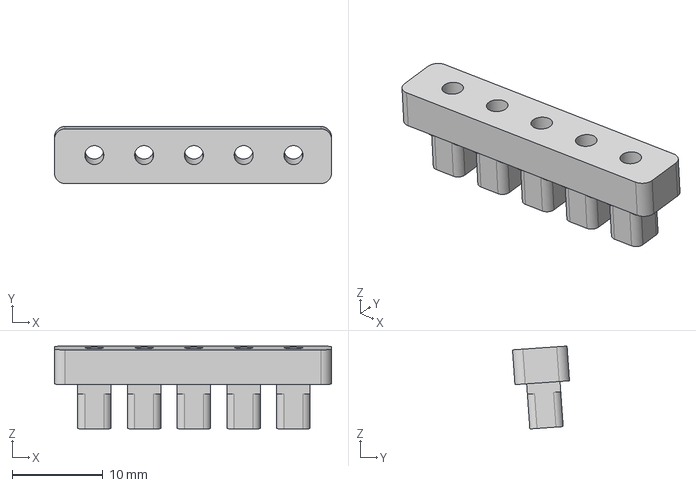
[picture p9: CAD file, 2026-11-10]
hardware/case/step/Dachshund70-Case-LED-Guide.step
30.6 x 6.30 x 9.16 mm
