TiamDesigns/Dachshund70/hardware/step/Dachshund70-Dongle.step

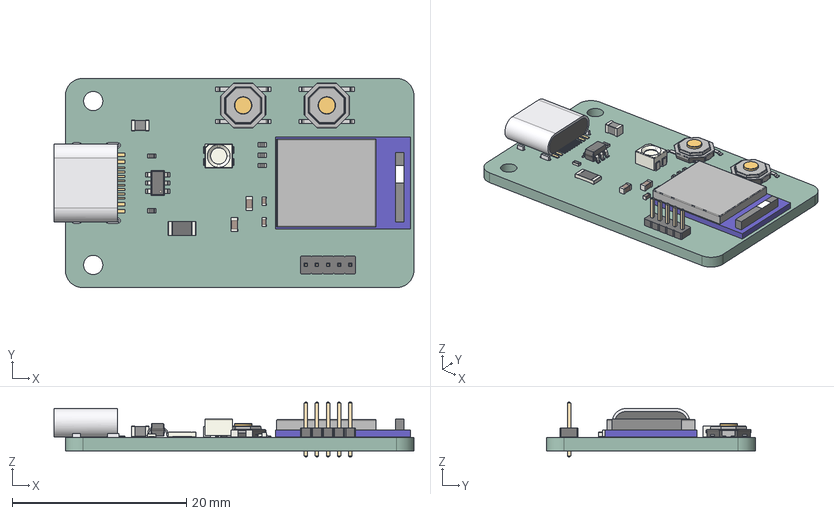
[picture p10: CAD file, 2026-11-10]
hardware/step/Dachshund70-Dongle.step
41.3 x 24.0 x 6.30 mm
R_0402_1005Metric x 5
SW_SPST_TL3342 x 2
C_0603_1608Metric x 2
L_0805_2012Metric
C_0402_1005Metric x 2
Fuse_1206_3216Metric
LED_RGB_Wuerth-PLCC4_3.2x2.8mm_150141M173100
PinHeader_1x05_P127mm_Vertical
Raytac_MDBT50Q
HRO TYPE-C-31-M-12
SOT-23-6
Dachshund70-Dongle_PCB
