TiamDesigns/Dachshund70/hardware/case/step/Dachshund70-Case-Knob.step

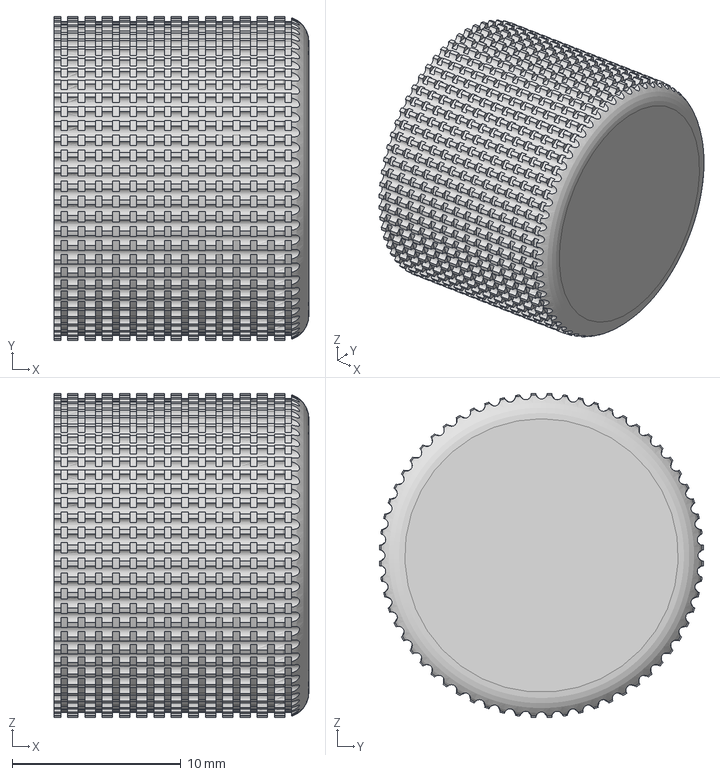
[picture p11: CAD file, 2026-11-10]
hardware/case/step/Dachshund70-Case-Knob.step
15.1 x 19.2 x 19.2 mm
