TiamDesigns/Dachshund70/hardware/case/step/Dachshund70-Case-Ring.step

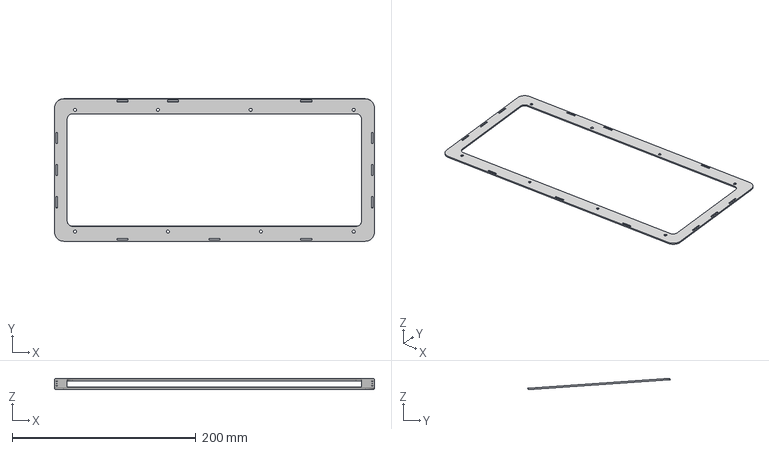
[picture p13: CAD file, 2026-11-10]
hardware/case/step/Dachshund70-Case-Ring.step
347.9 x 154.9 x 12.4 mm
