TiamDesigns/Dachshund70/hardware/case/step/Dachshund70-Case-Slider-Button.step

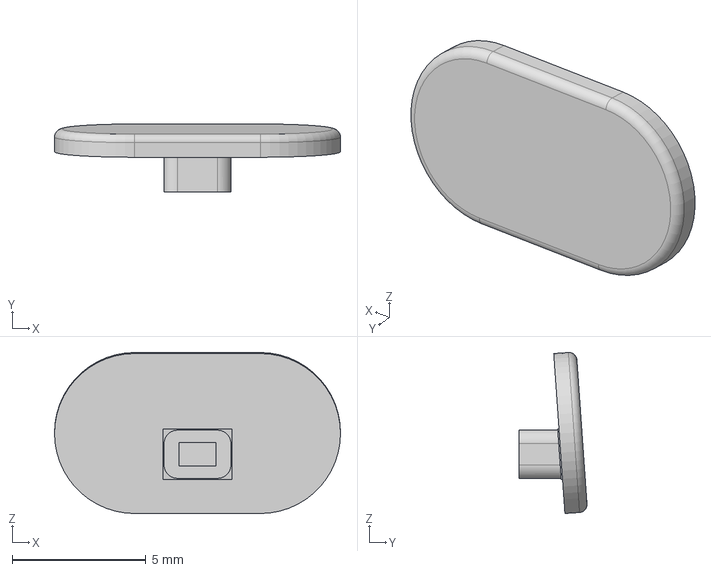
[picture p15: CAD file, 2026-11-10]
hardware/case/step/Dachshund70-Case-Slider-Button.step
10.7 x 2.55 x 6.02 mm
