TiamDesigns/Dachshund70/hardware/case/step/Dachshund70-Case-Gasket-Retainer.step

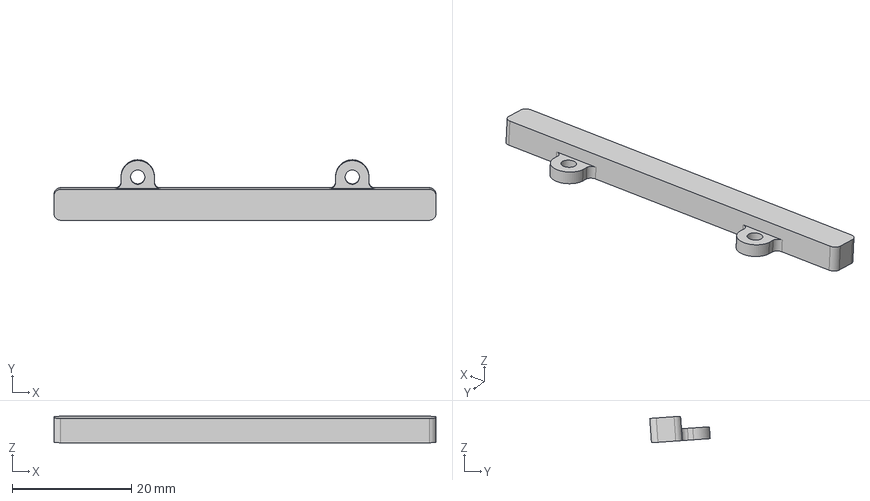
[picture p18: CAD file, 2026-11-10]
hardware/case/step/Dachshund70-Case-Gasket-Retainer.step
64.1 x 10.2 x 4.45 mm
