TiamDesigns/Dachshund70/(list of files, cad)

Other CAD files:
hardware/case/step/Dachshund70-Case-Assembly.step
hardware/case/step/Dachshund70-Keycaps-6.25u.step
hardware/case/dxf/Dachshund70-Case-Ring.dxf
hardware/case/fusion/Dachshund70-Case-rev2.f3d
