TiamDesigns/Dachshund70/hardware/Dachshund70-Screen/Dachshund70-Screen.kicad_pcb

## KiCad design hardware/Dachshund70-Screen/Dachshund70-Screen.kicad_pcb (2026-11-11)

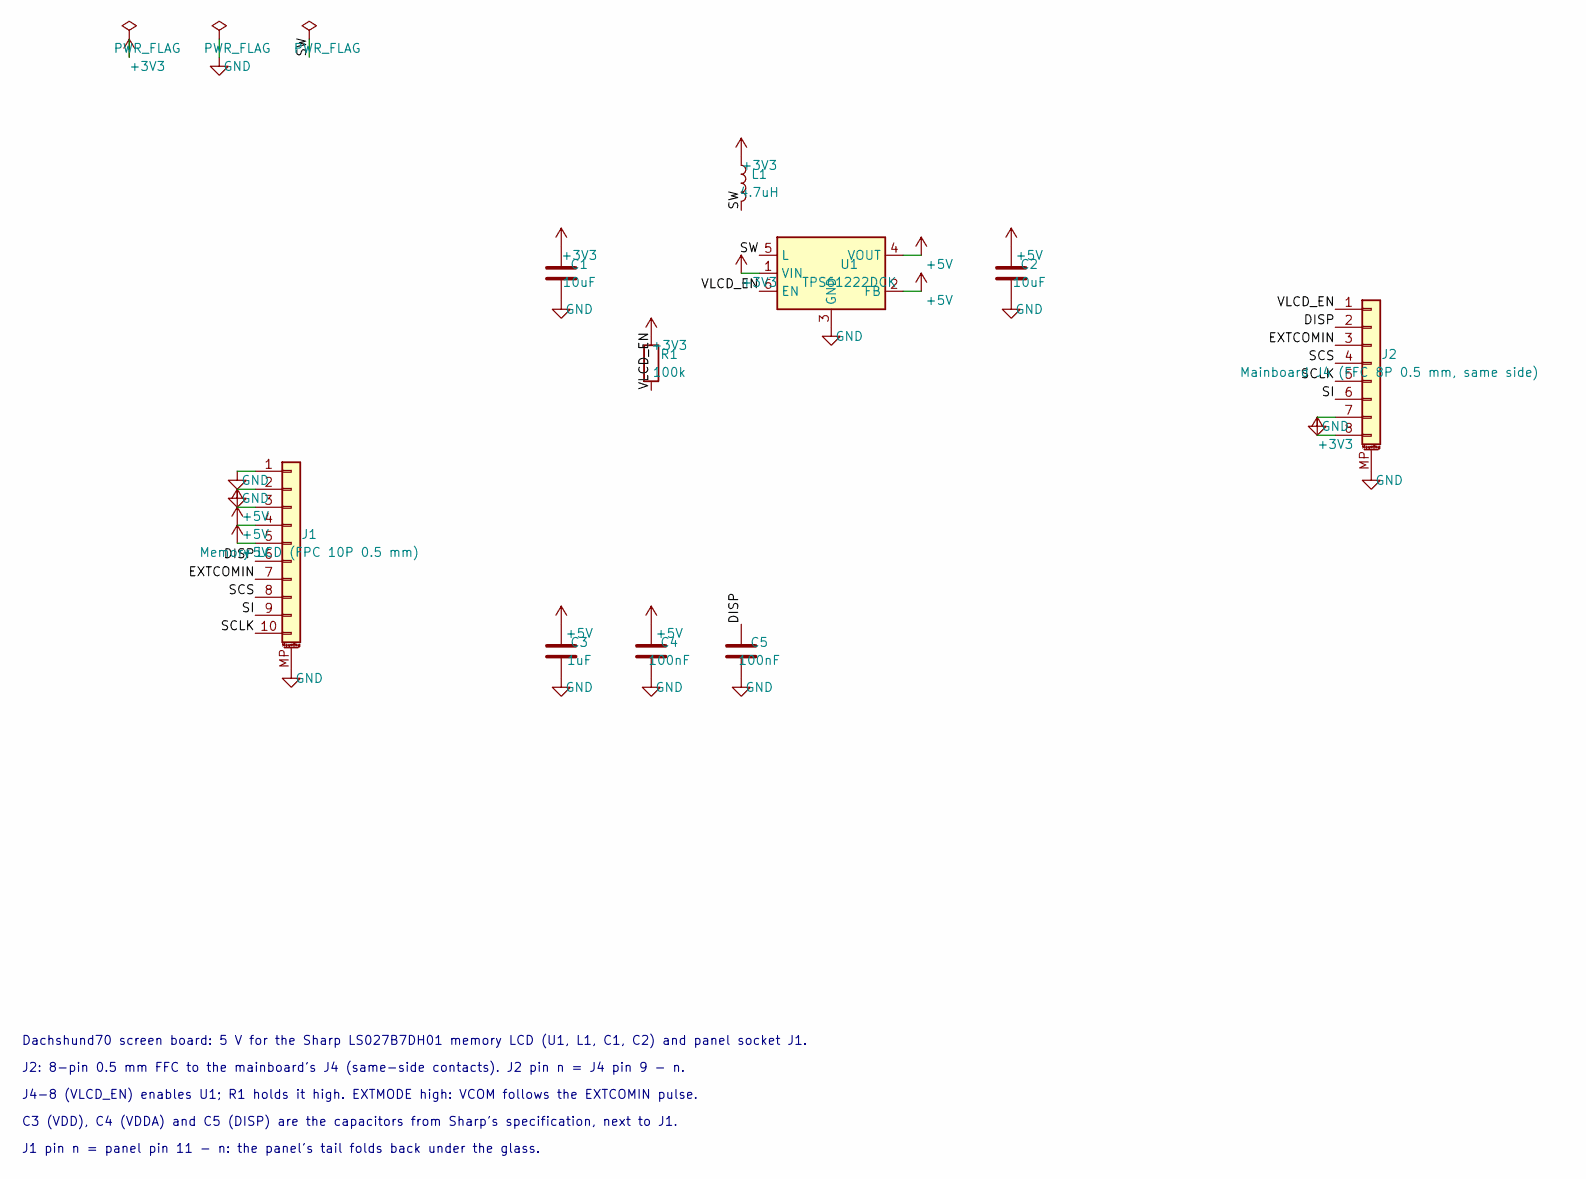
[picture p19: schematic Dachshund70-Screen.kicad_sch, Dachshund70 screen board]

Parts:
C1, C2: 10uF; C_0603_1608Metric; MPN Samsung CL10A106KP8NNNC (10 uF, 10 V, X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; LCSC C19702
C3: 1uF; C_0402_1005Metric; MPN Samsung CL05A105KA5NQNC (1 uF, 25 V, X5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; LCSC C52923
C4, C5: 100nF; C_0402_1005Metric; MPN Samsung CL05B104KO5NNNC; LCSC C1525
J1: Memory LCD (FPC 10P 0.5 mm); Hirose_FH12-10S-0.5SH_1x10-1MP_P0.50mm_Horizontal; MPN Hirose FH12-10S-0.5SH(55)
J2: Mainboard J4 (FFC 8P 0.5 mm, same side); Hirose_FH12-8S-0.5SH_1x08-1MP_P0.50mm_Horizontal; MPN Hirose FH12-8S-0.5SH(55)
L1: 4.7uH; L_Changjiang_FNR3015S; MPN Changjiang FNR3015S4R7MT (4.7 uH, 3 x 3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
R1: 100k; R_0402_1005Metric; MPN UNI-ROYAL 0402WGF1003TCE; LCSC C25741
U1: TPS61222DCK; SOT-363_SC-70-6; MPN TI TPS61222DCKR (5 V boost)

Connections:
+3V3: C1.1, J2.8, L1.1, R1.1, U1.1 (VIN)
+5V: C2.1, C3.1, C4.1, J1.3, J1.4, J1.5, U1.2 (FB), U1.4 (VOUT)
/DISP: C5.1, J1.6, J2.2
/EXTCOMIN: J1.7, J2.3
/SCLK: J1.10, J2.5
/SCS: J1.8, J2.4
/SI: J1.9, J2.6
/SW: L1.2, U1.5 (L)
/VLCD_EN: J2.1, R1.2, U1.6 (EN)
GND: C1.2, C2.2, C3.2, C4.2, C5.2, J1.1, J1.2, J1.MP (MountPin), J2.7, J2.MP (MountPin), U1.3 (GND)

Notes on the sheet:
Dachshund70 screen board: 5 V for the Sharp LS027B7DH01 memory LCD (U1, L1, C1, C2) and panel socket J1.
J2: 8-pin 0.5 mm FFC to the mainboard's J4 (same-side contacts). J2 pin n = J4 pin 9 - n.
J4-8 (VLCD_EN) enables U1; R1 holds it high. EXTMODE high: VCOM follows the EXTCOMIN pulse.
C3 (VDD), C4 (VDDA) and C5 (DISP) are the capacitors from Sharp's specification, next to J1.
J1 pin n = panel pin 11 - n: the panel's tail folds back under the glass.

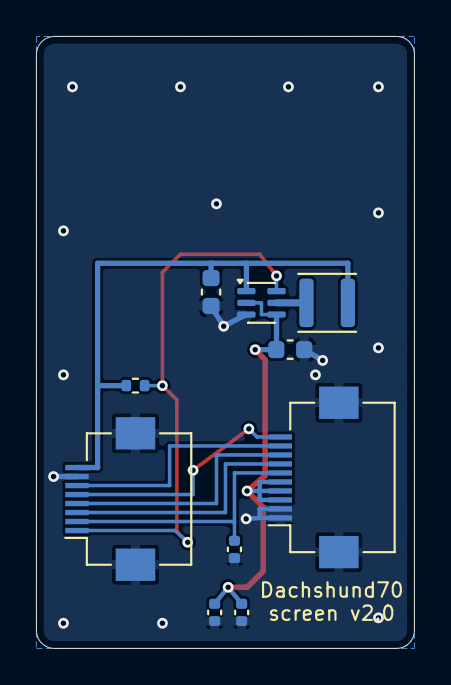
[picture p20: board Dachshund70-Screen.kicad_pcb from below]

Board: 2 copper layers, 21.0 x 34.0 mm, 10 parts (10 on the bottom side), 10 nets.
