TiamDesigns/Dachshund70/hardware/Dachshund70-Encoder/Dachshund70-Encoder.kicad_pcb

## KiCad design hardware/Dachshund70-Encoder/Dachshund70-Encoder.kicad_pcb (2026-11-10)

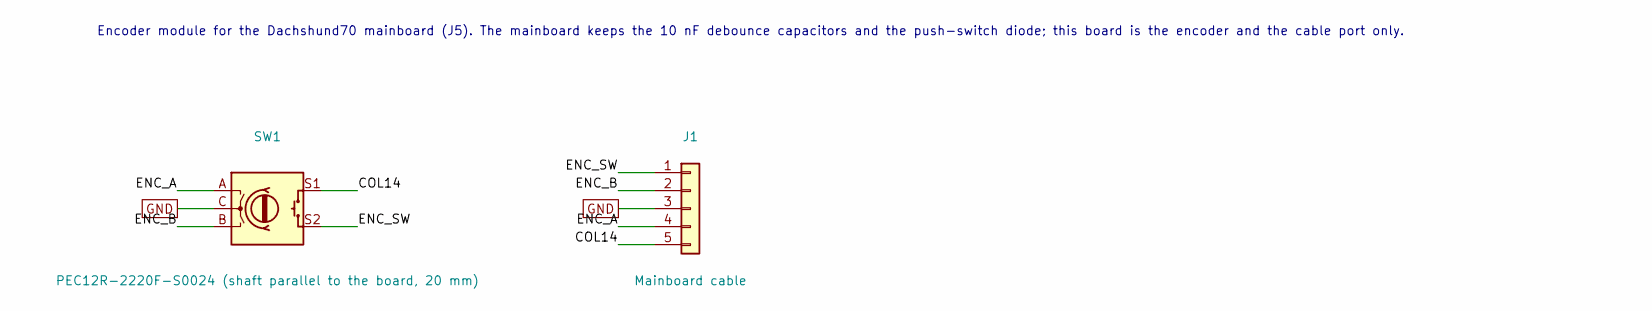
[picture p25: schematic Dachshund70-Encoder.kicad_sch, Dachshund70 encoder module]

Parts:
J1: Mainboard cable; JST_SH_SM05B-SRSS-TB_1x05-1MP_P1.00mm_Horizontal; MPN JST SM05B-SRSS-TB
SW1: PEC12R-2220F-S0024 (shaft parallel to the board, 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; RotaryEncoder_Bourns_Horizontal_PEC12R-2x17F-Sxxxx; MPN Bourns PEC12R-2220F-S0024; LCSC C49673168

Connections:
/COL14: J1.5, SW1.S1
/ENC_A: J1.4, SW1.A
/ENC_B: J1.2, SW1.B
/ENC_SW: J1.1, SW1.S2
GND: J1.3, SW1.C

Notes on the sheet:
Encoder module for the Dachshund70 mainboard (J5). The mainboard keeps the 10 nF debounce capacitors and the push-switch diode; this board is the encoder and the cable port only.

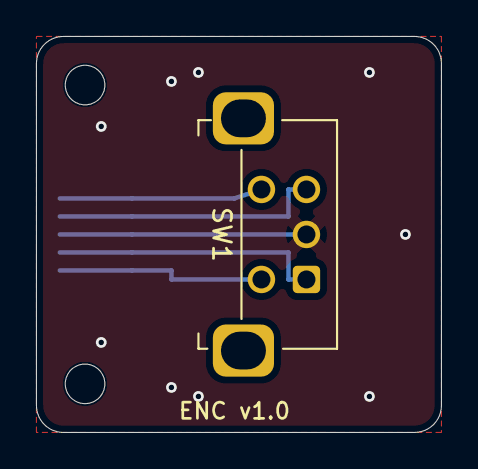
[picture p26: board Dachshund70-Encoder.kicad_pcb from above]

Board: 2 copper layers, 22.5 x 22.0 mm, 4 parts (1 on the bottom side), 5 nets.

Other parts of the board:
H1, H2: MountingHole_2.2mm_M2
