TiamDesigns/Dachshund70/hardware/Dachshund70-Dongle/Dachshund70-Dongle.kicad_pcb

## KiCad design hardware/Dachshund70-Dongle/Dachshund70-Dongle.kicad_pcb (2026-11-09)

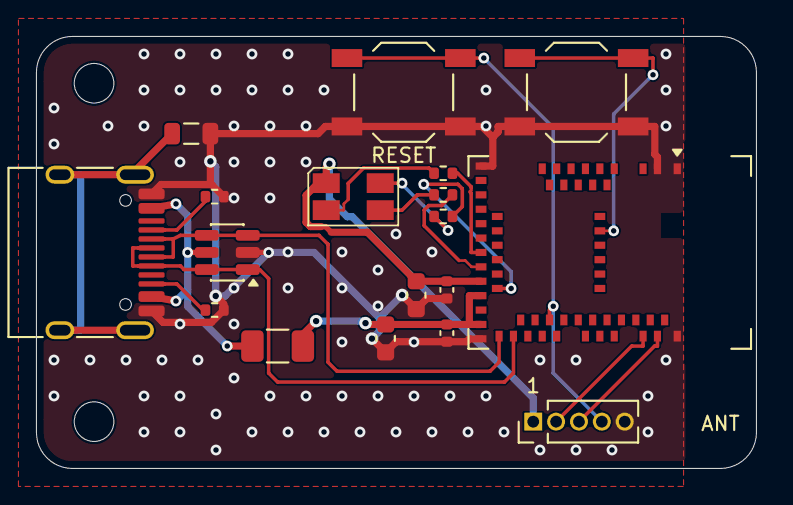
[picture p27: board Dachshund70-Dongle.kicad_pcb from above]

Board: 2 copper layers, 40.0 x 24.0 mm, 20 parts (0 on the bottom side), 19 nets.

Parts:
C1, C3: 4.7uF; C_0603_1608Metric
C2, C4: 100nF; C_0402_1005Metric
D1: ASMB-MTB0-0A3A2; LED_Avago_PLCC4_3.2x2.8mm_CW
F1: PTC 750mA hold; Fuse_1206_3216Metric
FB1: 600R@100MHz; L_0805_2012Metric
H1, H2: M2; MountingHole_2.2mm_M2
J1: USB-C (HRO TYPE-C-31-M-12); USB_C_Receptacle_HRO_TYPE-C-31-M-12
J2: SWD; PinHeader_1x05_P1.27mm_Vertical
R1, R2: 5.1k; R_0402_1005Metric
R3: 1k; R_0402_1005Metric
R4, R5: 330; R_0402_1005Metric
SW1: Pair; SW_SPST_TL3342
SW2: Reset; SW_SPST_TL3342
U1: USBLC6-2SC6; SOT-23-6
U2: MDBT50Q-P1MV2; Raytac_MDBT50Q

Connections:
/+3V3: C3.1, C4.1, D1.1, J2.1, U2.28
/CC1: J1.A5, R1.1
/CC2: J1.B5, R2.1
/D+: J1.A6, J1.B6, U1.1, U1.6, U2.35
/D-: J1.A7, J1.B7, U1.3, U1.4, U2.34
/LED_B: R5.2, U2.29
/LED_BK: D1.2, R5.1
/LED_G: R4.2, U2.26
/LED_GK: D1.3, R4.1
/LED_R: R3.2, U2.24
/LED_RK: D1.4, R3.1
/NRESET: J2.4, SW2.1, U2.40
/PAIR: SW1.1, U2.57
/SHIELD: FB1.1, J1.SH
/SWDCLK: J2.3, U2.53
/SWDIO: J2.2, U2.51
/VBUS: C1.1, C2.1, F1.2, U2.30, U2.32
/VBUS_RAW: F1.1, J1.A4, J1.A9, J1.B4, J1.B9, U1.5
GND: C1.2, C2.2, C3.2, C4.2, FB1.2, J1.A1, J1.A12, J1.B1, J1.B12, J2.5, R1.2, R2.2, SW1.2, SW2.2, U1.2, U2.1, U2.2, U2.15, U2.33, U2.55
