TiamDesigns/Dachshund70/hardware/Dachshund70-USB/Dachshund70-USB.kicad_pcb

## KiCad design hardware/Dachshund70-USB/Dachshund70-USB.kicad_pcb (2026-11-09)

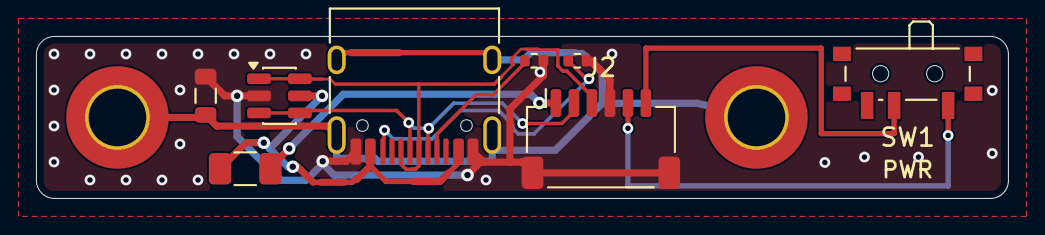
[picture p28: board Dachshund70-USB.kicad_pcb from above]

Board: 2 copper layers, 54.0 x 9.0 mm, 10 parts (0 on the bottom side), 10 nets.

Parts:
F1: PTC 750mA hold; Fuse_1206_3216Metric
FB1: 600R@100MHz; L_0805_2012Metric
H1, H2: M3; MountingHole_3.2mm_M3_ISO7380_Pad_TopBottom
J1: USB-C (HRO TYPE-C-31-M-12); USB_C_Receptacle_HRO_TYPE-C-31-M-12
J2: Mainboard (JST-SH 6P); JST_SH_SM06B-SRSS-TB_1x06-1MP_P1.00mm_Horizontal
R1, R2: 5.1k; R_0402_1005Metric
SW1: Power; SW_SPDT_PCM12
U1: USBLC6-2SC6; SOT-23-6

Connections:
/CC1: J1.A5, R1.1
/CC2: J1.B5, R2.1
/D+: J1.A6, J1.B6, J2.3, U1.1, U1.6
/D-: J1.A7, J1.B7, J2.2, U1.3, U1.4
/SHIELD: FB1.1, H1.1, H2.1, J1.SH
/VBAT: J2.5, SW1.1
/VBAT_SW: J2.6, SW1.2
/VBUS: F1.2, J2.1
/VBUS_RAW: F1.1, J1.A4, J1.A9, J1.B4, J1.B9, U1.5
GND: FB1.2, J1.A1, J1.A12, J1.B1, J1.B12, J2.4, J2.MP, R1.2, R2.2, U1.2
