TiamDesigns/Dachshund70/(commit log)

2026-11-09 PCBs: DRC/ERC pass; J5 mounting pads on GND in the schematic, footprint fields synced, spacebar and edge-silk waivers
    Claude-Session: https://claude.ai/code/session_01NfZpEZLXDjivYyMpNVDqpR
    [Dachshund70-Dongle.kicad_pcb, Dachshund70-Encoder.kicad_pcb, Dachshund70-USB.kicad_pcb, Dachshund70.kicad_pcb, Dachshund70.kicad_sch]
2026-11-09 Power path: ngspice simulation; R3 (Q1 gate pull-down) 100k -> 10k
    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
    [Dachshund70.kicad_pcb, Dachshund70.kicad_sch]
2026-11-09 Case: fix the v33 review (retainers, encoder mount, light guide, weight, machinability)
    - Gasket pockets open from below; six identical 6061 gasket retainers (44.1 x 4.55 x 4.1)
    form the sock/nub floor, clamped by the ring.
    - E-paper glass and driver board drop in from below (29.8 x 59.8 R1.0 opening); 0.3 land
    under the window's 45 deg frame.
    - Encoder: module posts removed; the module screws to the cover's foot (2 x M2) and the
    cover screws into the top block through a rear ear (2 x M2 x 6). Cover profile 19.2 wide
    with R7 top corners (1 mm walls over the PEC12R body), R0.6 ear pockets, 0.15 to knob/plate.
    - LED guide redesigned: straight 2.3 channels through 3.7 spigots in the pla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
    [Dachshund70-Case-Assembly.step, Dachshund70-Case-Bottom.step, Dachshund70-Case-Encoder-Cover.step, Dachshund70-Case-Gasket-Retainer.step, Dachshund70-Case-Knob.step, Dachshund70-Case-LED-Guide.step, Dachshund70-Case-Ring.dxf, Dachshund70-Case-Ring.step]
2026-11-09 Case: open the back-right screw boss over the battery bay; R1.0 where the sidebar hollow meets the cavity's back wall
    The boss's overhang over the bay is cut away vertically along the bay's own
    outline (R3/R5.75) up to the ring, so the bay is open from above with no lip.
    Re-exported the bottom block, the assembly and the f3d.
    [Dachshund70-Case-Assembly.step, Dachshund70-Case-Bottom.step, Dachshund70-Case-rev2.f3d]
2026-11-10 Case round 2: M2-screwed gasket retainers, simpler encoder cover with an M3 each side, 76.1 mm weight; plate notch for the cover
    - Gasket retainers: two ears each (R2.8, 2.0 thick, at +-18.0), M2 x 8 countersunk (DIN 965) flush with
    the underside into M2 taps in the top block (5.9 of thread, drilled to the tip + 2); all six identical.
    - Encoder cover v35: a Dia 19.2 dome on the knob's axis that just encloses the PEC12R (0.21 over the
    body's top corners, accepted), a foot for the module's two M2 screws, and one M3 x 8 countersunk each
    side into the top block (front boss through the plate notch, back-wall pocket), 5.4 of thread. The top
    block's opening follows the shorter dome; the old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
    [Dachshund70-Assembly.step, Dachshund70-Case-Assembly.step, Dachshund70-Case-Bottom.step, Dachshund70-Case-Encoder-Cover.step, Dachshund70-Case-Gasket-Retainer.step, Dachshund70-Case-Top.step, Dachshund70-Case-Weight.step, Dachshund70-Case-rev2.f3d]
2026-11-10 Case: current mainboard in the model, LED guide re-aligned to D3–D7, v33 encoder hood with M2 module and M3 case screws
    - Mainboard: the Fusion model had the pre-#67 board. Its PCB body is now the current export and
    J1, J5 and one 0402 are at their current places. J1 is 17.6 from the cell, the module's M2 heads
    clear the board (0.05 in the lobe, 0.63 in the notch), and J5's cable path to the module is clear.
    Encoder, USB-C board, plate, battery and screen already matched hardware/step/.
    - LED guide: checked against D3-D7 (even 5.5 pitch). Every channel already starts on its LED's
    centre (0.00 offset), so it is unchanged.
    - Encoder cover: above the plate it is the v33 hood again, th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
    [Dachshund70-Case-Assembly.step, Dachshund70-Case-Encoder-Cover.step, Dachshund70-Case-Top.step, Dachshund70-Case-rev2.f3d]
2026-11-10 Mainboard: centre the status LEDs under the screen (D3-D7 1.25 mm left); plate LED windows follow
    D3-D7 and their caps C14-C18 move 1.25 mm in -x, to KiCad x 311.75, 317.25, 322.75,
    328.25 and 333.75 (y 130.5, still a 5.5 mm pitch), so the row is centred on the screen
    (KiCad x 322.75) and on the case's light holes. The tracks and vias between them moved
    with them; four stubs were stretched to their new pads. Zones refilled. DRC: 0 errors,
    0 unconnected; all-severity count unchanged (199). The plate is regenerated with
    gen_plate.py (LED windows follow, DRC 0) and its outline DXF re-exported.
    hardware/step/ is not re-exported here (the cloud KiCad has no 3D model libraries);
    run python hardwa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
    [Dachshund70-Plate-outline.dxf, Dachshund70-Plate.kicad_pcb, Dachshund70.kicad_pcb]
2026-11-10 Case: M2 encoder cover screws, socket-head module screws, M3 weight screws at the corners, paw-print engraving
    - Encoder cover: two M2 x 8 countersunk (DIN 965) in the same hidden ears and places (were M3 x 8);
    taps dia 1.6 to z 12.2, 5.4 of thread, 1.7 of metal round the front tap.
    - Encoder module: two M2 x 5 socket head (DIN 912); the front head is 0.15 clear in the
    mainboard's dia 4.2 lobe (was 0.05), 4.3 over the cell, 2.9 from J5.
    - Weight: four M3 countersunk (DIN 965) at the corners of the flange's ends: M3 x 6 at
    (+-102.5, 33.0) with 4.5 of thread, M3 x 5 at (+-102.5, 13.0) with 3.5 (the front corners are
    under 4 mm thick). 0.35 land in the 1.5 flange; taps dia 2.5, 1.0 of f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
    [Dachshund70-Assembly.step, Dachshund70-Case-Assembly.step, Dachshund70-Case-Bottom.step, Dachshund70-Case-Encoder-Cover.step, Dachshund70-Case-LED-Guide.step, Dachshund70-Case-Top.step, Dachshund70-Case-Weight.step, Dachshund70-Case-rev2.f3d]
2026-11-10 Plate: 24 mm gasket necks, uniform 2.8 mm branches
    NECK_WIDTH 4 -> 24 and ARM_WIDTH 1.5 -> 2.8 (the prong width), so each branch is one
    width from the neck to its tip (Tiam). The prongs move 10 mm further out from each nub
    centre; a nub now reaches 4.8 mm past the plate edge (socks 5.9). Regenerated with
    gen_plate.py (DRC 0) and the outline DXF re-exported; README updated.
    Claude-Session: https://claude.ai/code/session_01NfZpEZNyK3L746MdXXDka4
    [Dachshund70-Plate-outline.dxf, Dachshund70-Plate.kicad_pcb]
2026-11-10 Encoder cable: J1 and J5 face each other on one line under the module
    The module's J1 faced -u, into the mainboard's notch edge, so its plug could not go in and the
    cable had nowhere to run but up into the plate. J1 now faces +u (rot 270 on B.Cu, same place, pad
    row at u 1.3) and the mainboard's J5 moves 3.04 mm forward to (329.8, 49.54), on the shaft's line,
    so the cable runs straight under the module: mouths 17.6 mm apart, about 25 mm overall, 3.3 mm or
    more under the plate. Facing receptacles make a parallel-wire cable reversed, so J1's pins are
    renumbered to match (pin n to J5 pin 6 - n); the module's schematic labels follow. No MCU pin changes.
    Mainboard: J5's stubs shifted with it, it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
    [Dachshund70-Encoder.kicad_pcb, Dachshund70-Encoder.kicad_sch, Dachshund70.kicad_pcb]
2026-11-10 Plate: encoder notch runs forward to y 68.5 and on to the right edge; re-export board STEPs
    The plate floats on its socks and moves +-1 mm. The encoder cover's front ear reached 0.5 mm into
    the plate's plan under it, 0.2 under its bottom face, and the knob's underside sat 0.8 over the
    plate's top in front of the notch. The forward part of the notch now runs from x 305.25 to the
    right-hand edge and down to y 68.5 (was to x 322.25, y 67.25), which leaves room for the moved front
    mount 1.5 mm or more from the plate and no plate under the knob. Regenerated (DRC 0), outline DXF
    re-exported, README's notch, prong and sock numbers brought up to the 24 mm necks.
    hardware/step: re-exported with expo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
    [Dachshund70-Assembly.step, Dachshund70-Dongle.step, Dachshund70-Encoder.step, Dachshund70-Plate-outline.dxf, Dachshund70-Plate.kicad_pcb, Dachshund70-Plate.step, Dachshund70-USB.step, Dachshund70.step]
2026-11-10 Plate: encoder notch on forward to y 104.5, clear of the e-paper driver board
    Round 5's clash check floats the plate +-1.0 on its socks: at +1.0 it hit the e-paper driver board's
    parts, which sit 0.3 over the plate's top in the sidebar. The notch's forward part now runs from x
    305.25 to the right-hand edge down to KiCad y 104.5 (was 68.5); the sidebar keeps its plate from there
    on, with the J4 slot and the LED windows. gen_plate.py rerun (DRC 0), outline DXF and the plate and
    assembly STEPs re-exported, README updated.
    [Dachshund70-Assembly.step, Dachshund70-Case-Switch-Cap.step, Dachshund70-Plate-outline.dxf, Dachshund70-Plate.kicad_pcb, Dachshund70-Plate.step]
2026-11-10 Case round 5: 64.1 mm retainers, back M3 screws moved, cover front mount, daughterboard 1.0 lower, slider button
    In the Fusion model (version 37), for the 24 mm-neck plate and the plate floating +-1.0 on its socks:
    - Gasket retainers 64.1 x 5.2 x 4.1 (ears unchanged); one opening per nub from the ring to the sock
    tops, 64.3 x 5.3, 1.25 or more round the arms and 4.0 or more of wall to the bezel's outside. The back
    M3 x 20 screws at x -50.5 and +50.5 were in the longer bars' way and moved to x -61.35 and +39.5.
    - Encoder cover: front mount at x 131.2 with an R2.7 ear, underside at z 2.9; ear, screw and boss 1.5,
    2.9 and 1.7 from the floating plate in plan, 1.39 over the mainboard. Hood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
    [Dachshund70-Case-Assembly.step, Dachshund70-Case-Bottom.step, Dachshund70-Case-Encoder-Cover.step, Dachshund70-Case-Gasket-Retainer.step, Dachshund70-Case-Knob.step, Dachshund70-Case-LED-Guide.step, Dachshund70-Case-Ring.dxf, Dachshund70-Case-Ring.step]
2026-11-11 Screen board for the e-paper panel; J4 becomes an FFC socket
    - hardware/Dachshund70-Screen/: our own SSD1680 driver board (21 x 34 x 0.8 mm,
    2 layers, parts on the bottom): boost circuit, FH12-24S panel socket, FH12-8S
    cable socket. Generated and hand-routed by gen_screen.py; ERC 0, DRC 0.
    - Mainboard: J4 (2.54 mm header) is now an FH12-8S FFC socket at (327.9, 94.9)
    under the plate's screen notch, same pin order; the eight display nets are
    rerouted (move_j4.py records the edit). DRC: 0 unconnected, parity clean.
    - Plate: J4 slot removed (regenerated).
    - export_fab.py / export_step.py include the screen board.
    - Docs: screen board README, case README display section, firmware display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
    [Dachshund70-Plate.kicad_pcb, Dachshund70-Screen.kicad_pcb, Dachshund70-Screen.kicad_sch, Dachshund70.kicad_pcb, Dachshund70.kicad_sch]
2026-11-11 Sharp LS027B7DH01 memory LCD: screen board rev 2.0 and firmware overlay
    - Screen board rev 2.0: TPS61222 5 V boost (EN on J4-8, pulled up), FH12-10S
    panel socket (J1 pin n = panel pin 11 - n after the tail folds under the
    glass), Sharp's VDD/VDDA/DISP capacitors, EXTMODE high. Same outline and J2
    position; no mainboard change. ERC 0, DRC with parity 0.
    - Firmware: displays/sharp-ls027b7dh01-portrait.overlay (sharp,ls0xx, CS active
    high, EXTCOMIN 1 Hz), built in CI. display-rotate and kb_screen_rotate() now
    handle row-tiled 1-bit panels, with host tests for both layouts.
    - Docs: screen board README, displays README, board README, CLAUDE.md,
    PROGRESS.md, SCHEDULED_TASKS.md.
    Co-Aut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
    [Dachshund70-Screen.kicad_pcb, Dachshund70-Screen.kicad_sch]
